anastasiia-gif/MiniFactoryTCF/Code/Web_layer/pictures/wrencked_paper.png

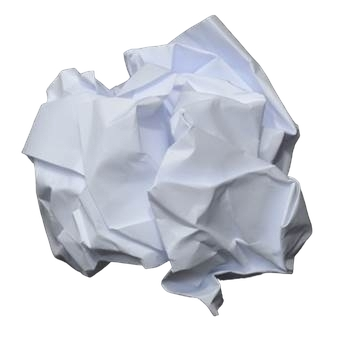
Code/Web_layer/pictures/wrencked_paper.png
