anastasiia-gif/MiniFactoryTCF/Code/Web_layer/pictures/Pneumatics.jpg

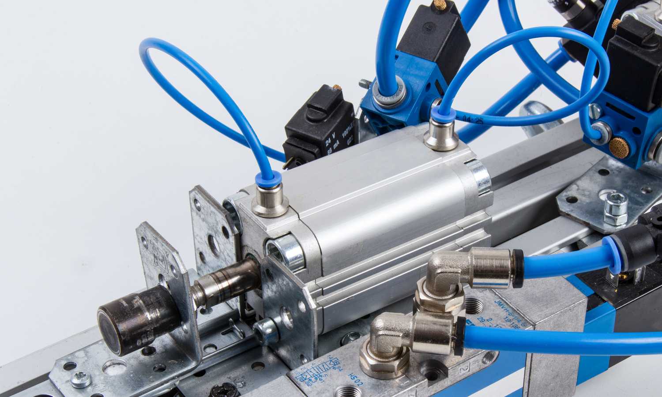
Code/Web_layer/pictures/Pneumatics.jpg
