anastasiia-gif/MiniFactoryTCF/README.md

# 📁 Project Overview – Mini Factory

Welcome to the repository for the Mini Factory educational safety and system enhancement project. This README will help you navigate the folder structure and understand where to find essential project materials.

---

## 📄 Documents Folder

This folder contains all key written reports and planning documents.

- **🔹 REP_MiniFactory** – *Recommended starting point*. This is the main report from the previous internship student and provides a comprehensive overview of the project, including safety implementation, system design, and educational use.
- **🔹 Proeve van Bekwaamheid** – An MBO-level student report referenced by the REP, with additional background and system wiring insights.
- **🔹 PoA (Plan of Approach)** – The initial planning and scoping document from the internship project.
- **🔹 RAR (Risk Assessment Report)** – Details the system’s safety risks and mitigation strategies. Most content is included in the REP.
- **🔹 URS (User Requirements Specification)** – Defines the functional and safety requirements of the system. Mainly embedded in the REP and PoA.

---

## 🛠️ Mechanical Folder

Contains all mechanical CAD files and drawings for system improvements and safety implementations.

- For **part naming and assembly clarity**, please read the [**Assembly Guide**](https://docs.google.com/document/d/1loEIo7aQlHCNWvezpFuo1hC8qLYhPY-sCpMDtRe_vX0/edit?usp=sharing).  
  This guide explains which file corresponds to which physical part and how components fit together.

---

## 📘 Manuals Folder

This includes:

- **Original Bosch Rexroth manuals** for the base Mini Factory system.  
  ⚠️ *Most documents are in German; some have been AI-translated to English for convenience.*
- **Electrical Datasheets** for both the original system and components proposed in the safety upgrade (e.g., relays, contactors, RCDs).

---

## 💻 Code Folder

Contains all software-related files for the project.

- To install or run the software, refer to the [**Software Guide**](https://docs.google.com/document/d/1KuuI0siui7qMMVfnmm_3Qqvq_9LCW6hrh1Kjbssk6QI/edit?usp=sharing).
- For UI/UX mockups and flow:
  - View **Figma page designs**: [Figma Design File](https://www.figma.com/design/H6kHGFZW4rLogu5M2iiK09/MiniFactory?node-id=0-1&t=DzG7h03NYrhDLx07-1)
  - Explore **Customer Research** insights: [Miro Board](https://miro.com/welcomeonboard/dTFMWHFZYzd6UDc4VlF6TEFZcU94RUQ3TitkV3JXTmVidDhWemlRcUMwRXdkUGlLRHpQMWlyazVMOVYzTzZrY3EyblAxSlkrNkd4YWlMUEJodjJlRnpXQWFIb2gyYnRiWEk2W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)

---

## 🏢 BoschRexroth USB

Request Bosch Rexroth USB stick with all the files from previous students how was working on this project. All the other files that were provided to us during training at Bosch Rexroth are uploaded in Bosch RTexroth folder
