anastasiia-gif/MiniFactoryTCF/BoschRexroth/MLC/Properties for variables.pdf

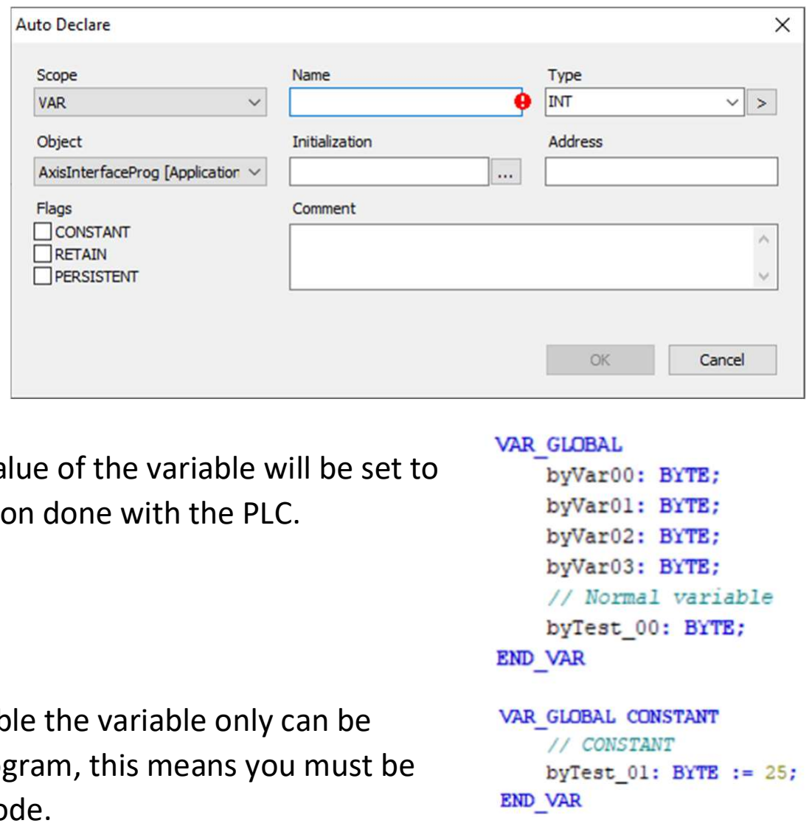
[picture p75: figure]

Document: Properties for variables.docx | Page 1 of 1

Properties for variables.

When declaring a variable there are 4 options to add to a variable.

### 1. Nothing 2. CONSTANT 3. RETAIN 4. PERSISTENT

Explanation of the options:

### 1. When added noting to a variable the value of the variable will be set to

the default* value on almost every action done with the PLC.

### 2. When added “CONSTANT” to the variable the variable only can be

modified by change it in the source program, this means you must be off-line and modify it in the software code.

### 3. When added “RETAIN” to the variable the variable keeps it value also

when the power is being switched off and after a “Warm reset”.
The value will be set to the default* value after a “Reset Origin”,
and “Reset Cold” and after repeated program download.
4. When added “PERSISTANT” to the variable “RETAIN” also must be added to the variable.
When this is done a special global variable list will be added to the system.

The value of the variable will be kept on all time, this means that it will be kept after: a reload of the program, after a download of the program, after a “Reset Warm” and even after a
“Reset Cold!
The only way to reset it to default* is after a “Reset Origin”, but the
PLC is then reset to the factory state, the PLC is completely empty,
included the program!

*Set to “Default” means: the value will bet set to 0 or to the Initialization value. = set to “0” (or “FALSE” for a BOOL) = set to “25”
