anastasiia-gif/MiniFactoryTCF/Code/Web_layer/pictures/airsoft.png

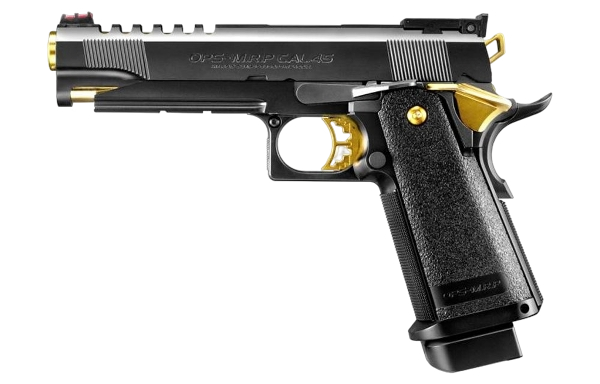
Code/Web_layer/pictures/airsoft.png
