anastasiia-gif/MiniFactoryTCF/Code/Web_layer/pictures/amusement_park.png

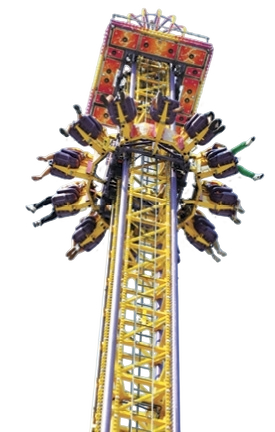
Code/Web_layer/pictures/amusement_park.png
