anastasiia-gif/MiniFactoryTCF/Code/Web_layer/pictures/angry_box.png

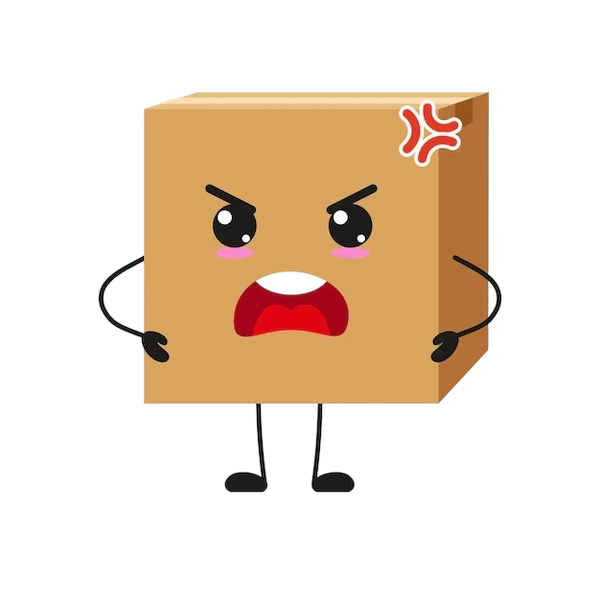
Code/Web_layer/pictures/angry_box.png
