anastasiia-gif/MiniFactoryTCF/Code/Web_layer/pictures/arrow.png

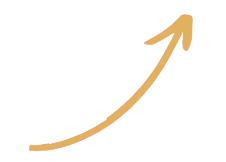
Code/Web_layer/pictures/arrow.png
