anastasiia-gif/MiniFactoryTCF/Code/Web_layer/pictures/award.png

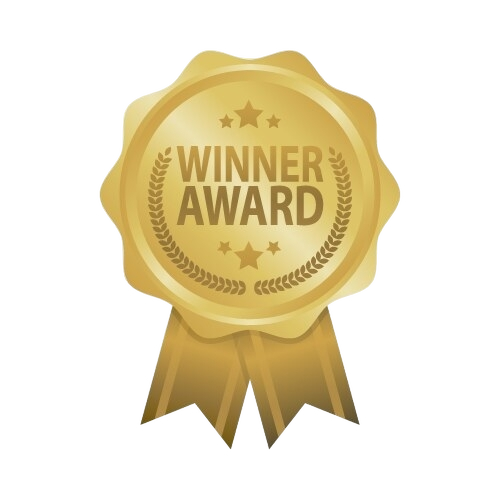
Code/Web_layer/pictures/award.png
