anastasiia-gif/MiniFactoryTCF/Code/Web_layer/pictures/beam_lifting.png

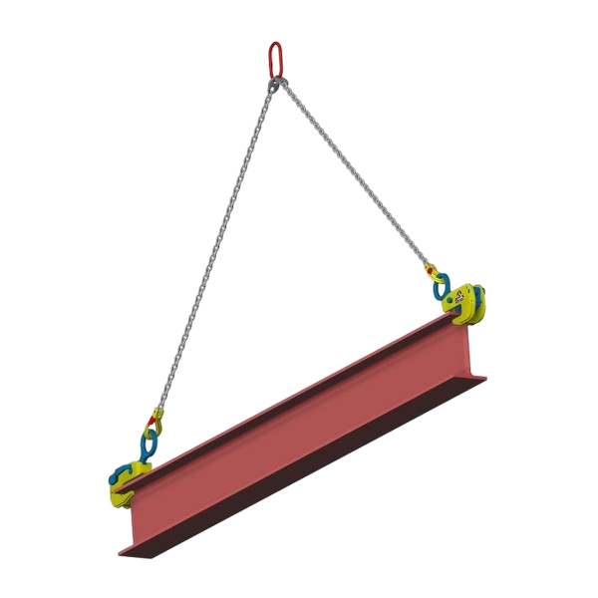
Code/Web_layer/pictures/beam_lifting.png
