anastasiia-gif/MiniFactoryTCF/Code/Web_layer/pictures/box_deposit.png

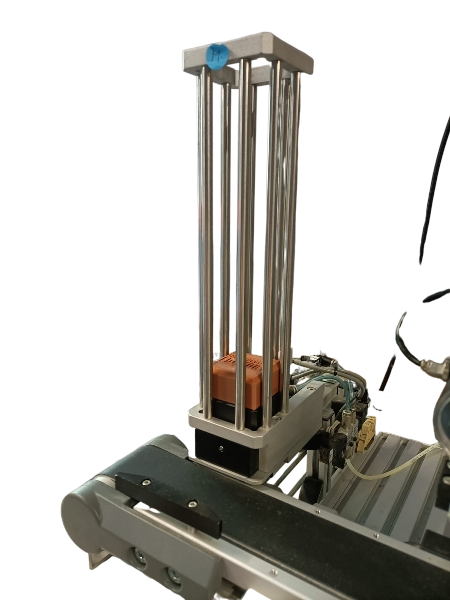
Code/Web_layer/pictures/box_deposit.png
