anastasiia-gif/MiniFactoryTCF/Code/Web_layer/pictures/button_control.png

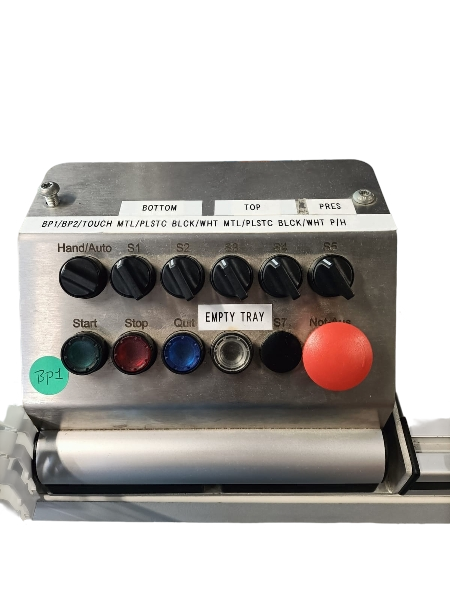
Code/Web_layer/pictures/button_control.png
