anastasiia-gif/MiniFactoryTCF/Code/Web_layer/pictures/calm_box.png

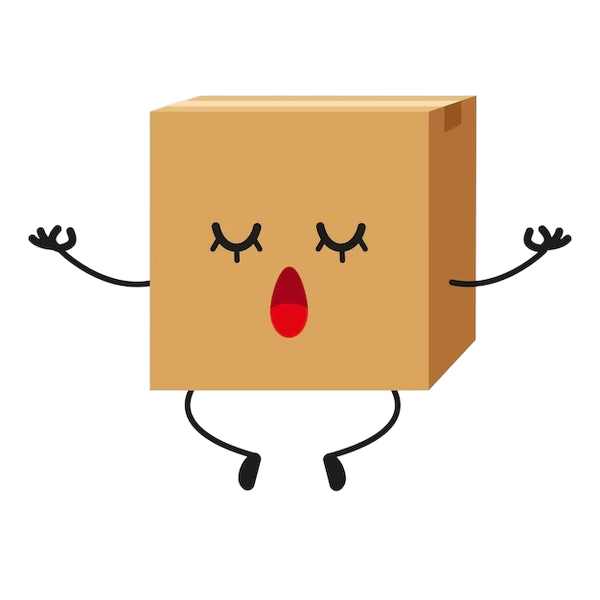
Code/Web_layer/pictures/calm_box.png
