anastasiia-gif/MiniFactoryTCF/Code/Web_layer/pictures/car_jack.png

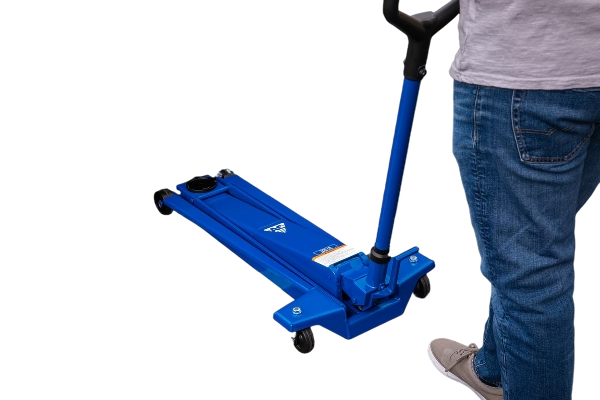
Code/Web_layer/pictures/car_jack.png
