anastasiia-gif/MiniFactoryTCF/Code/Web_layer/pictures/child_straugh.png

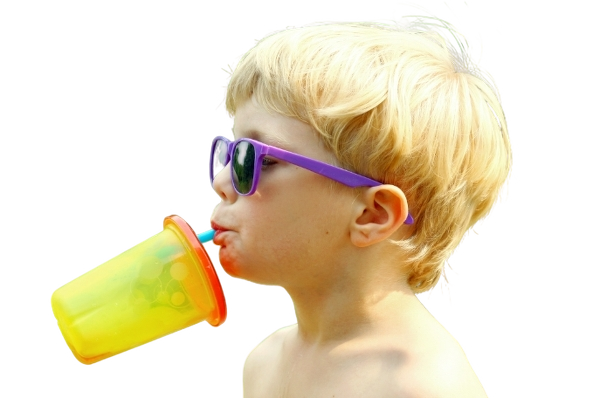
Code/Web_layer/pictures/child_straugh.png
