anastasiia-gif/MiniFactoryTCF/Code/Web_layer/pictures/cnc_door.png

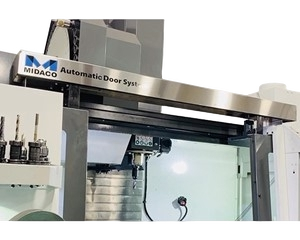
Code/Web_layer/pictures/cnc_door.png
