anastasiia-gif/MiniFactoryTCF/Code/Web_layer/pictures/confused_box.png

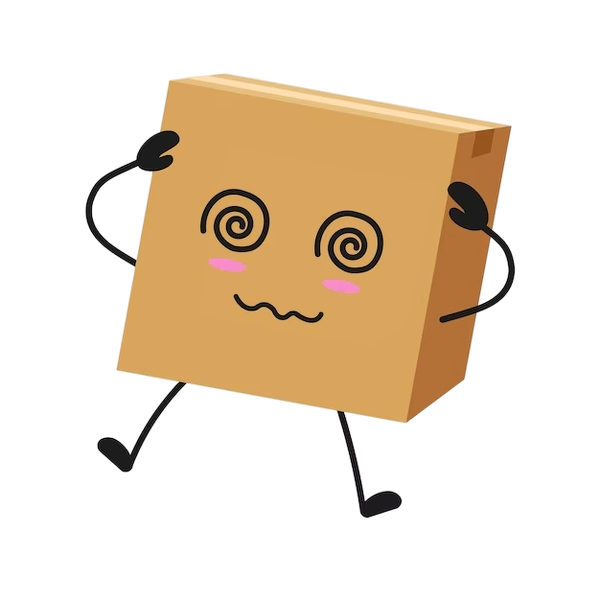
Code/Web_layer/pictures/confused_box.png
