anastasiia-gif/MiniFactoryTCF/Code/Web_layer/pictures/cool_box.png

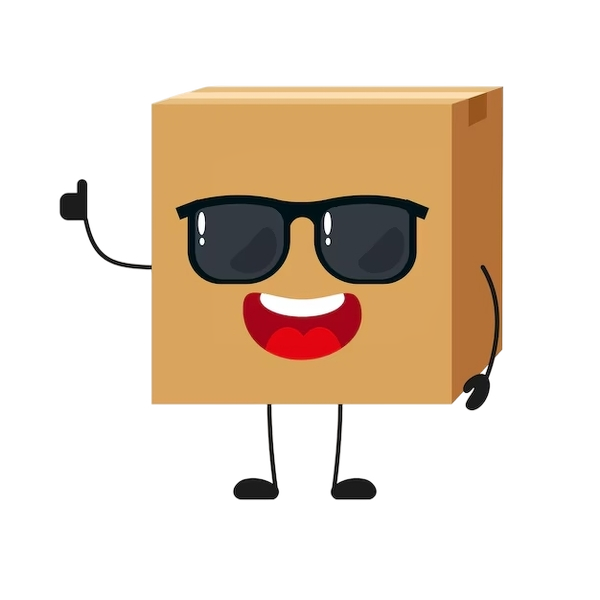
Code/Web_layer/pictures/cool_box.png
