anastasiia-gif/MiniFactoryTCF/Code/Web_layer/pictures/door_closure.png

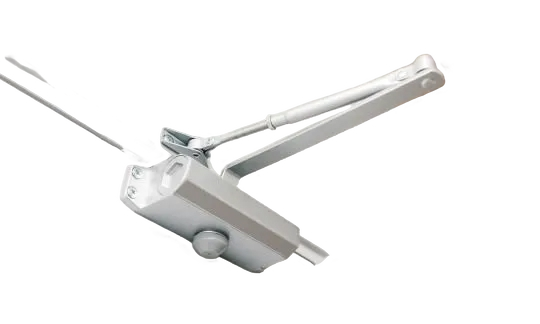
Code/Web_layer/pictures/door_closure.png
