anastasiia-gif/MiniFactoryTCF/Code/Web_layer/pictures/electric_motor.png

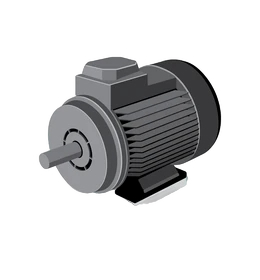
Code/Web_layer/pictures/electric_motor.png
