anastasiia-gif/MiniFactoryTCF/Code/Web_layer/pictures/Emergency_button.png

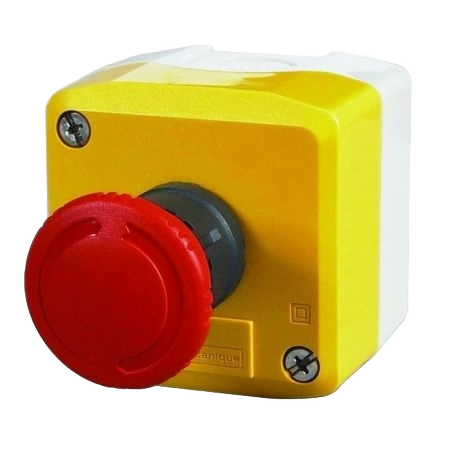
Code/Web_layer/pictures/Emergency_button.png
