anastasiia-gif/MiniFactoryTCF/Code/Web_layer/pictures/english.png

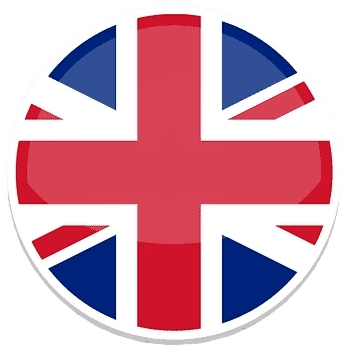
Code/Web_layer/pictures/english.png
