anastasiia-gif/MiniFactoryTCF/Code/Web_layer/pictures/exited_box.png

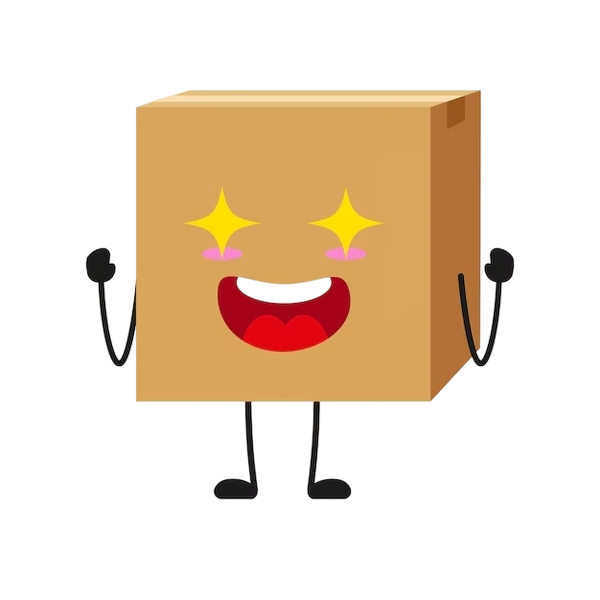
Code/Web_layer/pictures/exited_box.png
