anastasiia-gif/MiniFactoryTCF/Code/Web_layer/pictures/forklift.png

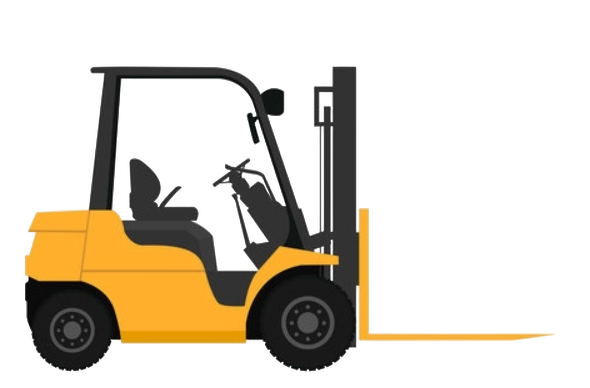
Code/Web_layer/pictures/forklift.png
