anastasiia-gif/MiniFactoryTCF/Code/Web_layer/pictures/happy_box.png

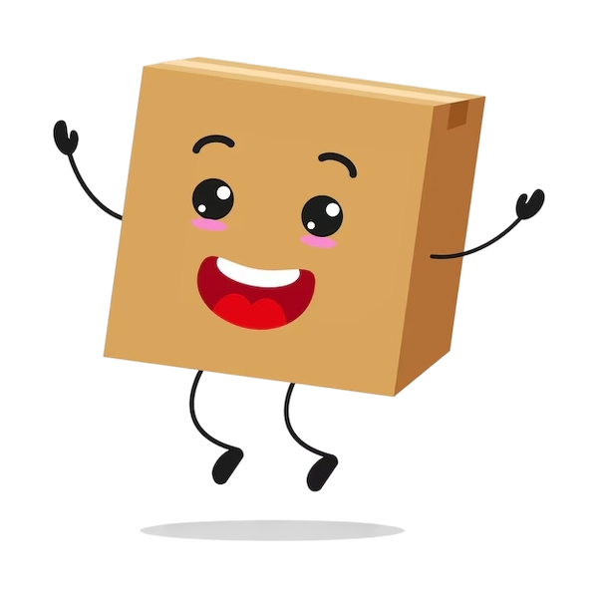
Code/Web_layer/pictures/happy_box.png
