anastasiia-gif/MiniFactoryTCF/Code/Web_layer/pictures/Hydraulics.jpg

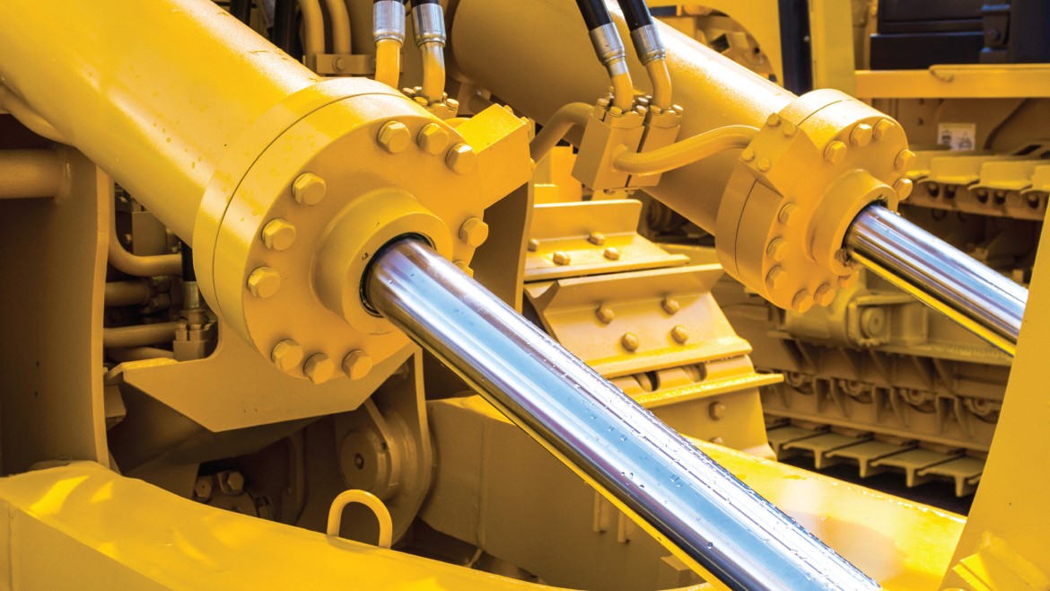
Code/Web_layer/pictures/Hydraulics.jpg
