anastasiia-gif/MiniFactoryTCF/Code/Web_layer/pictures/hydraulics_rotary.png

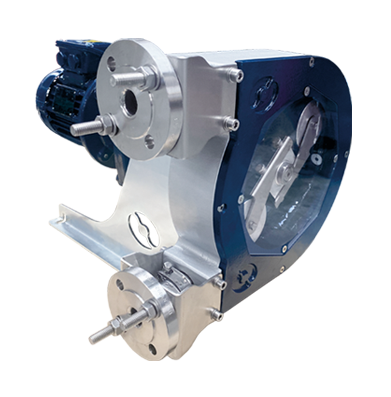
Code/Web_layer/pictures/hydraulics_rotary.png
