anastasiia-gif/MiniFactoryTCF/Code/Web_layer/pictures/linear_mover.png

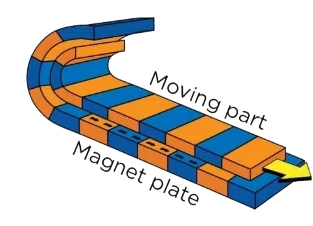
Code/Web_layer/pictures/linear_mover.png
