anastasiia-gif/MiniFactoryTCF/Code/Web_layer/pictures/magnetic_train.png

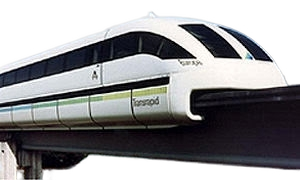
Code/Web_layer/pictures/magnetic_train.png
