anastasiia-gif/MiniFactoryTCF/Code/Web_layer/pictures/metal_box.png

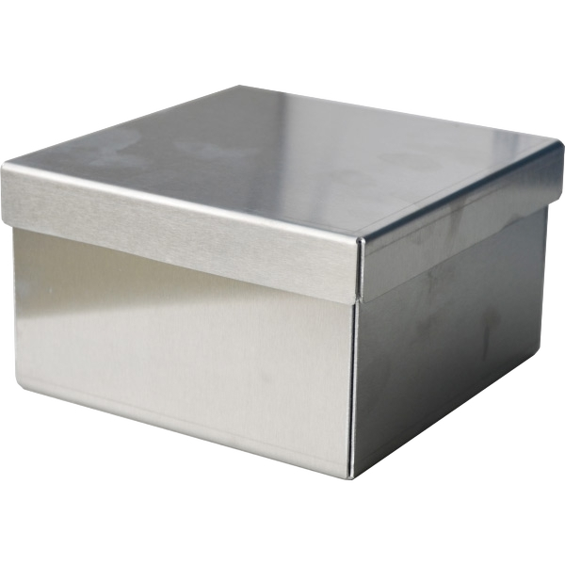
Code/Web_layer/pictures/metal_box.png
