anastasiia-gif/MiniFactoryTCF/Code/Web_layer/pictures/motor.png

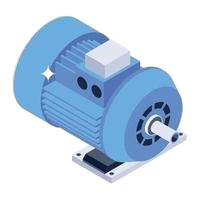
Code/Web_layer/pictures/motor.png
