anastasiia-gif/MiniFactoryTCF/Code/Web_layer/pictures/plastic_box.png

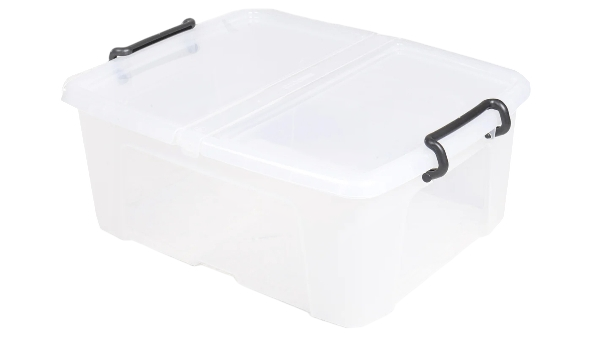
Code/Web_layer/pictures/plastic_box.png
