anastasiia-gif/MiniFactoryTCF/Code/Web_layer/pictures/plastic_cup.png

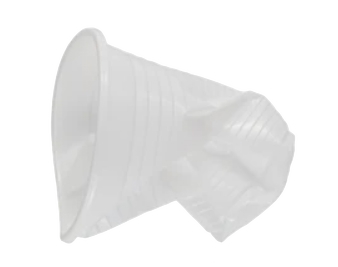
Code/Web_layer/pictures/plastic_cup.png
