anastasiia-gif/MiniFactoryTCF/Code/Web_layer/pictures/PLC.png

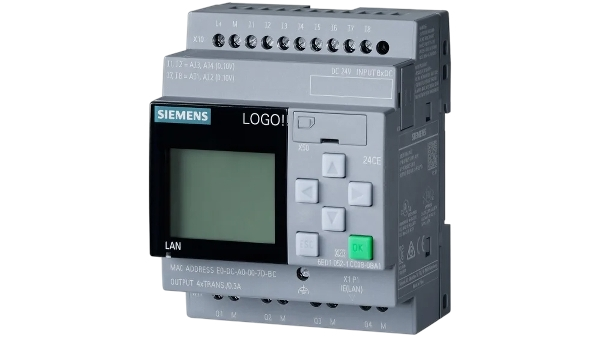
Code/Web_layer/pictures/PLC.png
