anastasiia-gif/MiniFactoryTCF/Code/Web_layer/pictures/pneumatic_cylinder.png

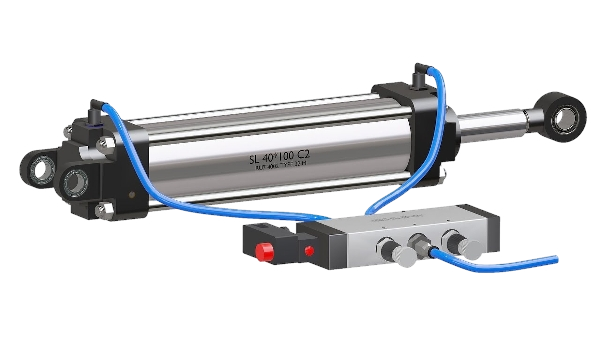
Code/Web_layer/pictures/pneumatic_cylinder.png
