anastasiia-gif/MiniFactoryTCF/Code/Web_layer/pictures/pneumatics_rotary.png

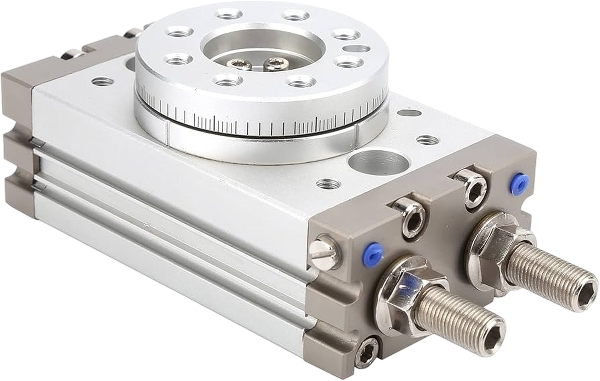
Code/Web_layer/pictures/pneumatics_rotary.png
