anastasiia-gif/MiniFactoryTCF/Code/Web_layer/pictures/RGB.png

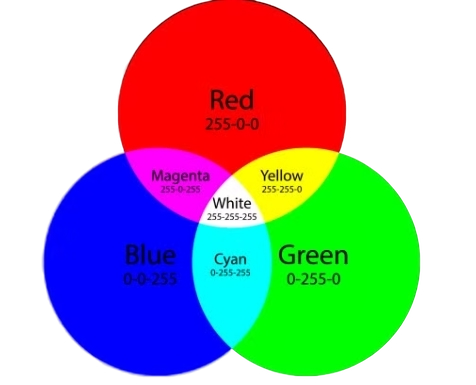
Code/Web_layer/pictures/RGB.png
