anastasiia-gif/MiniFactoryTCF/Code/Web_layer/pictures/sad_box.png

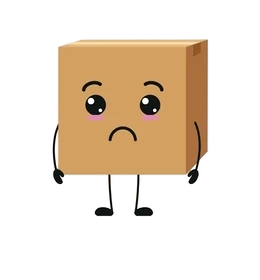
Code/Web_layer/pictures/sad_box.png
