anastasiia-gif/MiniFactoryTCF/Code/Web_layer/pictures/safety_closes.png

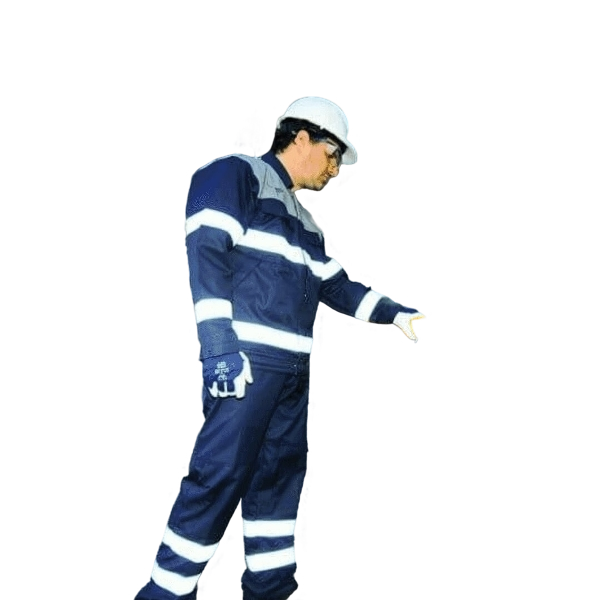
Code/Web_layer/pictures/safety_closes.png
