anastasiia-gif/MiniFactoryTCF/Code/Web_layer/pictures/safety_glasses.png

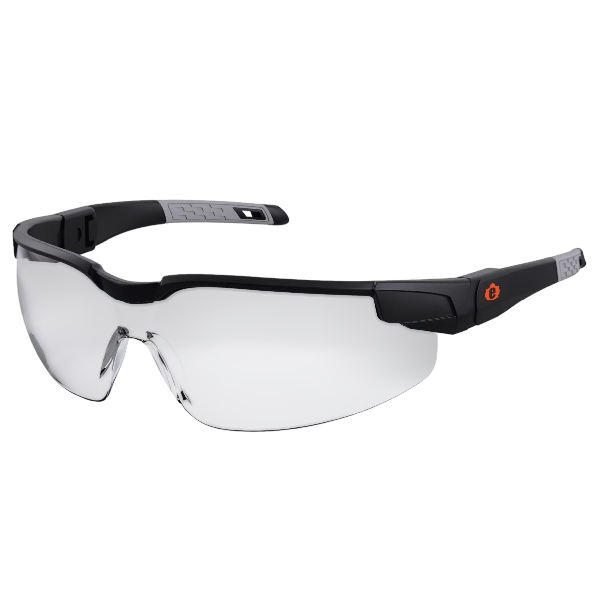
Code/Web_layer/pictures/safety_glasses.png
