anastasiia-gif/MiniFactoryTCF/Code/Web_layer/pictures/safety_gloves.png

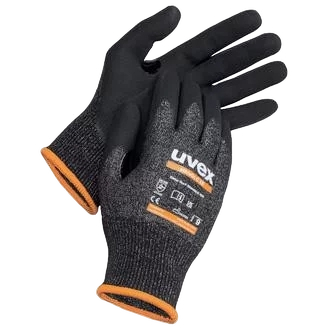
Code/Web_layer/pictures/safety_gloves.png
