anastasiia-gif/MiniFactoryTCF/Code/Web_layer/pictures/safety_shoes.png

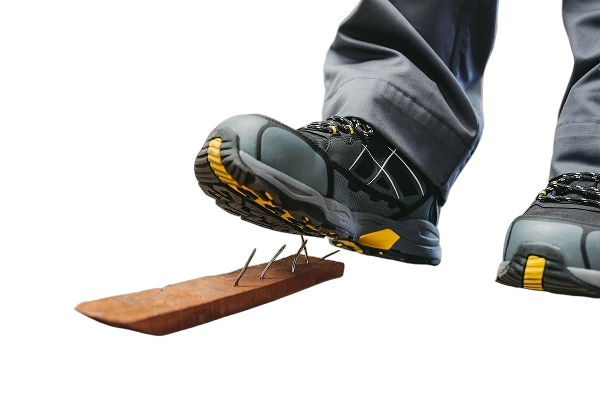
Code/Web_layer/pictures/safety_shoes.png
