anastasiia-gif/MiniFactoryTCF/Code/Web_layer/pictures/sensor.png

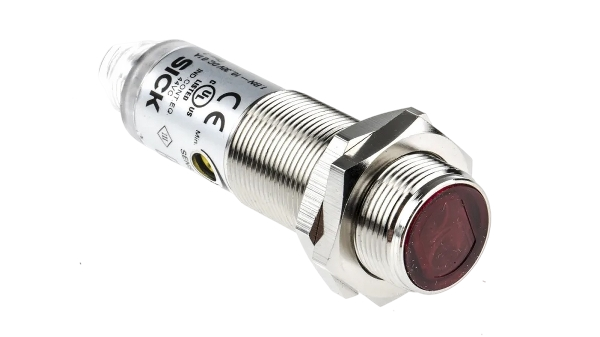
Code/Web_layer/pictures/sensor.png
