anastasiia-gif/MiniFactoryTCF/Code/Web_layer/pictures/sensors.png

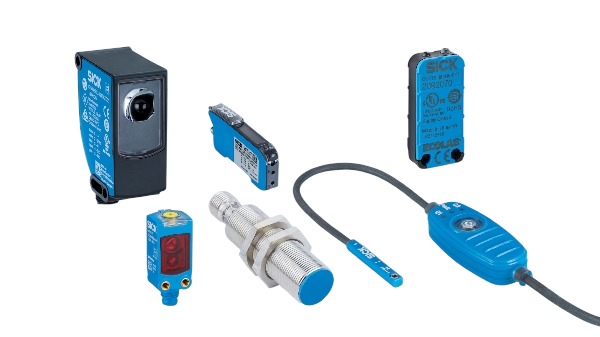
Code/Web_layer/pictures/sensors.png
