anastasiia-gif/MiniFactoryTCF/Code/Web_layer/pictures/shaping_metal.jpg

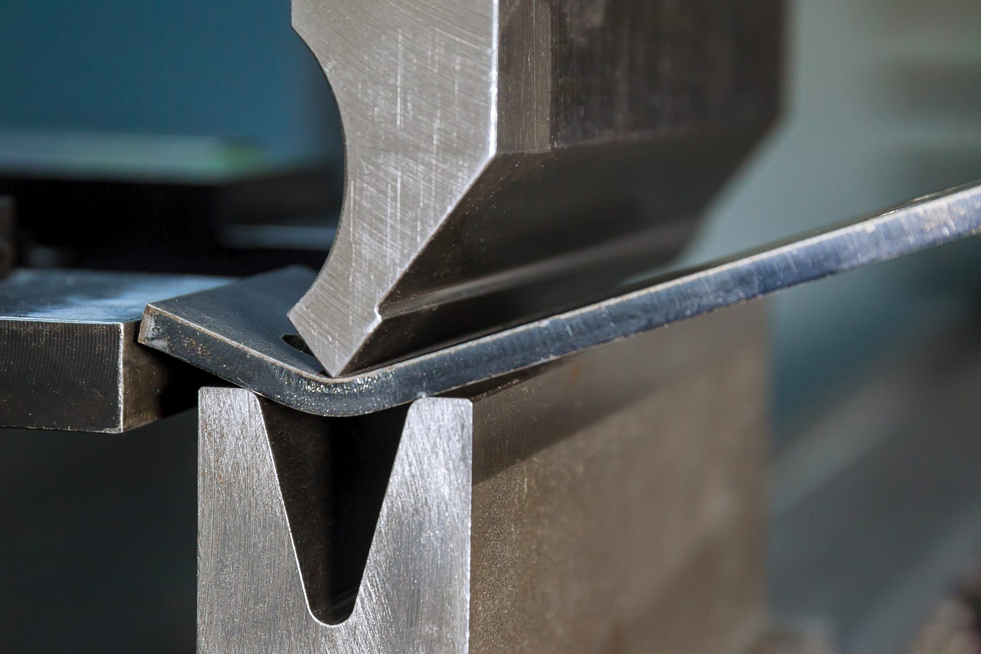
Code/Web_layer/pictures/shaping_metal.jpg
