anastasiia-gif/MiniFactoryTCF/Code/Web_layer/pictures/skyline.png

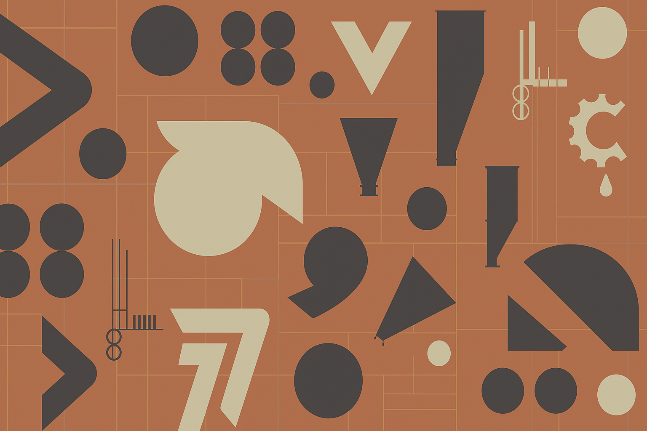
Code/Web_layer/pictures/skyline.png
