anastasiia-gif/MiniFactoryTCF/Code/Web_layer/pictures/smart_box.png

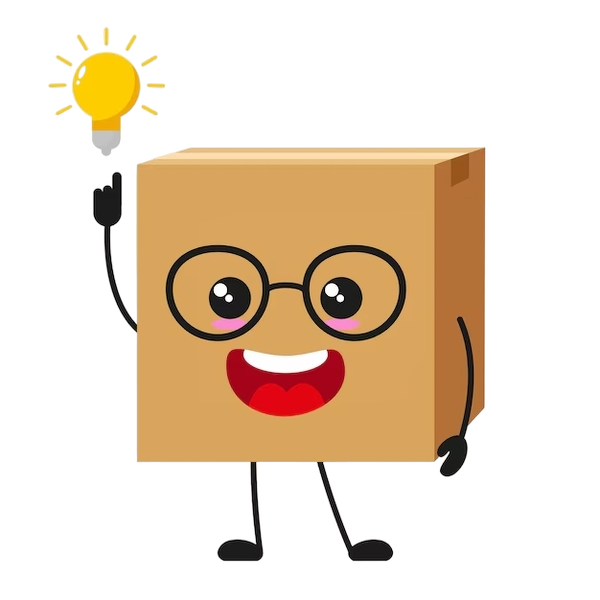
Code/Web_layer/pictures/smart_box.png
