anastasiia-gif/MiniFactoryTCF/Code/Web_layer/pictures/sponge.webp

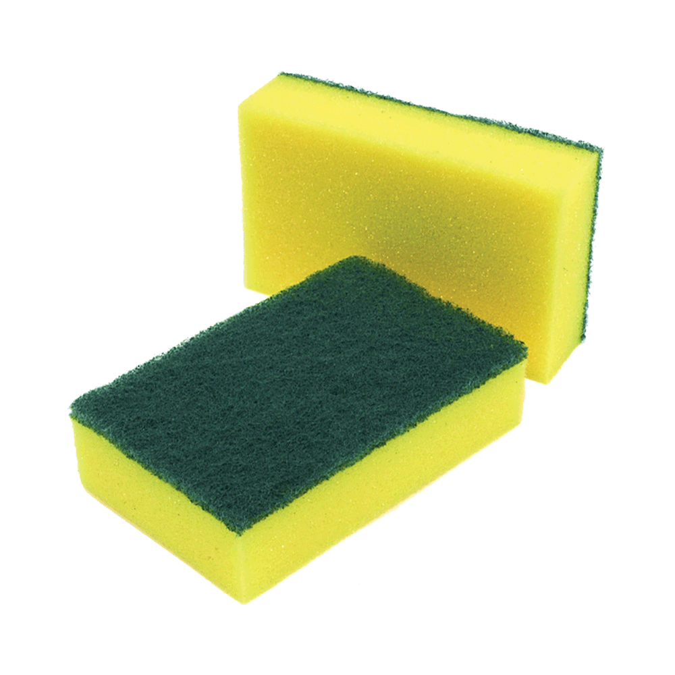
Code/Web_layer/pictures/sponge.webp
