anastasiia-gif/MiniFactoryTCF/Code/Web_layer/pictures/tractor.png

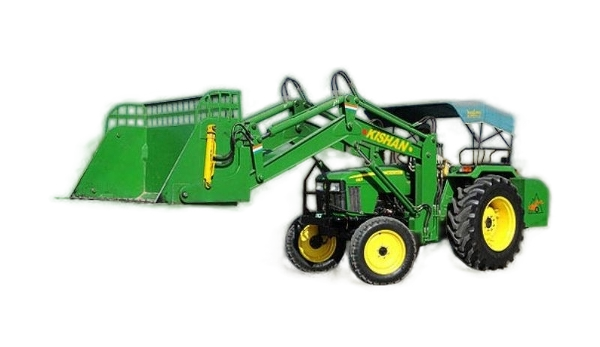
Code/Web_layer/pictures/tractor.png
