anastasiia-gif/MiniFactoryTCF/Mechanical/Safety/Main_expo/Dividers/Dividers_electrical_box/Main_exposition_inside_right_cover.SLDPRT

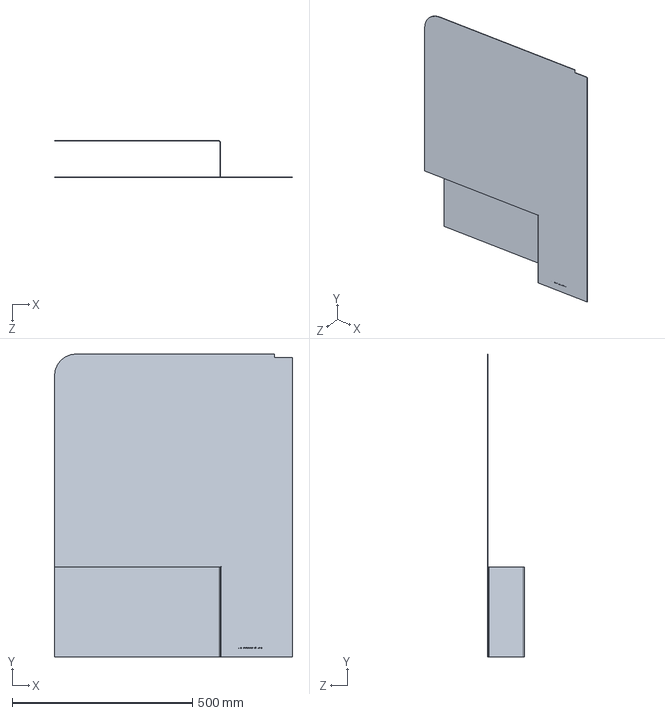
[picture p121: CAD file, 2025-07-18]
Mechanical/Safety/Main_expo/Dividers/Dividers_electrical_box/Main_exposition_inside_right_cover.SLDPRT
660.0 x 840.0 x 101.5 mm
