anastasiia-gif/MiniFactoryTCF/Mechanical/Safety/Main_expo/Dividers/Dividers_electrical_box/Manufacturable parts/Main_exposition_inside_right_cover.DXF

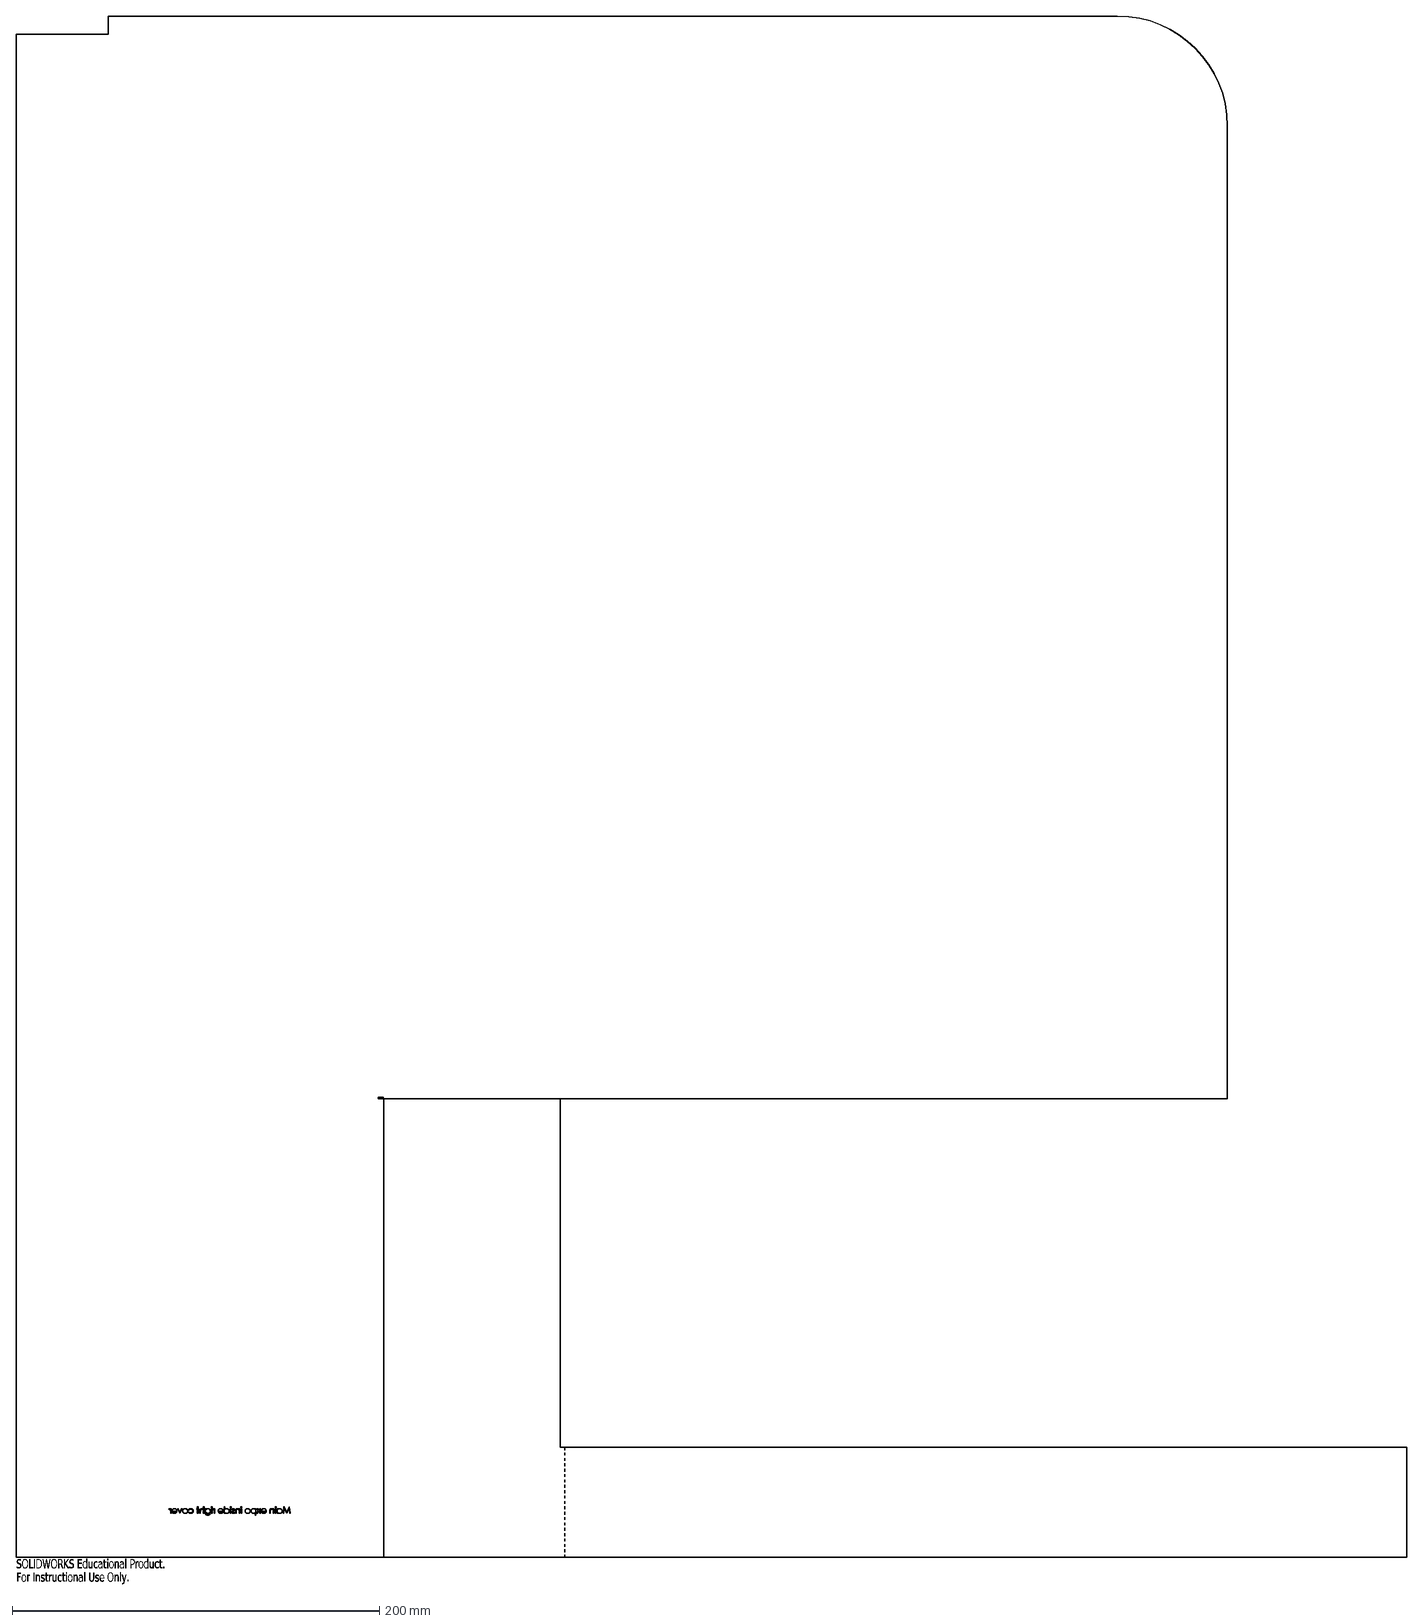
[picture p122: CAD file, 2025-07-18]
Mechanical/Safety/Main_expo/Dividers/Dividers_electrical_box/Manufacturable parts/Main_exposition_inside_right_cover.DXF
SOLIDWORKS Educational Product.
For Instructional Use Only.
