anastasiia-gif/MiniFactoryTCF/Mechanical/Safety/Main_expo/Dividers/Dividers_electrical_box/Main_exposition_inside_left_cover.SLDPRT

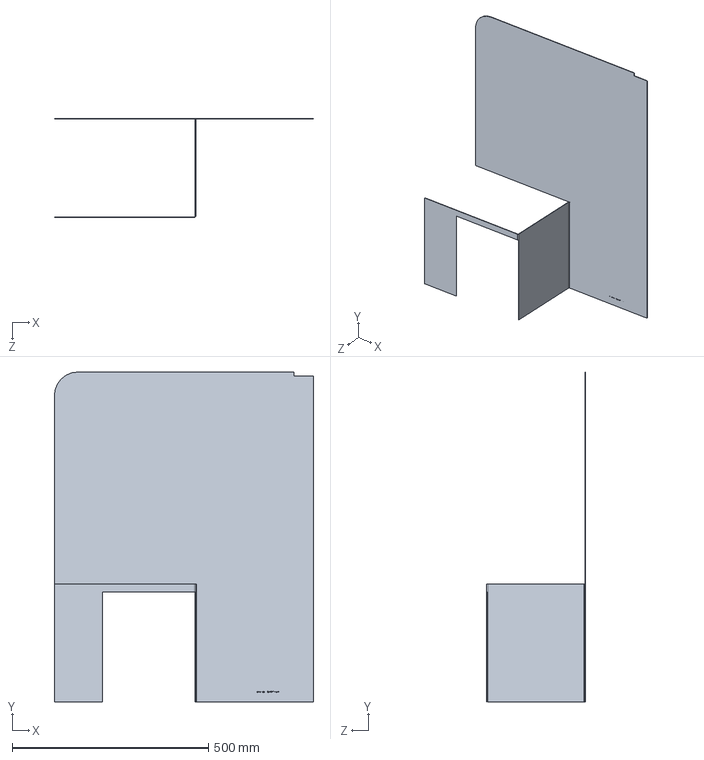
[picture p123: CAD file, 2025-05-16]
Mechanical/Safety/Main_expo/Dividers/Dividers_electrical_box/Main_exposition_inside_left_cover.SLDPRT
660.0 x 840.0 x 251.5 mm
