anastasiia-gif/MiniFactoryTCF/Mechanical/Safety/Main_expo/Dividers/Dividers_electrical_box/Manufacturable parts/Main_exposition_left_closing.DXF

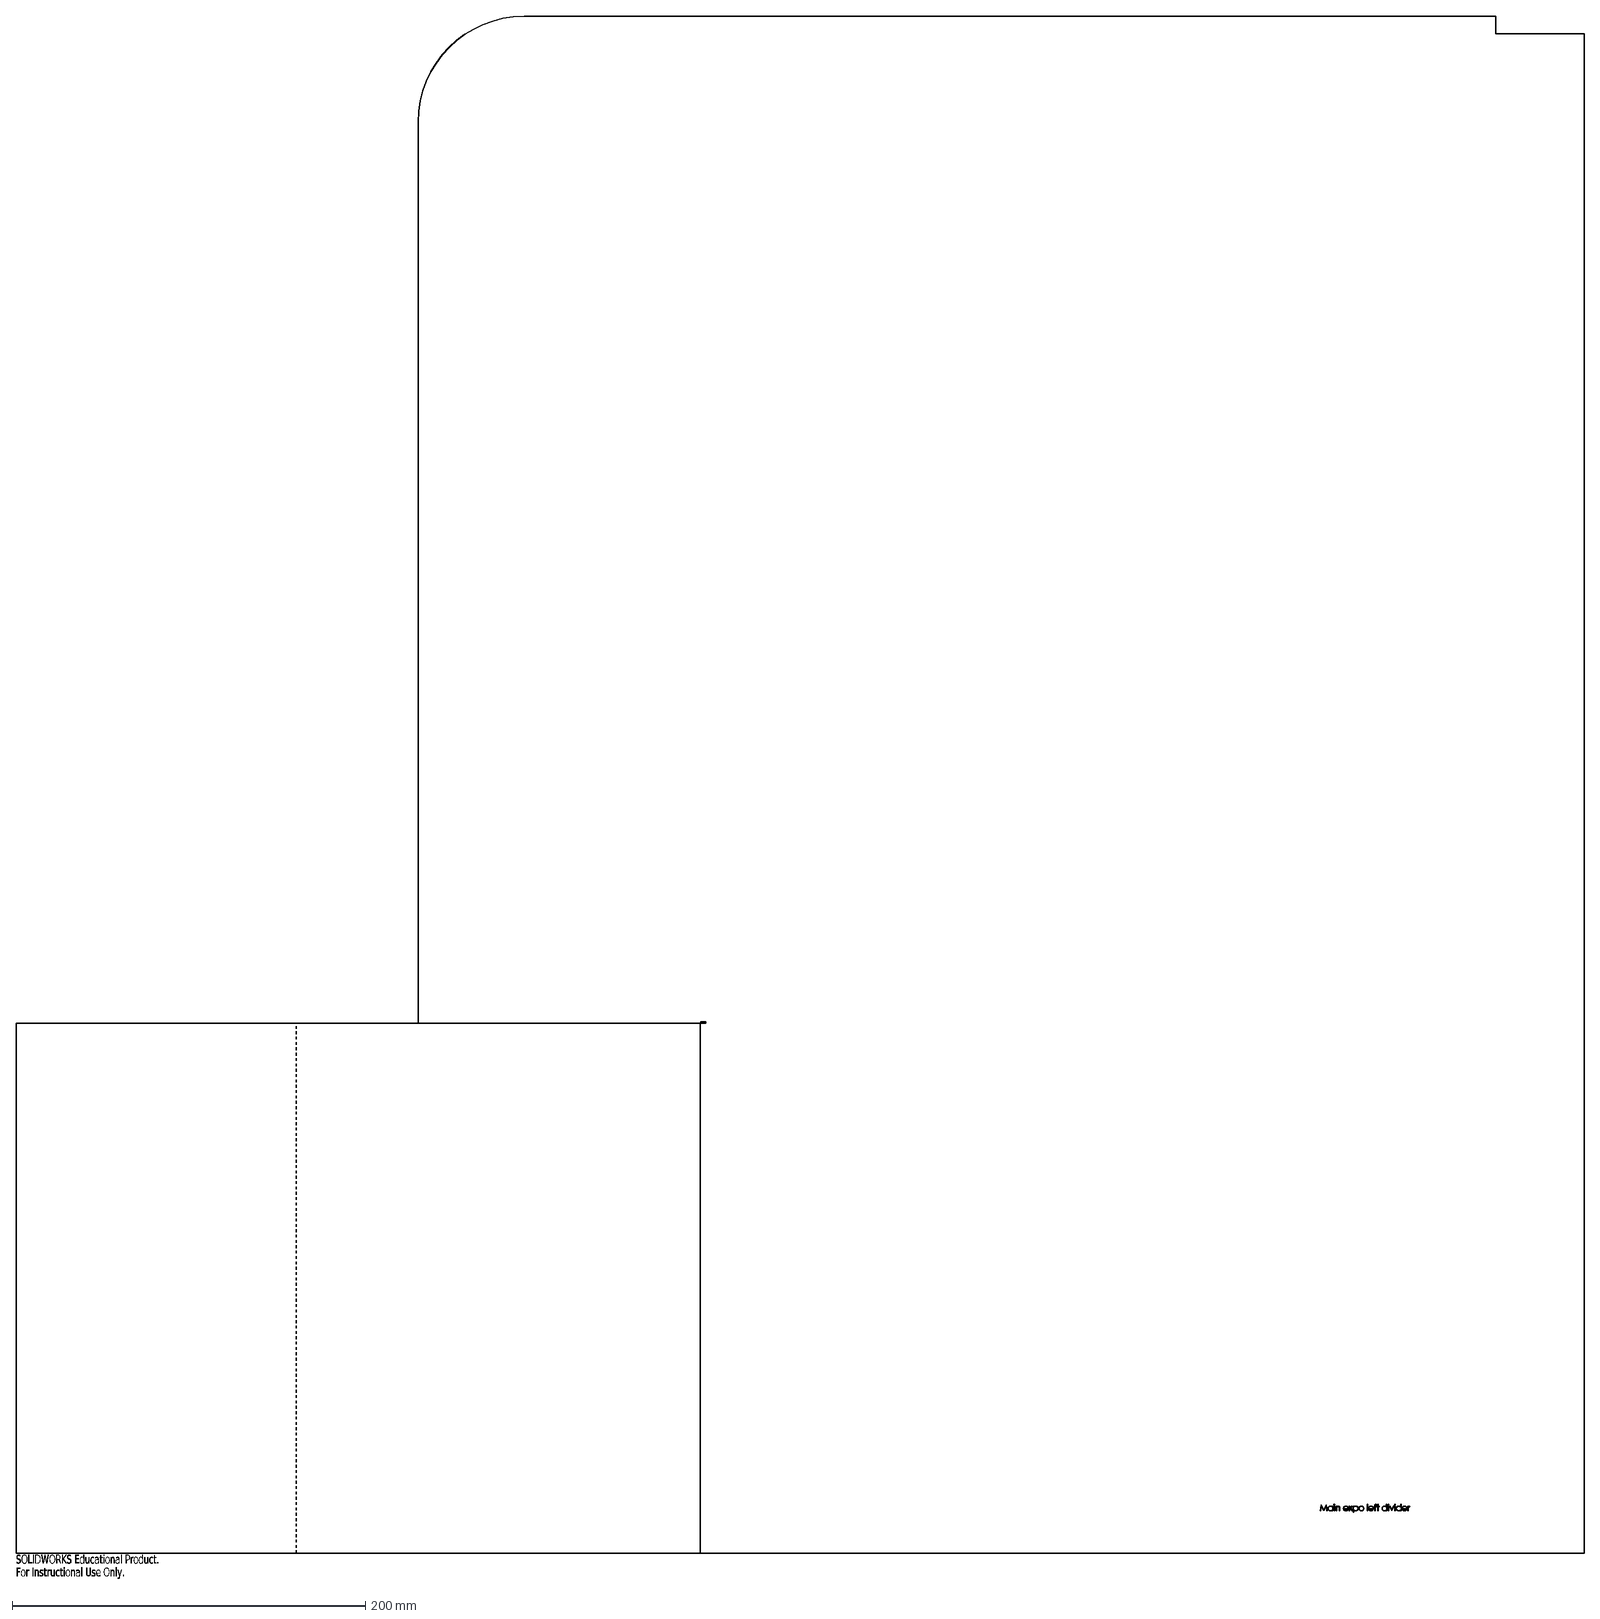
[picture p124: CAD file, 2025-05-16]
Mechanical/Safety/Main_expo/Dividers/Dividers_electrical_box/Manufacturable parts/Main_exposition_left_closing.DXF
SOLIDWORKS Educational Product.
For Instructional Use Only.
