anastasiia-gif/MiniFactoryTCF/Mechanical/Safety/Main_expo/Doors/door/Assem_door.SLDASM

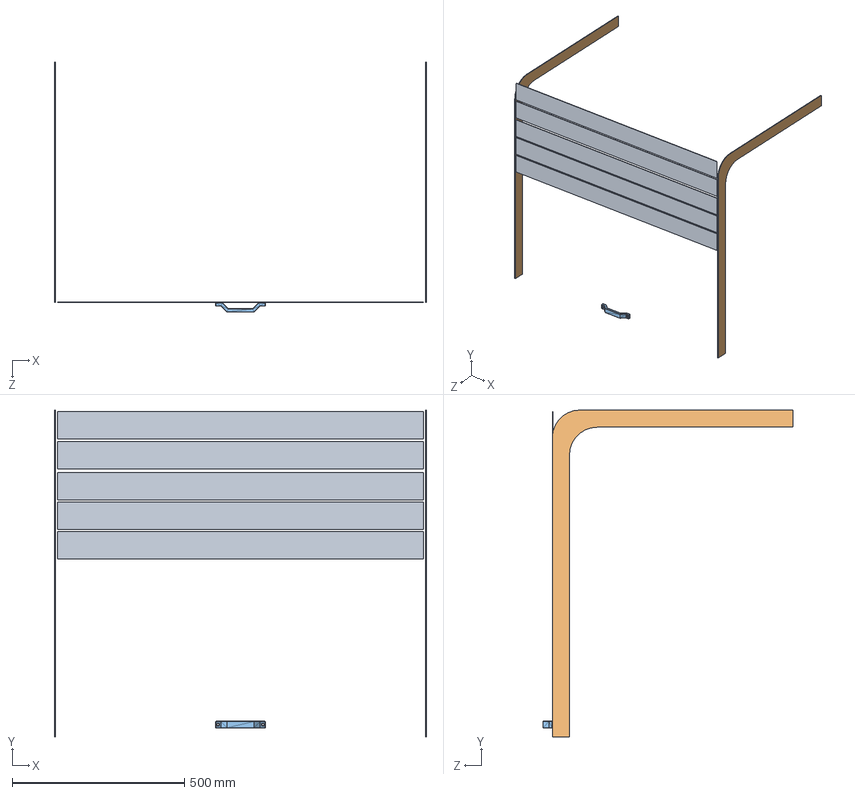
[picture p125: CAD file, 2025-05-16]
Mechanical/Safety/Main_expo/Doors/door/Assem_door.SLDASM
1081.0 x 950.0 x 727.5 mm
Barn_Door_Handle
Guide_for_doors x 2
small_screens_right_x5 x 5
