anastasiia-gif/MiniFactoryTCF/Mechanical/Safety/Main_expo/Dividers/Dividers_electrical_box/Main_expo_right_top.SLDPRT

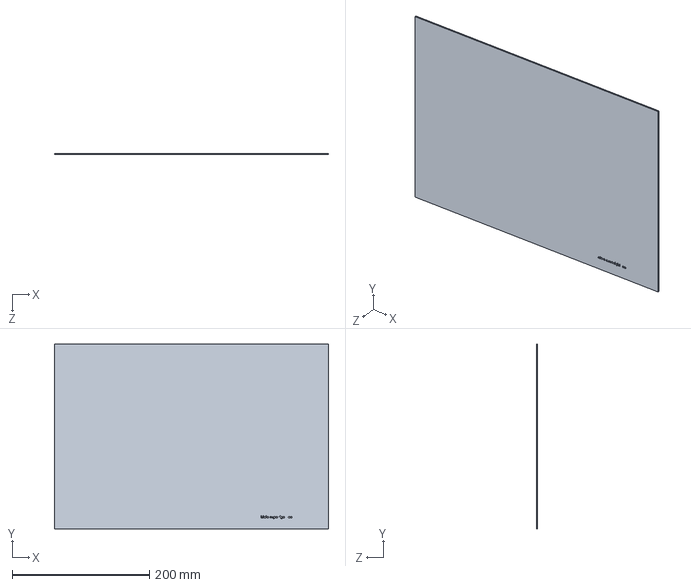
[picture p126: CAD file, 2025-05-16]
Mechanical/Safety/Main_expo/Dividers/Dividers_electrical_box/Main_expo_right_top.SLDPRT
400.0 x 270.0 x 2.00 mm
