anastasiia-gif/MiniFactoryTCF/Mechanical/Safety/Main_expo/Dividers/Dividers_electrical_box/Manufacturable parts/Main_expo_inside_left_top.DXF

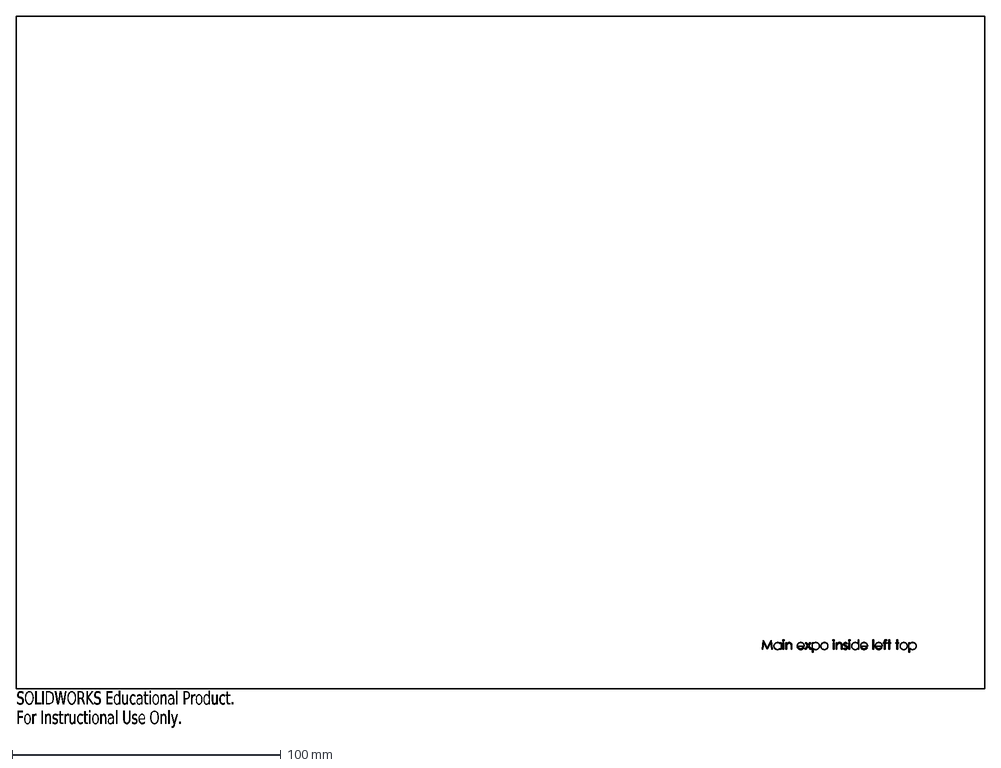
[picture p127: CAD file, 2025-05-16]
Mechanical/Safety/Main_expo/Dividers/Dividers_electrical_box/Manufacturable parts/Main_expo_inside_left_top.DXF
SOLIDWORKS Educational Product.
For Instructional Use Only.
