anastasiia-gif/MiniFactoryTCF/Mechanical/Safety/Main_expo/Dividers/Dividers_electrical_box/Assembly_main_expo.SLDASM

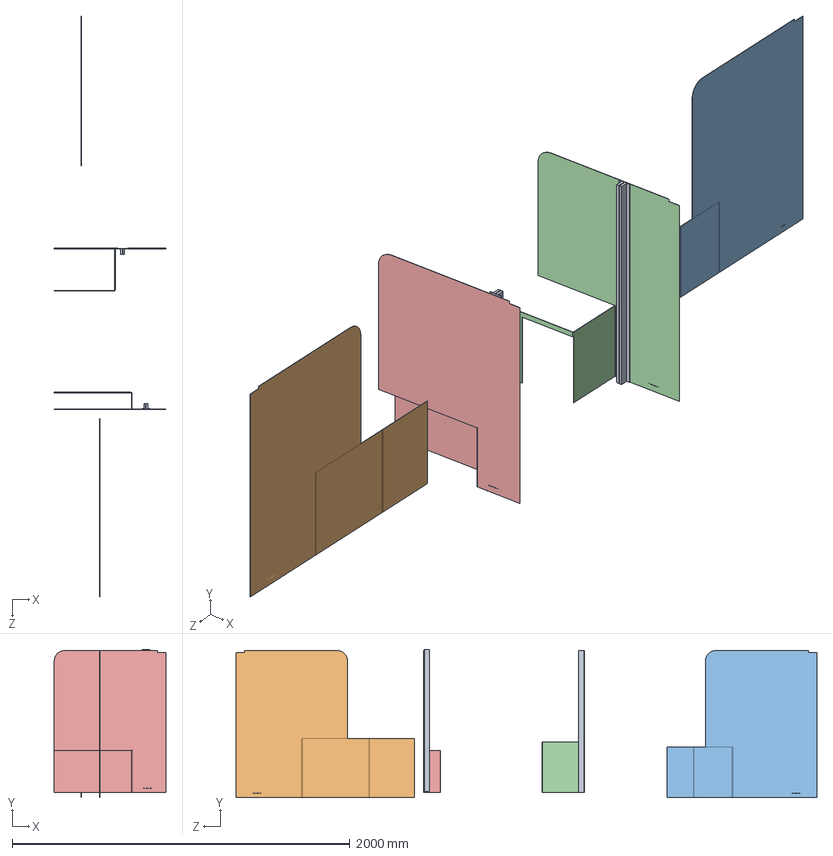
[picture p128: CAD file, 2025-05-16]
Mechanical/Safety/Main_expo/Dividers/Dividers_electrical_box/Assembly_main_expo.SLDASM
660.0 x 876.9 x 3438.5 mm
Main_exposition_inside_right_cover
Main_exposition_inside_left_cover
Main_exposition_left_closing
Main_exposition_right_closing
Railing_electrical_box x 2
