anastasiia-gif/MiniFactoryTCF/Mechanical/Safety/Main_expo/Dividers/Dividers_electrical_box/Main_exposition_left_closing.SLDPRT

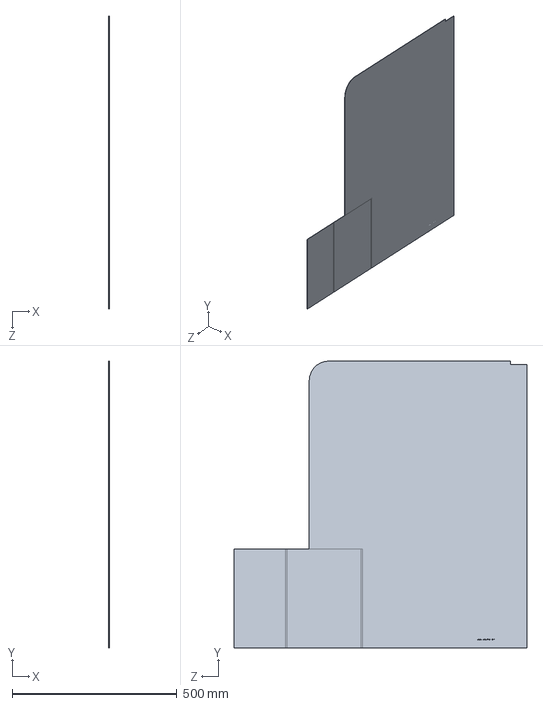
[picture p130: CAD file, 2025-05-16]
Mechanical/Safety/Main_expo/Dividers/Dividers_electrical_box/Main_exposition_left_closing.SLDPRT
1.50 x 870.0 x 887.6 mm
