anastasiia-gif/MiniFactoryTCF/Mechanical/Main_expo_sides/Back decorations/dxf_manufacturing/Main_cover_body.DXF

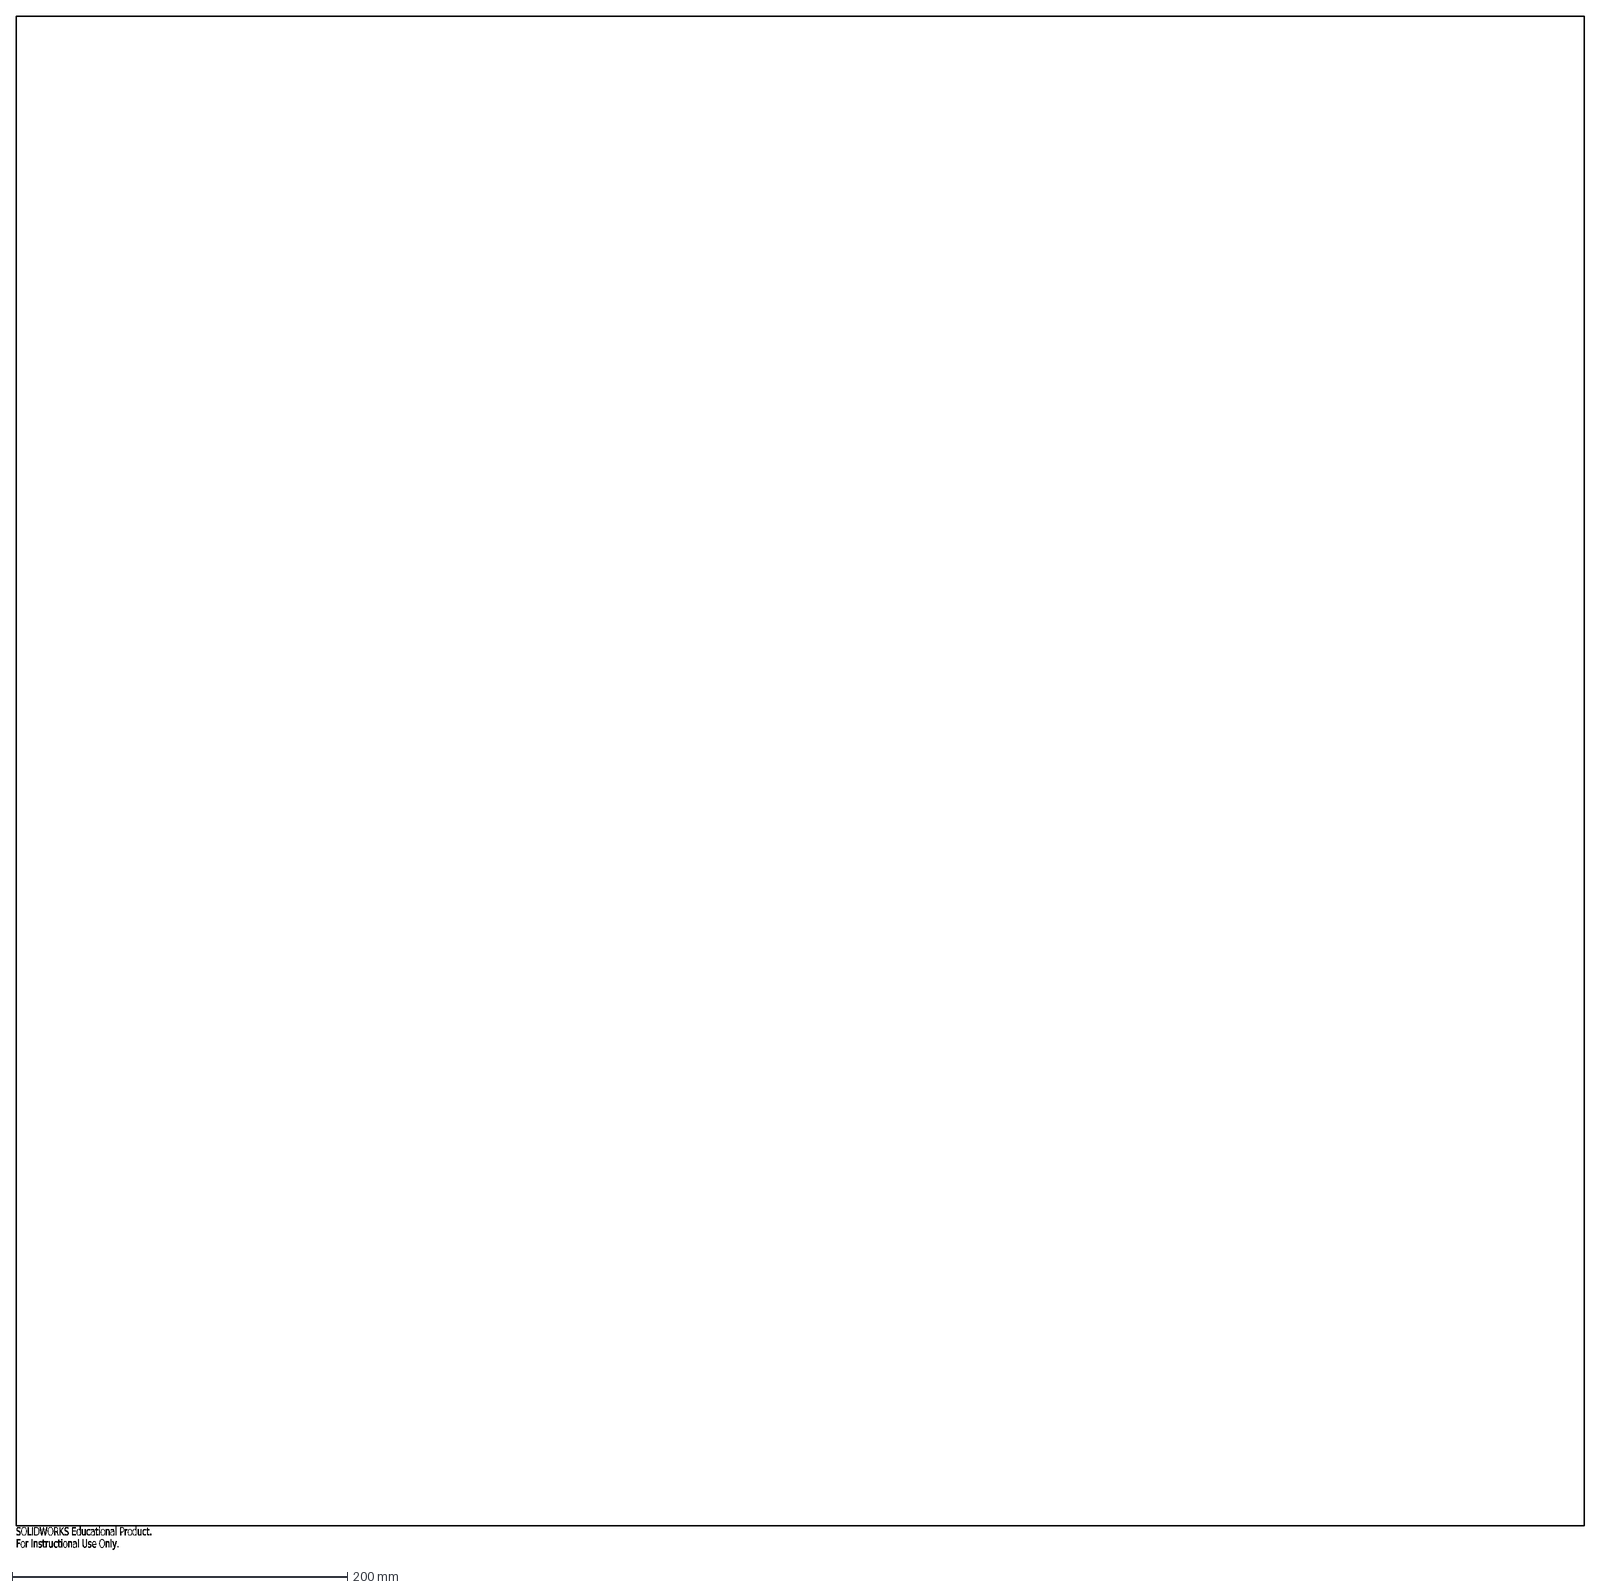
[picture p132: CAD file, 2025-05-16]
Mechanical/Main_expo_sides/Back decorations/dxf_manufacturing/Main_cover_body.DXF
SOLIDWORKS Educational Product.
For Instructional Use Only.
