anastasiia-gif/MiniFactoryTCF/Mechanical/Safety/Main_expo/Dividers/Dividers_electrical_box/Main_exposition_right_closing.SLDPRT

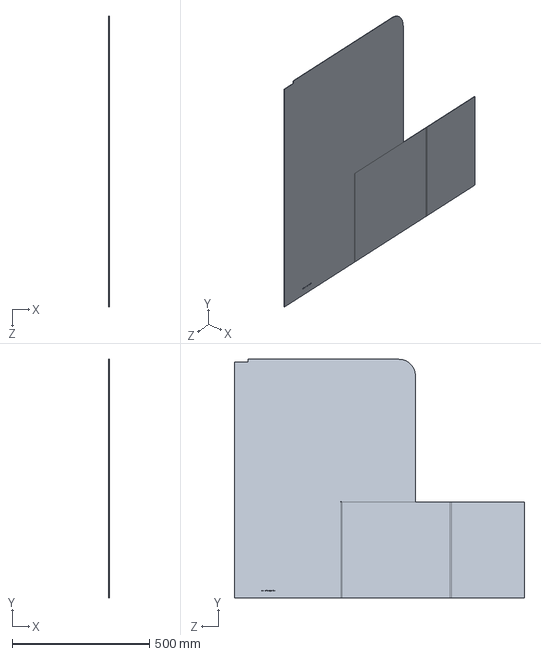
[picture p133: CAD file, 2025-05-16]
Mechanical/Safety/Main_expo/Dividers/Dividers_electrical_box/Main_exposition_right_closing.SLDPRT
1.50 x 870.0 x 1057.6 mm
