anastasiia-gif/MiniFactoryTCF/Mechanical/Safety/Main_expo/Dividers/Dividers_electrical_box/Manufacturable parts/Main_exposition_inside_left_cover.DXF

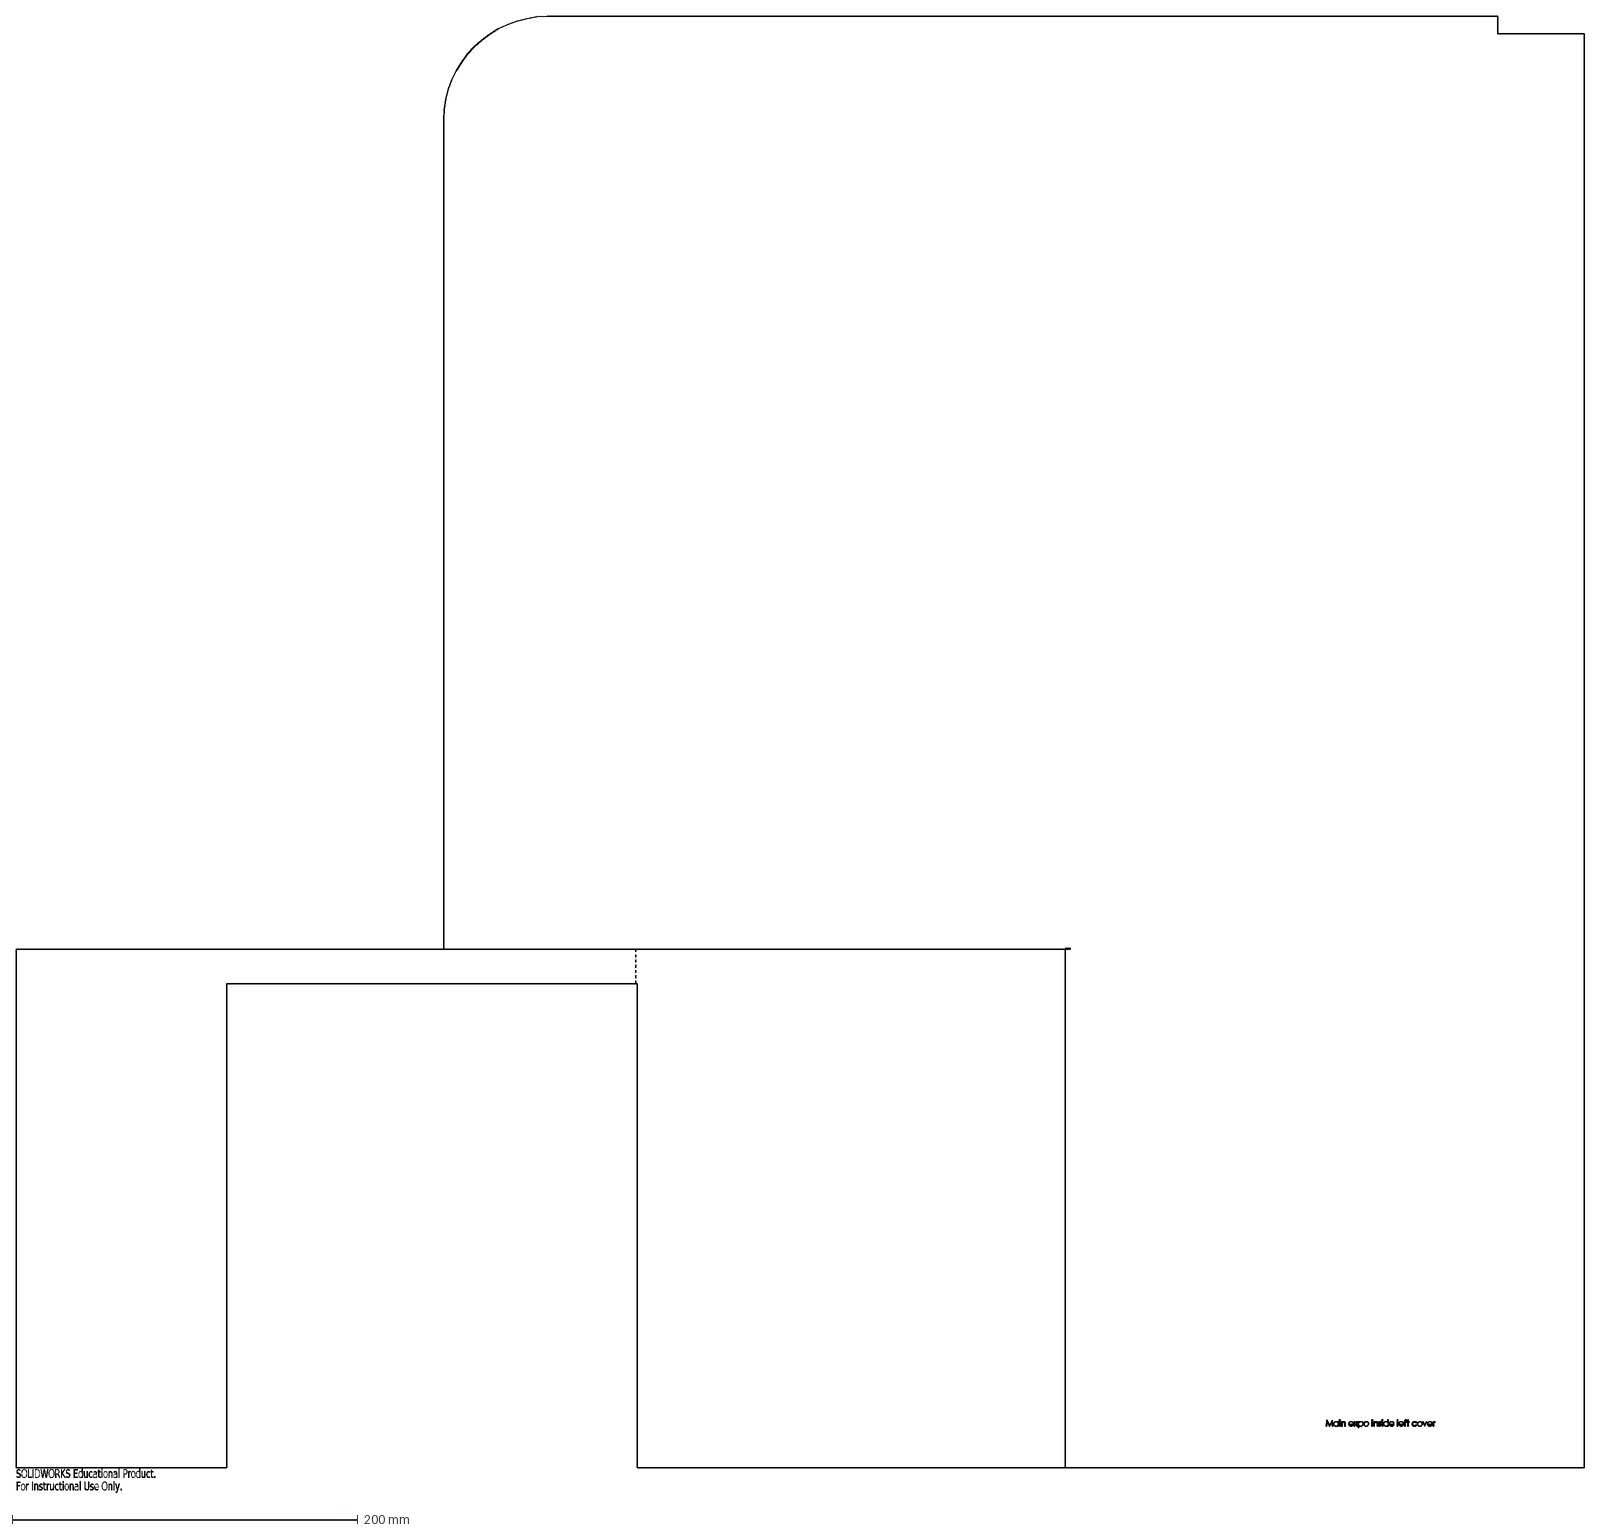
[picture p134: CAD file, 2025-05-16]
Mechanical/Safety/Main_expo/Dividers/Dividers_electrical_box/Manufacturable parts/Main_exposition_inside_left_cover.DXF
SOLIDWORKS Educational Product.
For Instructional Use Only.
