anastasiia-gif/MiniFactoryTCF/Mechanical/Safety/Main_expo/Dividers/Dividers_electrical_box/Main_expo_inside_left_top.SLDPRT

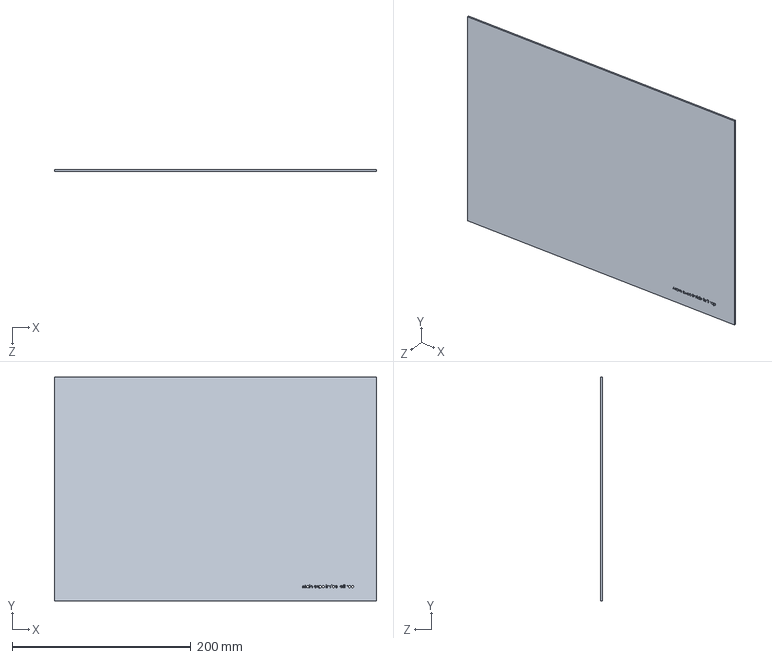
[picture p135: CAD file, 2025-05-16]
Mechanical/Safety/Main_expo/Dividers/Dividers_electrical_box/Main_expo_inside_left_top.SLDPRT
360.0 x 250.0 x 2.00 mm
