anastasiia-gif/MiniFactoryTCF/Mechanical/Main_expo_sides/Back decorations/Main_cover_body.SLDPRT

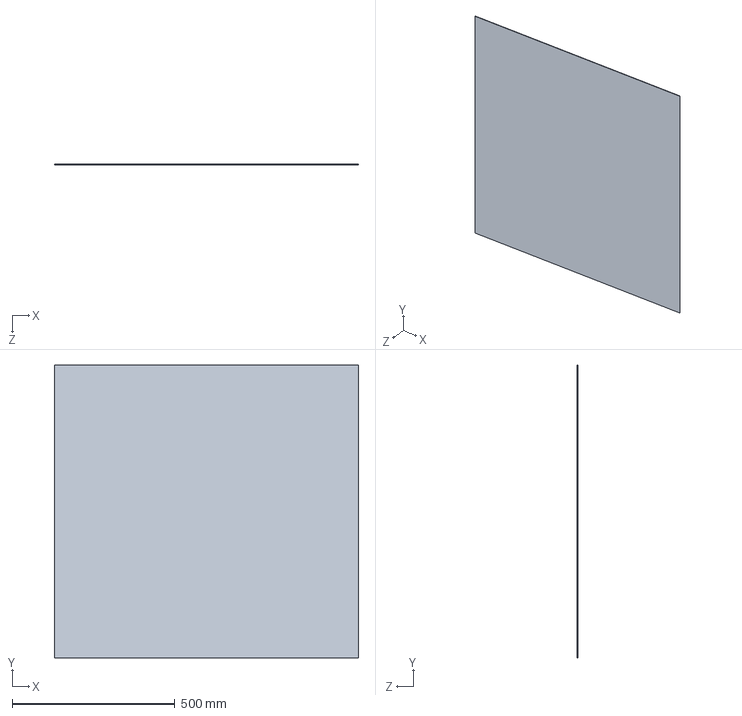
[picture p136: CAD file, 2025-05-16]
Mechanical/Main_expo_sides/Back decorations/Main_cover_body.SLDPRT
935.0 x 900.0 x 2.00 mm
