anastasiia-gif/MiniFactoryTCF/Mechanical/Box_design/manufacturable_parts/Holder_for_boxes.STL

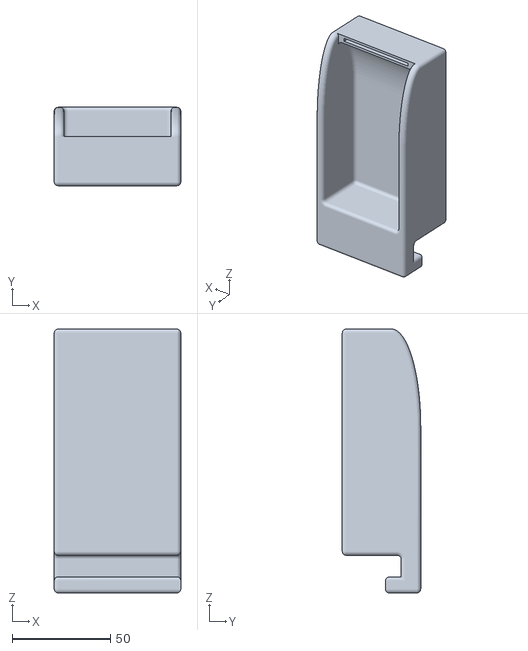
[picture p137: CAD file, 2025-05-16]
Mechanical/Box_design/manufacturable_parts/Holder_for_boxes.STL
64.5 x 40.0 x 134.5
