anastasiia-gif/MiniFactoryTCF/Mechanical/Electrical_covers/manufacturable parts/motor_electronics_cover.STL

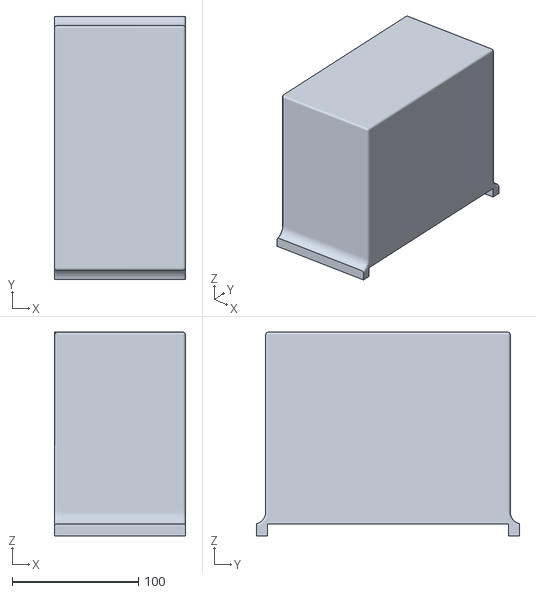
[picture p138: CAD file, 2025-07-23]
Mechanical/Electrical_covers/manufacturable parts/motor_electronics_cover.STL
104.0 x 208.6 x 161.5
