anastasiia-gif/MiniFactoryTCF/Mechanical/Main_expo_sides/Back decorations/dxf_manufacturing/robotic_arm_box.DXF

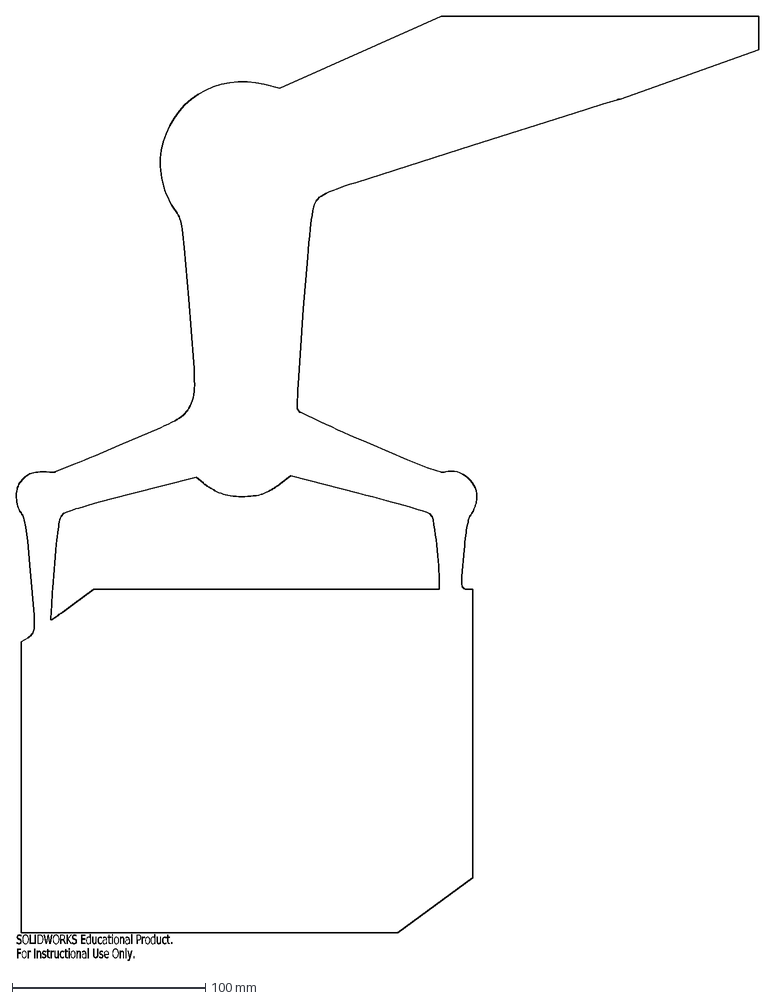
[picture p139: CAD file, 2025-05-16]
Mechanical/Main_expo_sides/Back decorations/dxf_manufacturing/robotic_arm_box.DXF
SOLIDWORKS Educational Product.
For Instructional Use Only.
