anastasiia-gif/MiniFactoryTCF/Mechanical/Main_expo_sides/Back decorations/logo.SLDPRT

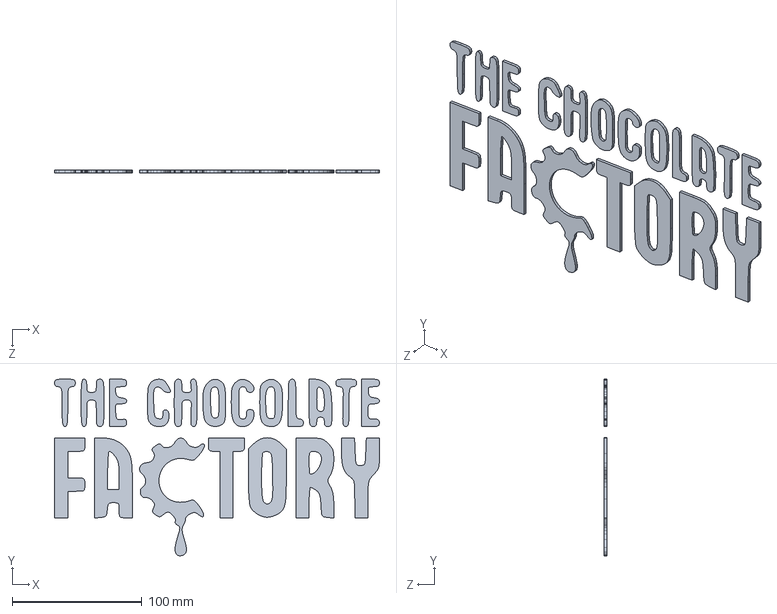
[picture p140: CAD file, 2025-05-16]
Mechanical/Main_expo_sides/Back decorations/logo.SLDPRT
250.0 x 136.0 x 2.00 mm
