anastasiia-gif/MiniFactoryTCF/Mechanical/Safety/Main_expo/Doors/door/manufacturable parts/big_screen_middle.DXF

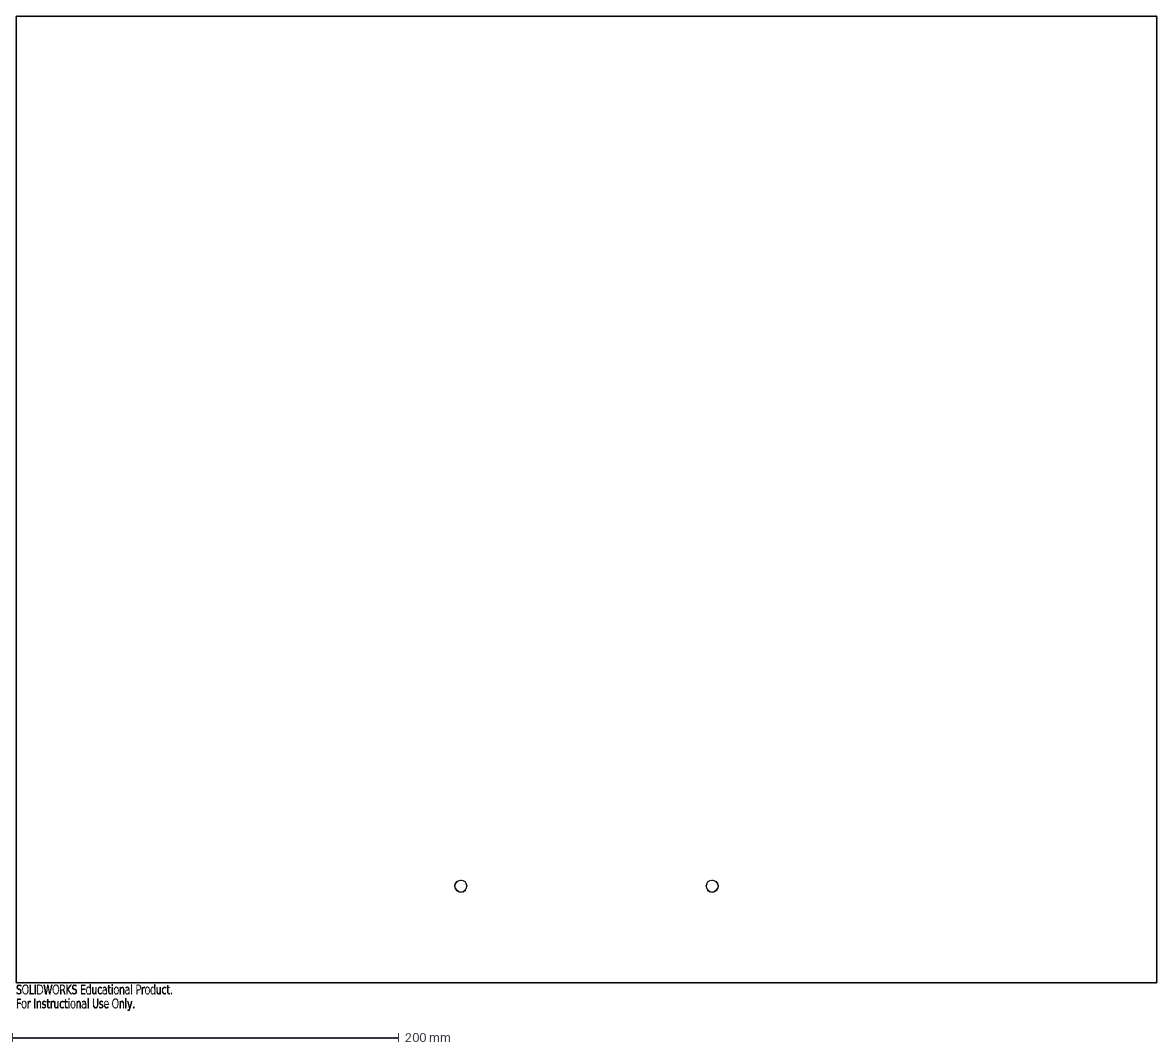
[picture p141: CAD file, 2025-05-16]
Mechanical/Safety/Main_expo/Doors/door/manufacturable parts/big_screen_middle.DXF
SOLIDWORKS Educational Product.
For Instructional Use Only.
