anastasiia-gif/MiniFactoryTCF/Mechanical/Safety/Main_expo/Doors/door/small_screens_right_x5.SLDPRT

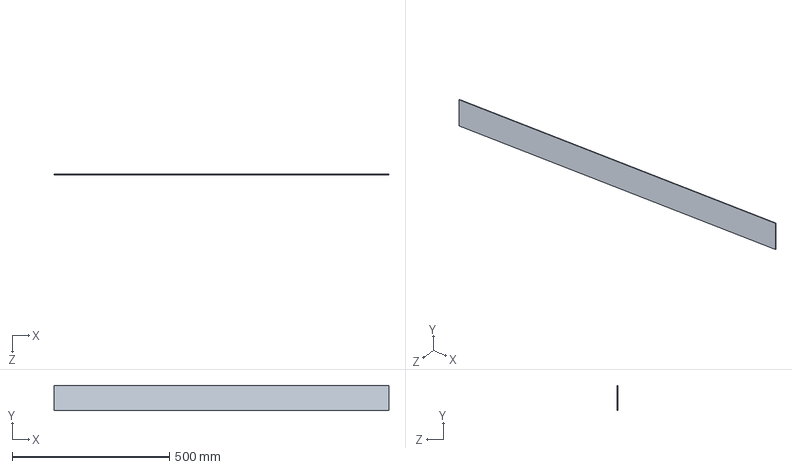
[picture p142: CAD file, 2025-05-16]
Mechanical/Safety/Main_expo/Doors/door/small_screens_right_x5.SLDPRT
1065.0 x 80.0 x 2.00 mm
