anastasiia-gif/MiniFactoryTCF/Mechanical/Safety/Pneumatics_hydraulics_covers/Pneumatic-hydraulic cover/manufacturable_parts/Side part_ inner.DXF

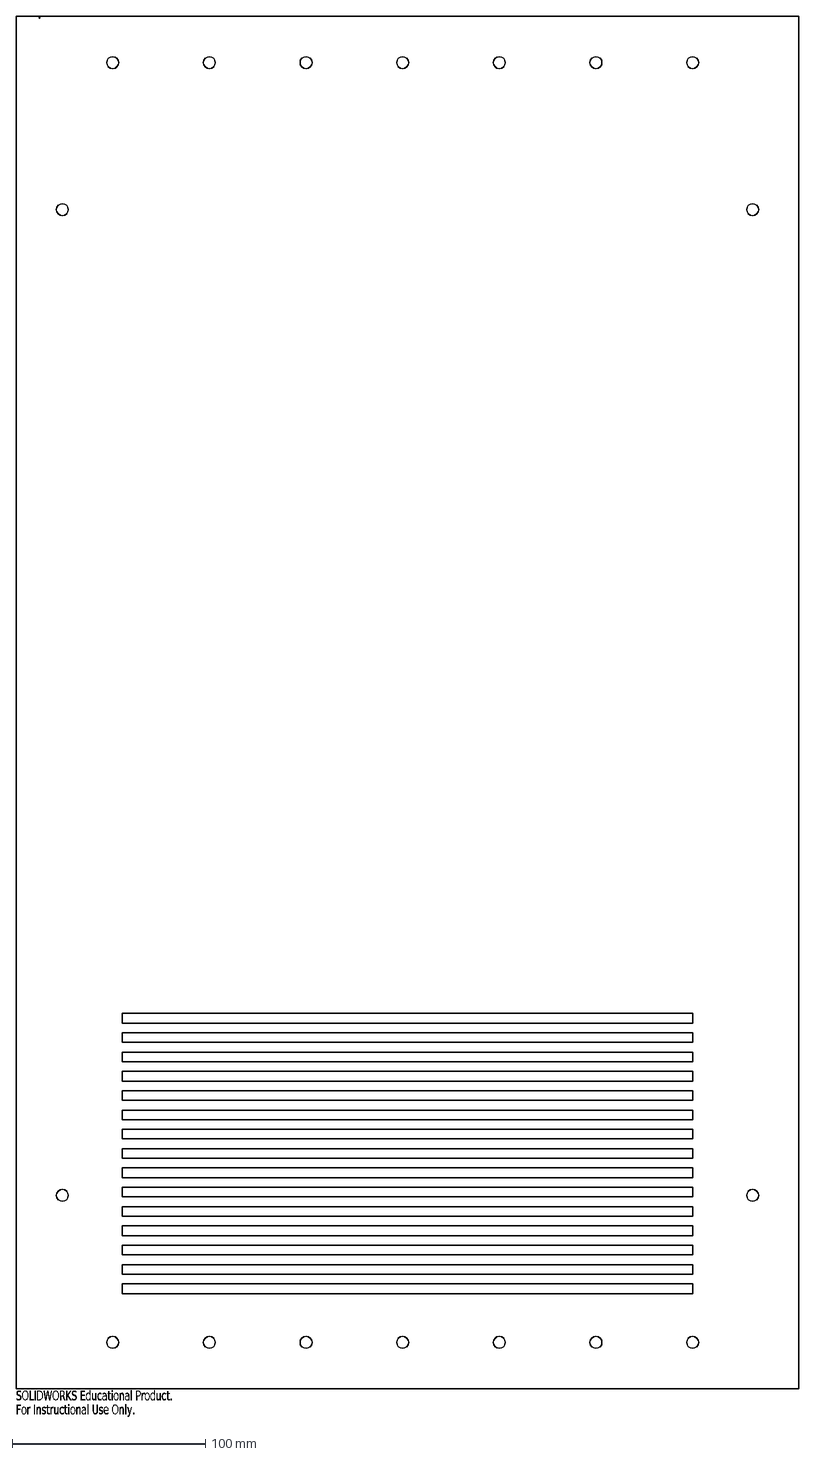
[picture p143: CAD file, 2025-07-18]
Mechanical/Safety/Pneumatics_hydraulics_covers/Pneumatic-hydraulic cover/manufacturable_parts/Side part_ inner.DXF
SOLIDWORKS Educational Product.
For Instructional Use Only.
