anastasiia-gif/MiniFactoryTCF/Mechanical/Safety/Pneumatics_hydraulics_covers/Pneumatic-hydraulic cover/Side part_ inner.SLDPRT

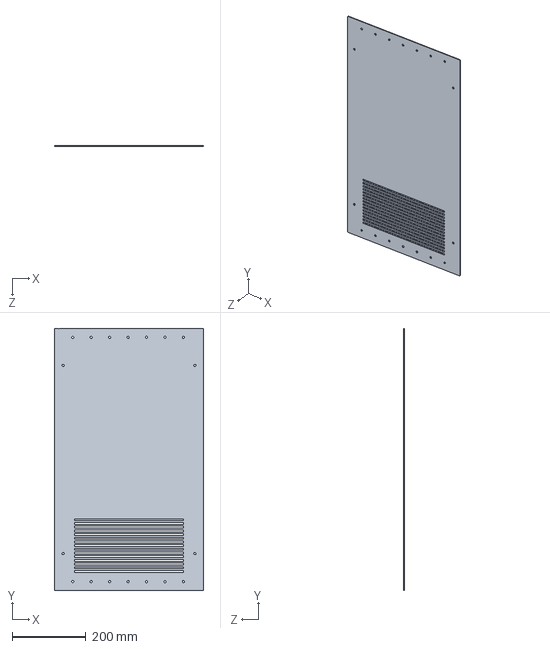
[picture p144: CAD file, 2025-07-18]
Mechanical/Safety/Pneumatics_hydraulics_covers/Pneumatic-hydraulic cover/Side part_ inner.SLDPRT
405.0 x 710.0 x 2.00 mm
