anastasiia-gif/MiniFactoryTCF/Mechanical/SystemImprovements/System improvements/Concept idee bovenkant.SLDPRT

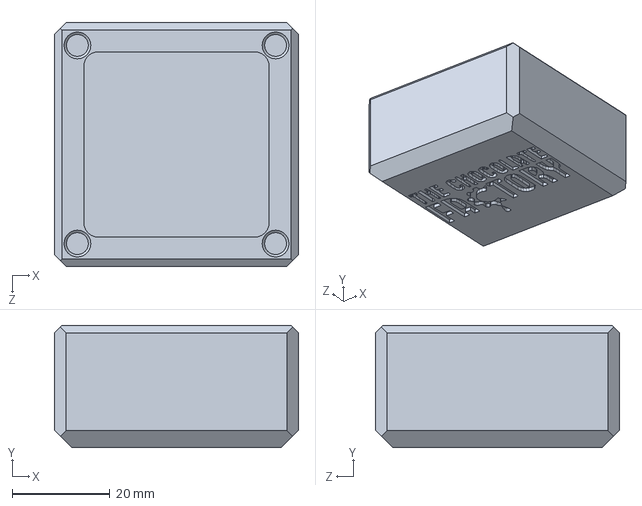
[picture p145: CAD file, 2025-06-03]
Mechanical/SystemImprovements/System improvements/Concept idee bovenkant.SLDPRT
50.0 x 25.0 x 50.0 mm
