anastasiia-gif/MiniFactoryTCF/Mechanical/Electrical_covers/manufacturable parts/linear_actuator_electronics_cover.STL

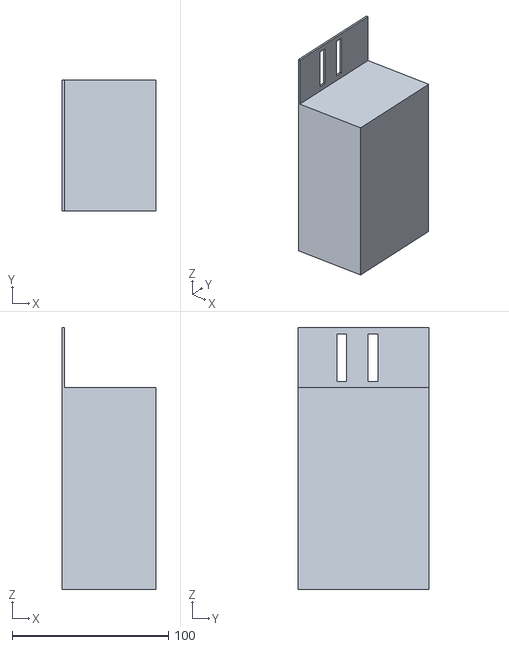
[picture p147: CAD file, 2025-07-23]
Mechanical/Electrical_covers/manufacturable parts/linear_actuator_electronics_cover.STL
60.0 x 84.0 x 167.5
