anastasiia-gif/MiniFactoryTCF/Mechanical/Electrical_covers/press_electronics_cover.SLDPRT

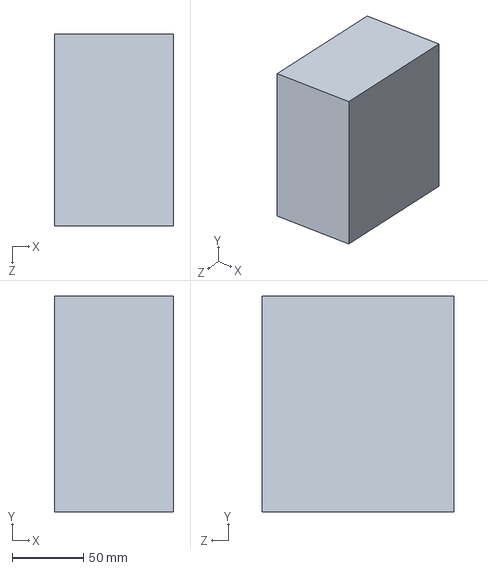
[picture p148: CAD file, 2025-07-23]
Mechanical/Electrical_covers/press_electronics_cover.SLDPRT
83.7 x 151.5 x 134.8 mm
