anastasiia-gif/MiniFactoryTCF/Mechanical/Main_expo_sides/Back decorations/gear_holes1.SLDPRT

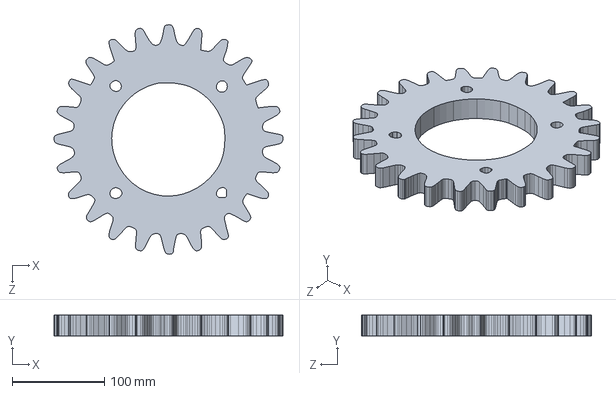
[picture p150: CAD file, 2025-05-16]
Mechanical/Main_expo_sides/Back decorations/gear_holes1.SLDPRT
248.5 x 22.7 x 249.1 mm
