anastasiia-gif/MiniFactoryTCF/Mechanical/Safety/Main_expo/Dividers/Dividers_electrical_box/Railing_electrical_box.SLDPRT

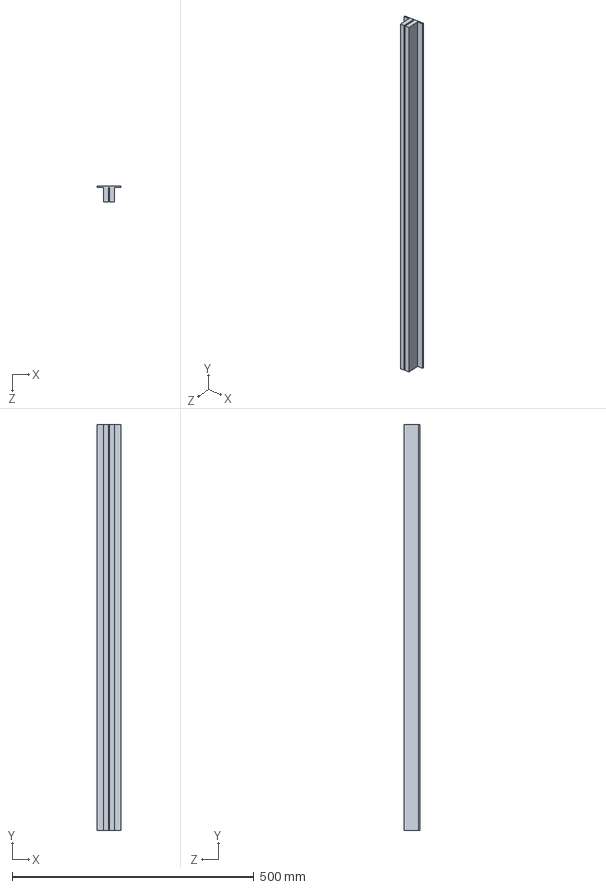
[picture p152: CAD file, 2025-05-16]
Mechanical/Safety/Main_expo/Dividers/Dividers_electrical_box/Railing_electrical_box.SLDPRT
50.0 x 840.0 x 33.0 mm
