anastasiia-gif/MiniFactoryTCF/Mechanical/Safety/Main_expo/Doors/door/manufacturable parts/big_screen_right.DXF

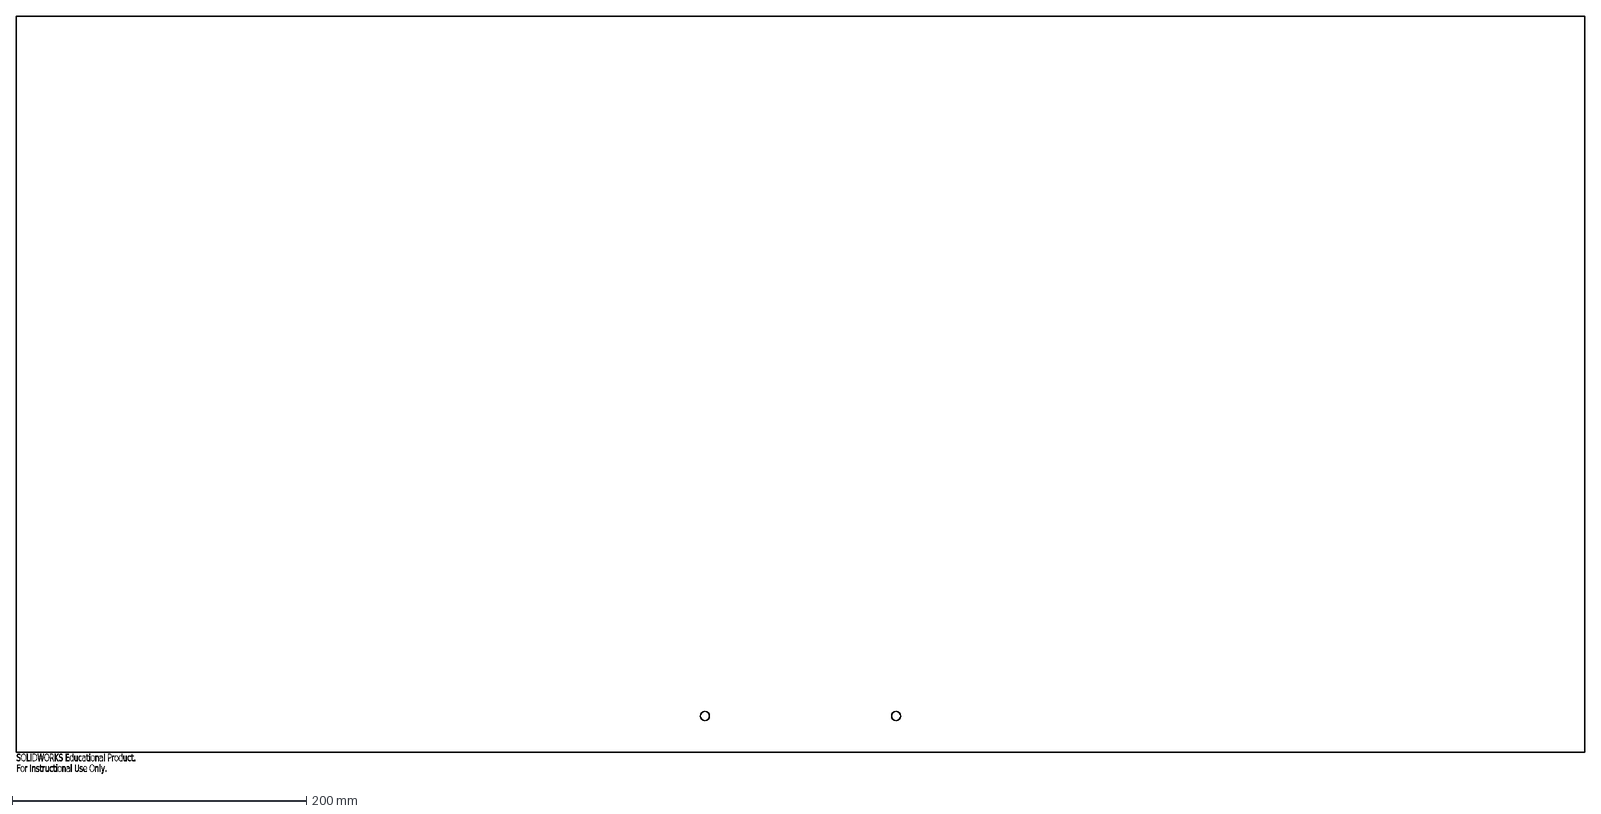
[picture p153: CAD file, 2025-05-16]
Mechanical/Safety/Main_expo/Doors/door/manufacturable parts/big_screen_right.DXF
SOLIDWORKS Educational Product.
For Instructional Use Only.
