anastasiia-gif/MiniFactoryTCF/Mechanical/Safety/Main_expo/Doors/door/small_screen_left_x5.SLDPRT

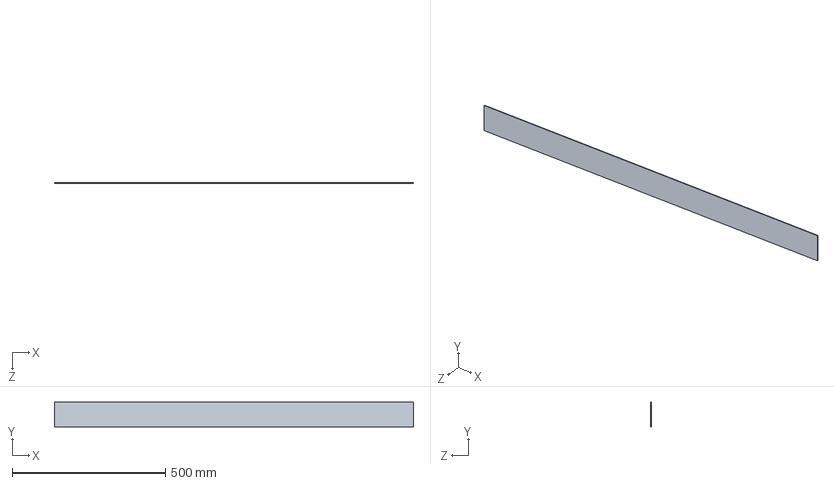
[picture p154: CAD file, 2025-05-16]
Mechanical/Safety/Main_expo/Doors/door/small_screen_left_x5.SLDPRT
1170.0 x 80.0 x 2.00 mm
