anastasiia-gif/MiniFactoryTCF/Mechanical/SystemImprovements/System improvements/Kabelgoot bakje.SLDPRT

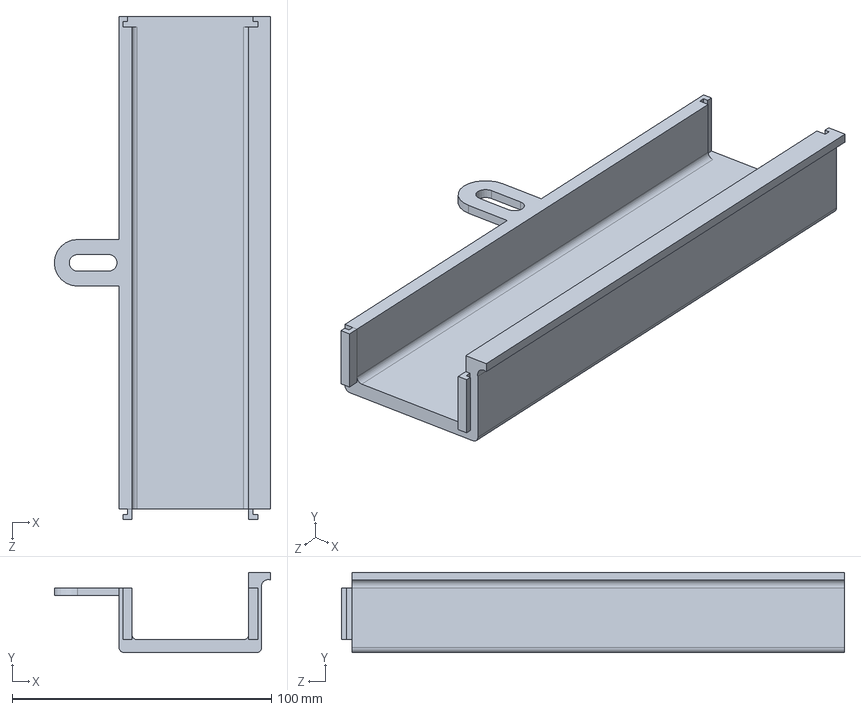
[picture p156: CAD file, 2025-06-03]
Mechanical/SystemImprovements/System improvements/Kabelgoot bakje.SLDPRT
83.5 x 31.0 x 194.0 mm
