anastasiia-gif/MiniFactoryTCF/Mechanical/Box_design/manufacturable_parts/Brigh_top_plate.STL

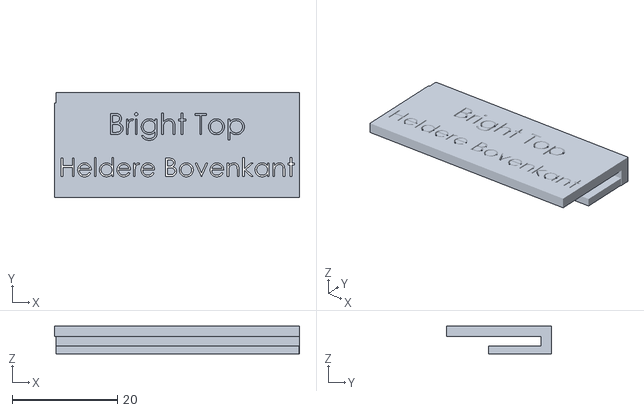
[picture p157: CAD file, 2025-05-16]
Mechanical/Box_design/manufacturable_parts/Brigh_top_plate.STL
46.5 x 20.0 x 5.28
