anastasiia-gif/MiniFactoryTCF/Mechanical/Electrical_covers/button_controller_cover.SLDPRT

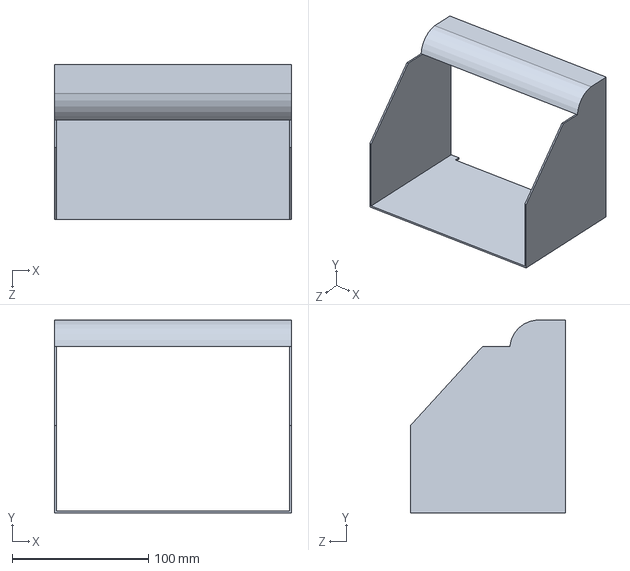
[picture p158: CAD file, 2025-07-23]
Mechanical/Electrical_covers/button_controller_cover.SLDPRT
174.0 x 141.5 x 114.0 mm
