anastasiia-gif/MiniFactoryTCF/Mechanical/Electrical_covers/manufacturable parts/Box_deposit.STL

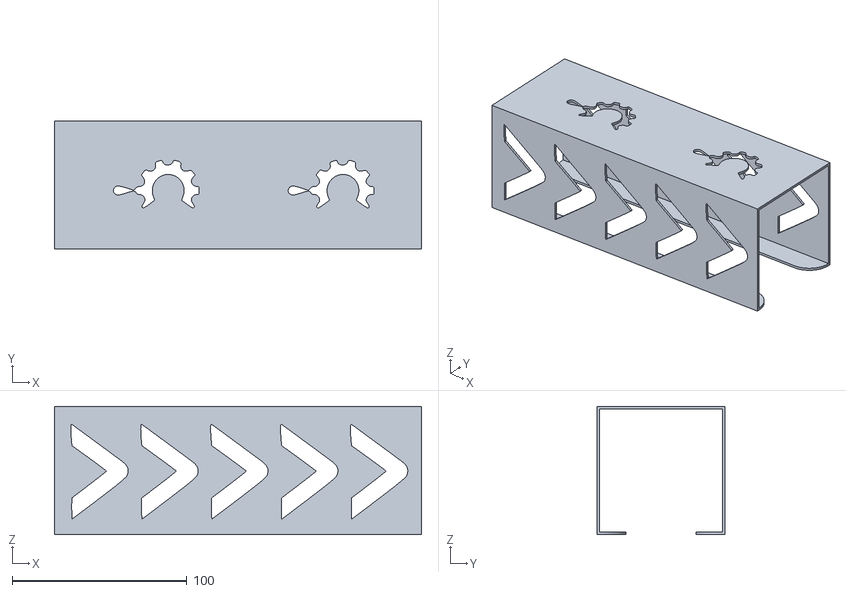
[picture p159: CAD file, 2025-07-23]
Mechanical/Electrical_covers/manufacturable parts/Box_deposit.STL
210.0 x 73.5 x 73.5
