anastasiia-gif/MiniFactoryTCF/Mechanical/Main_expo_sides/Back decorations/dxf_manufacturing/guy_carring_box.DXF

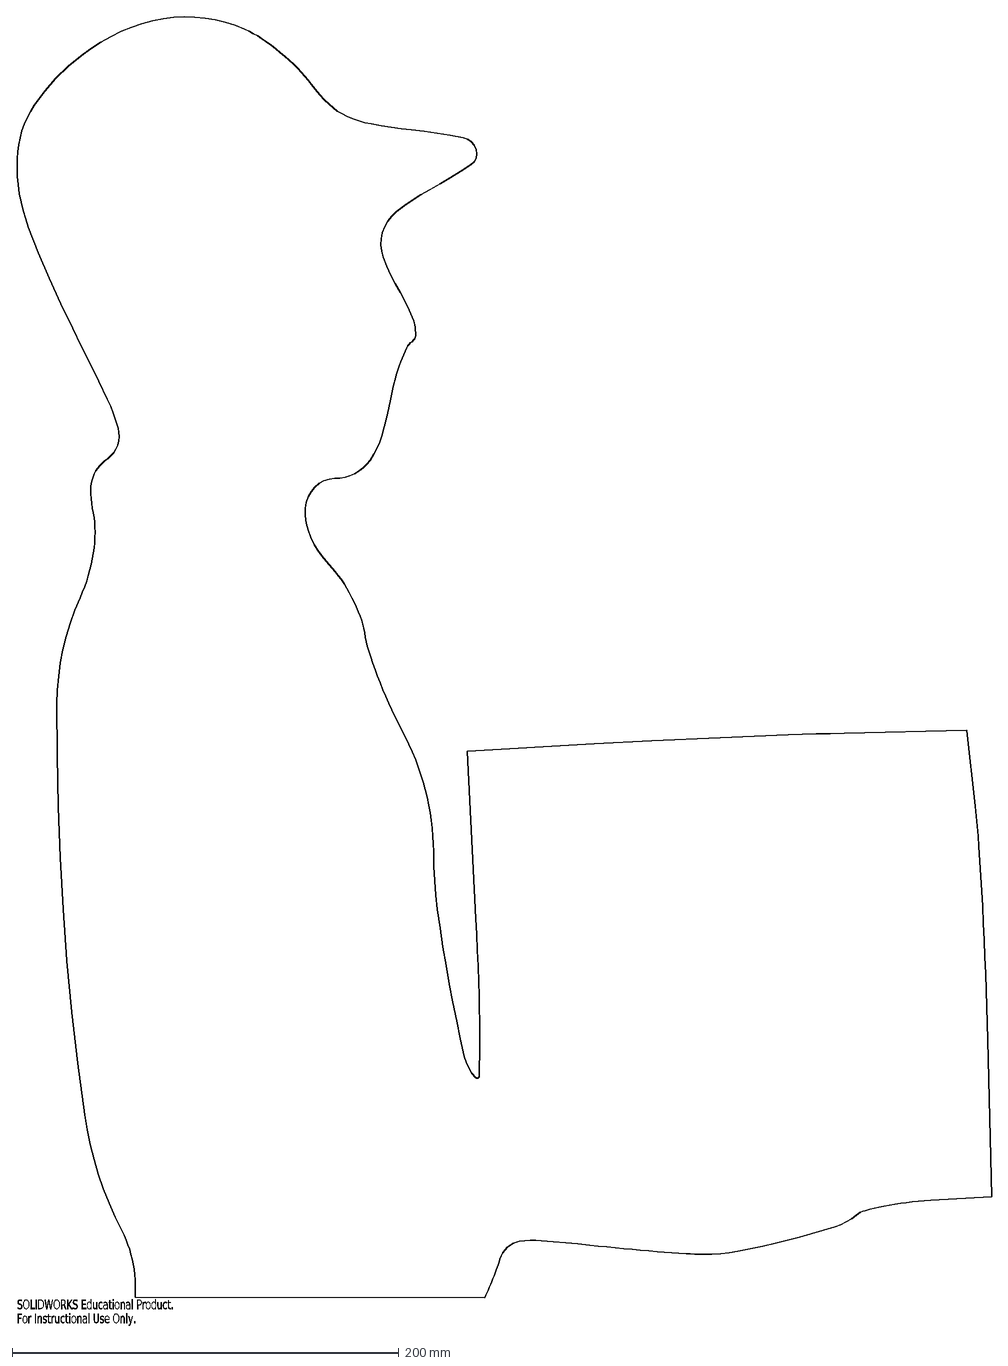
[picture p160: CAD file, 2025-05-16]
Mechanical/Main_expo_sides/Back decorations/dxf_manufacturing/guy_carring_box.DXF
SOLIDWORKS Educational Product.
For Instructional Use Only.
