anastasiia-gif/MiniFactoryTCF/Mechanical/Main_expo_sides/Back decorations/robotic_arm_box.SLDPRT

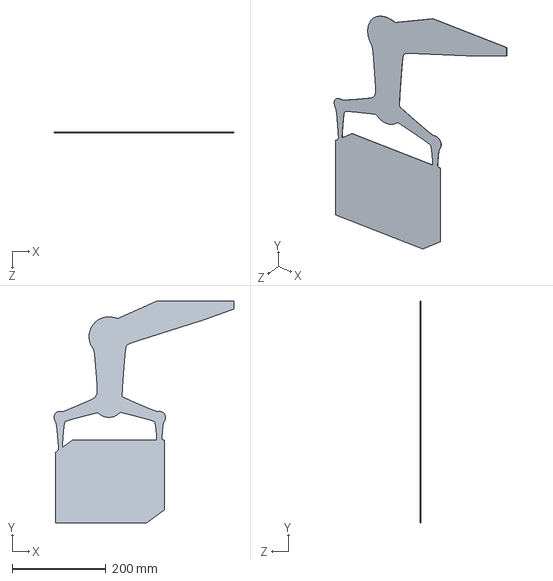
[picture p161: CAD file, 2025-05-16]
Mechanical/Main_expo_sides/Back decorations/robotic_arm_box.SLDPRT
384.0 x 474.0 x 0.46 mm
