anastasiia-gif/MiniFactoryTCF/Mechanical/Safety/Main_expo/Doors/door/manufacturable parts/small_screen_middle_x5.DXF

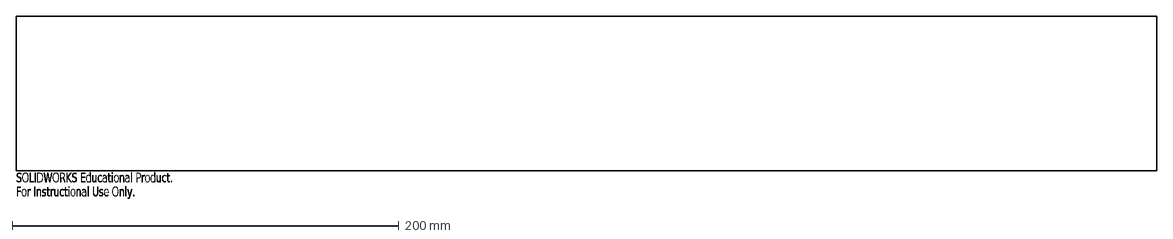
[picture p162: CAD file, 2025-05-16]
Mechanical/Safety/Main_expo/Doors/door/manufacturable parts/small_screen_middle_x5.DXF
SOLIDWORKS Educational Product.
For Instructional Use Only.
