anastasiia-gif/MiniFactoryTCF/Mechanical/Safety/Pneumatics_hydraulics_covers/Pneumatic-hydraulic cover/Hinge_lock_back_door_1.SLDPRT

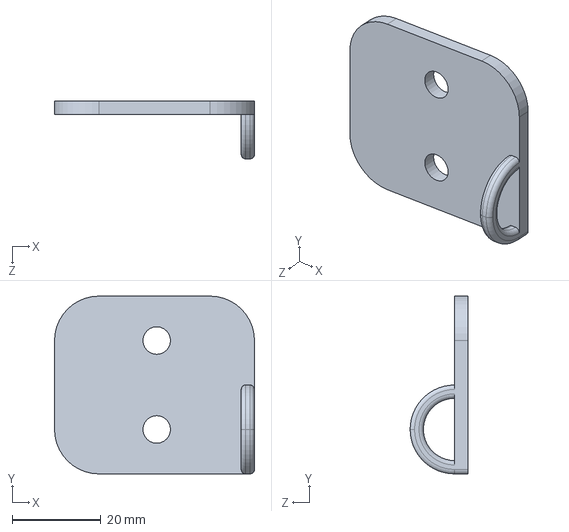
[picture p163: CAD file, 2025-05-16]
Mechanical/Safety/Pneumatics_hydraulics_covers/Pneumatic-hydraulic cover/Hinge_lock_back_door_1.SLDPRT
45.0 x 40.0 x 13.0 mm
