anastasiia-gif/MiniFactoryTCF/Mechanical/Safety/Pneumatics_hydraulics_covers/Pneumatic-hydraulic cover/manufacturable_parts/Front_part.DXF

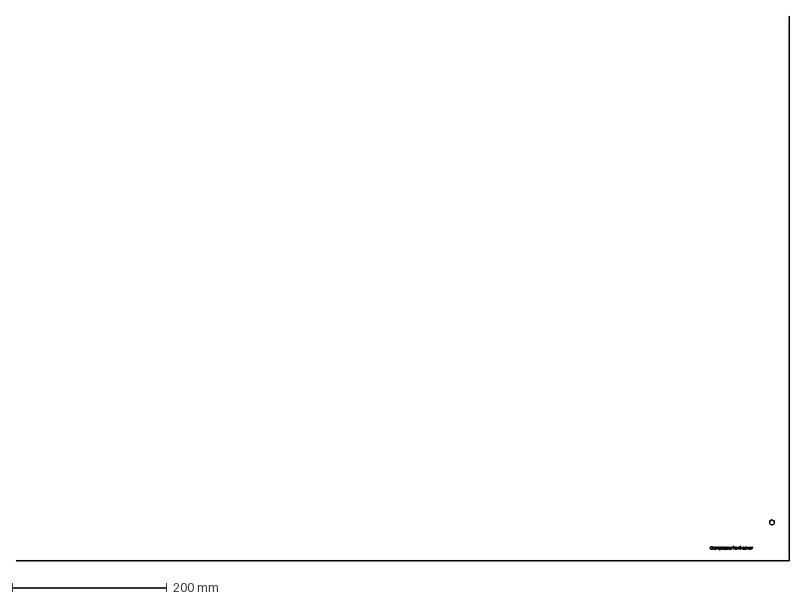
[picture p164: CAD file, 2025-05-16]
Mechanical/Safety/Pneumatics_hydraulics_covers/Pneumatic-hydraulic cover/manufacturable_parts/Front_part.DXF
1000.0 x 705.0 mm
