anastasiia-gif/MiniFactoryTCF/Mechanical/SystemImprovements/System improvements/Concept idee blokje.SLDPRT

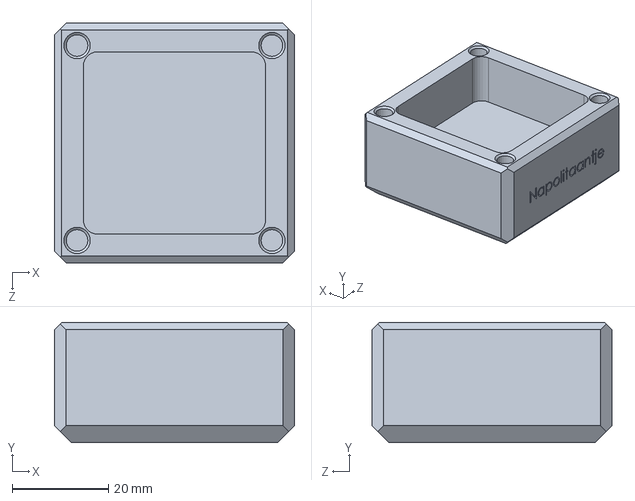
[picture p165: CAD file, 2025-06-03]
Mechanical/SystemImprovements/System improvements/Concept idee blokje.SLDPRT
50.0 x 25.0 x 50.0 mm
