anastasiia-gif/MiniFactoryTCF/Mechanical/Main_expo_sides/Back decorations/dxf_manufacturing/gear_like_bicycle_L.DXF

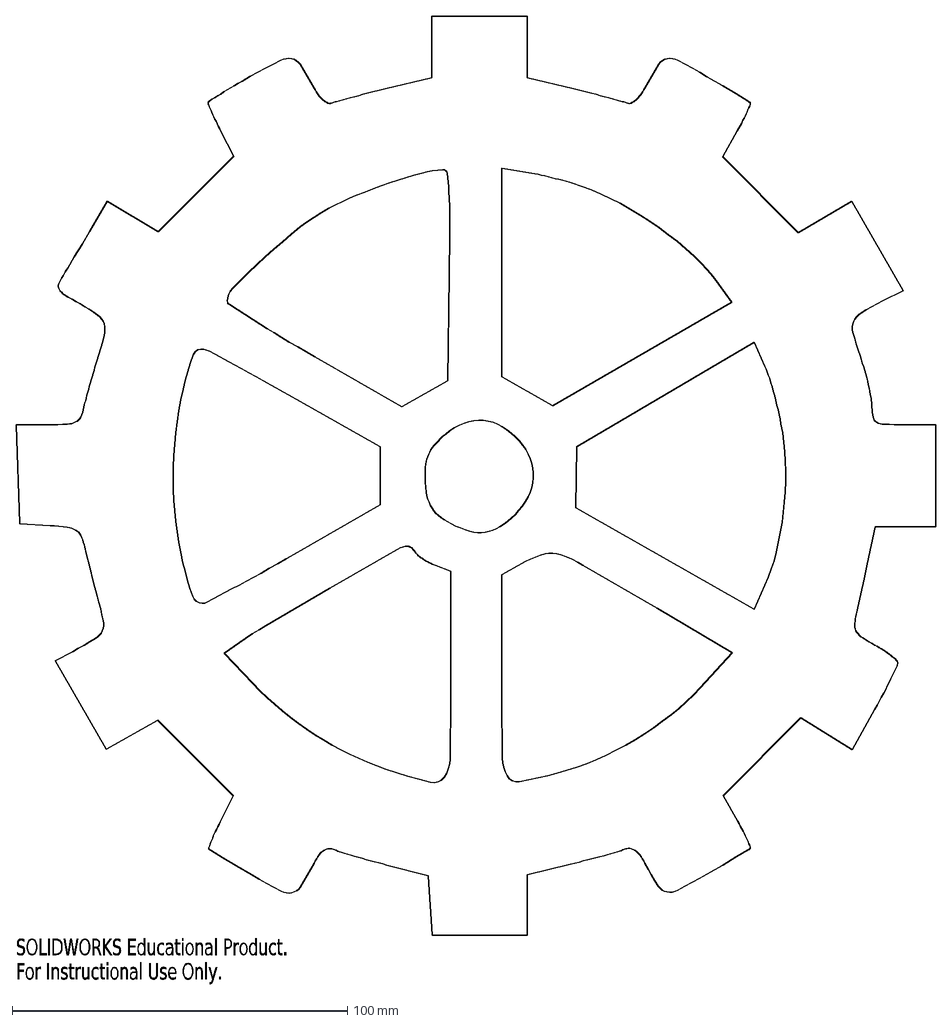
[picture p166: CAD file, 2025-05-16]
Mechanical/Main_expo_sides/Back decorations/dxf_manufacturing/gear_like_bicycle_L.DXF
SOLIDWORKS Educational Product.
For Instructional Use Only.
