anastasiia-gif/MiniFactoryTCF/Mechanical/Safety/Main_expo/Doors/door/Barn_Door_Handle.SLDPRT

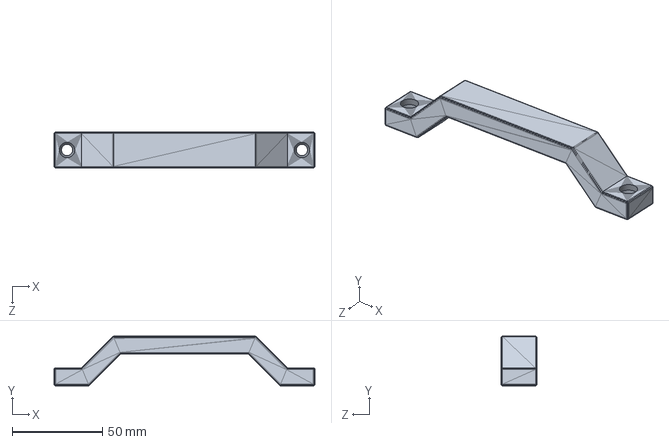
[picture p167: CAD file, 2025-05-16]
Mechanical/Safety/Main_expo/Doors/door/Barn_Door_Handle.SLDPRT
144.6 x 27.5 x 20.0 mm
