anastasiia-gif/MiniFactoryTCF/Mechanical/Safety/Main_expo/Doors/door/manufacturable parts/Guide_for_doors.DXF

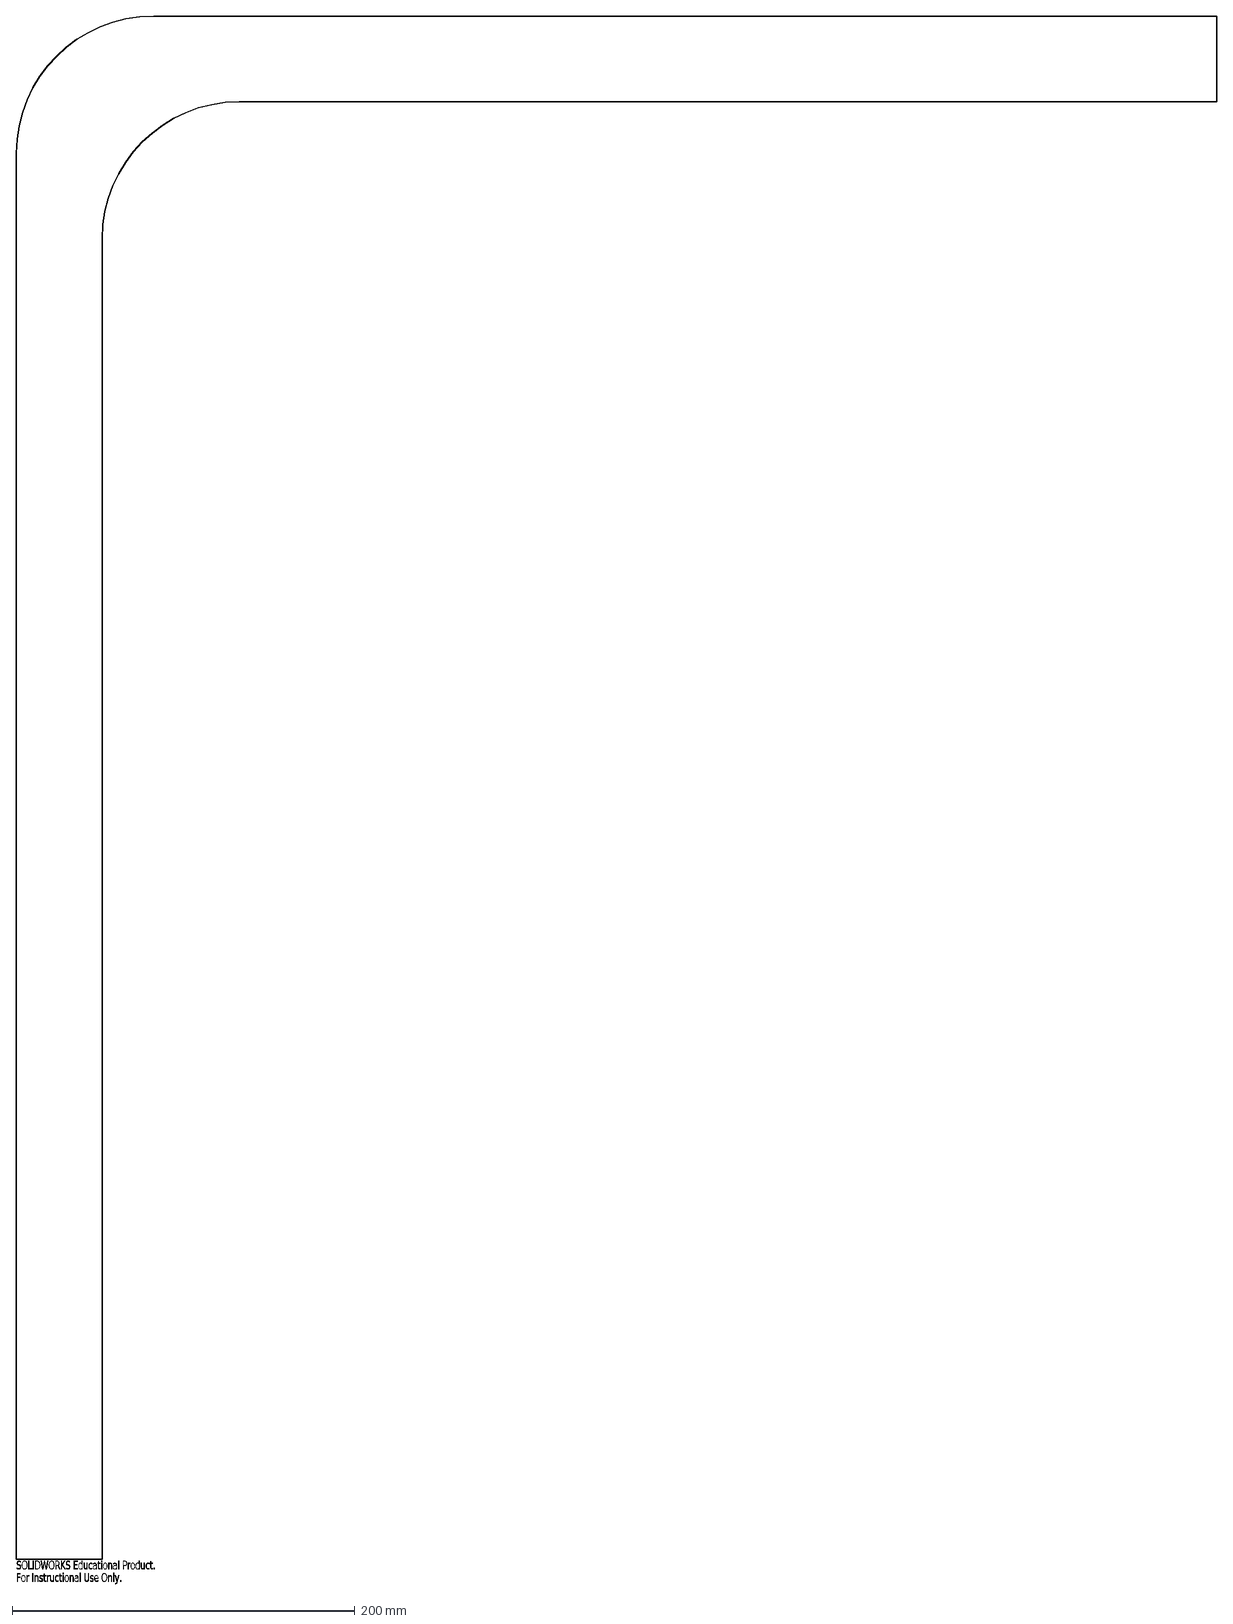
[picture p168: CAD file, 2025-05-16]
Mechanical/Safety/Main_expo/Doors/door/manufacturable parts/Guide_for_doors.DXF
SOLIDWORKS Educational Product.
For Instructional Use Only.
