anastasiia-gif/MiniFactoryTCF/Mechanical/Safety/Pneumatics_hydraulics_covers/Pneumatic-hydraulic cover/Front part.SLDPRT

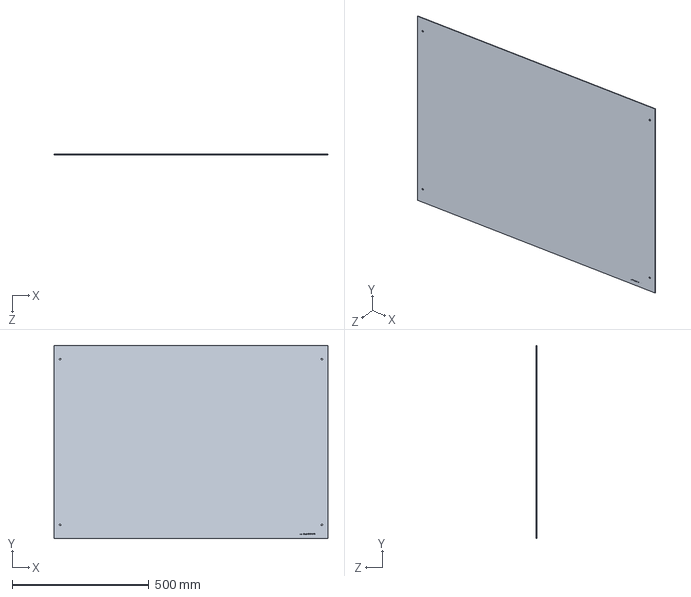
[picture p169: CAD file, 2025-05-16]
Mechanical/Safety/Pneumatics_hydraulics_covers/Pneumatic-hydraulic cover/Front part.SLDPRT
1000.0 x 705.0 x 2.00 mm
