anastasiia-gif/MiniFactoryTCF/Mechanical/Safety/Pneumatics_hydraulics_covers/Pneumatic-hydraulic cover/manufacturable_parts/Back_part.DXF

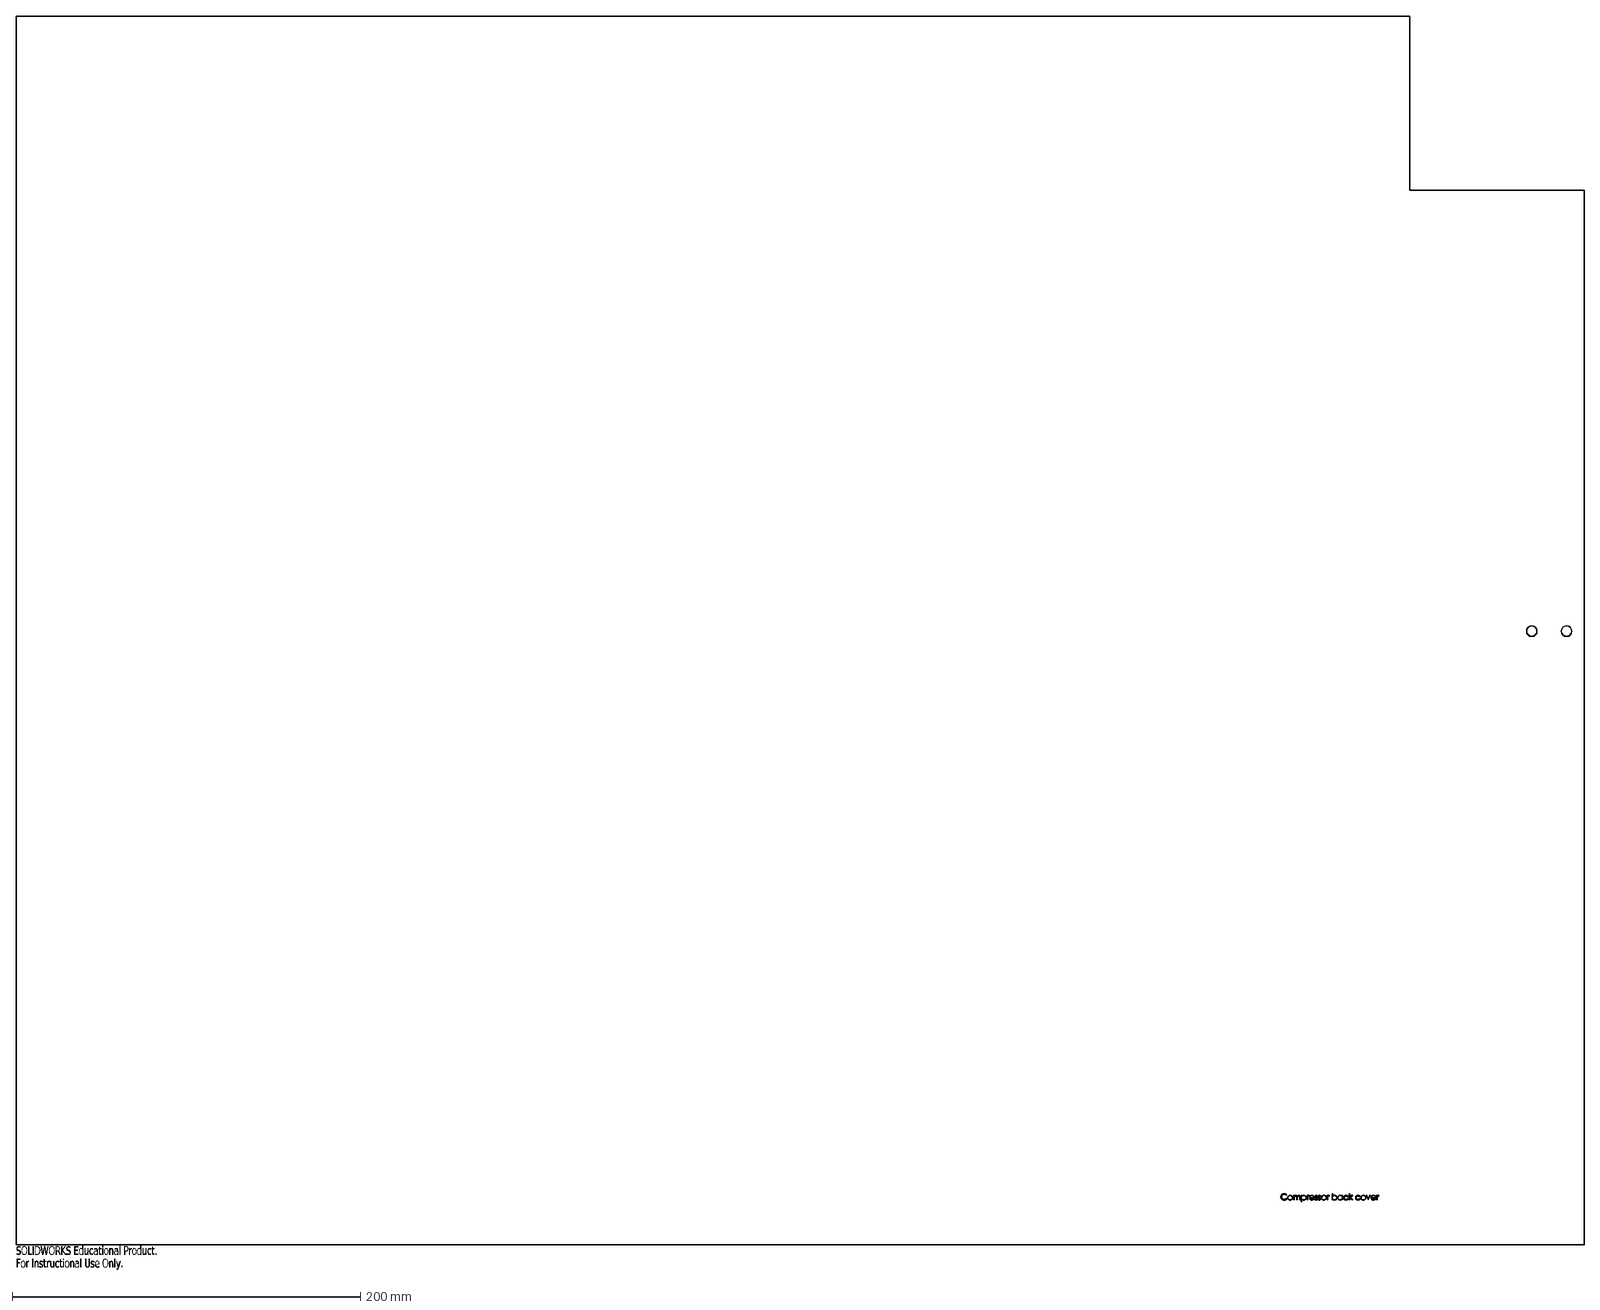
[picture p170: CAD file, 2025-05-16]
Mechanical/Safety/Pneumatics_hydraulics_covers/Pneumatic-hydraulic cover/manufacturable_parts/Back_part.DXF
SOLIDWORKS Educational Product.
For Instructional Use Only.
