anastasiia-gif/MiniFactoryTCF/Mechanical/SystemImprovements/System improvements/deksel kabelgoot.SLDPRT

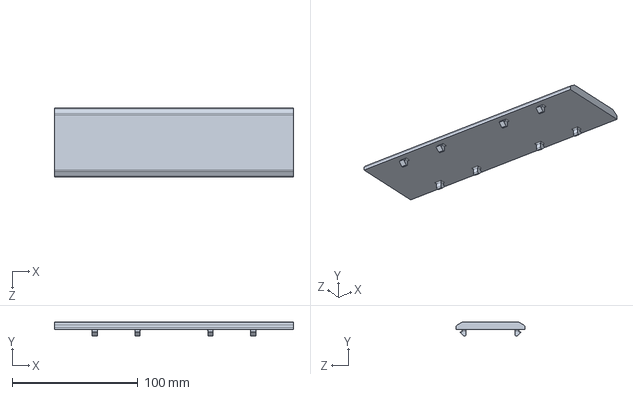
[picture p171: CAD file, 2025-06-03]
Mechanical/SystemImprovements/System improvements/deksel kabelgoot.SLDPRT
190.0 x 11.0 x 55.0 mm
