anastasiia-gif/MiniFactoryTCF/Mechanical/Electrical_covers/conveyor_sensor_cover.SLDPRT

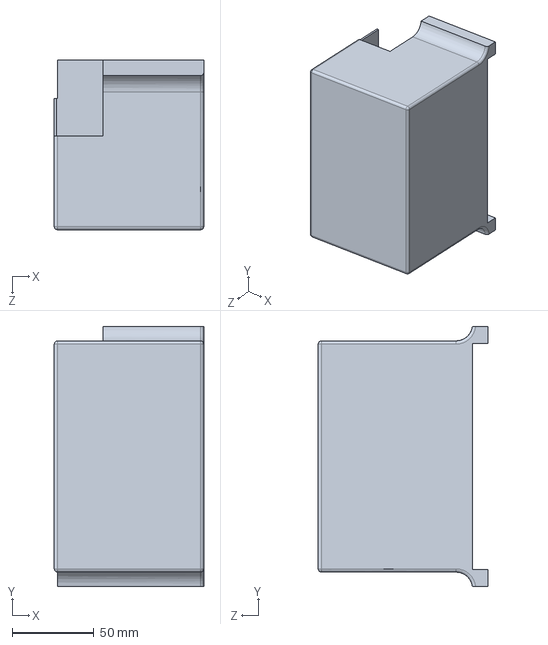
[picture p172: CAD file, 2025-07-23]
Mechanical/Electrical_covers/conveyor_sensor_cover.SLDPRT
91.6 x 159.2 x 103.9 mm
