anastasiia-gif/MiniFactoryTCF/Mechanical/Main_expo_sides/Back decorations/dxf_manufacturing/gear_bicycle_smaller1.DXF

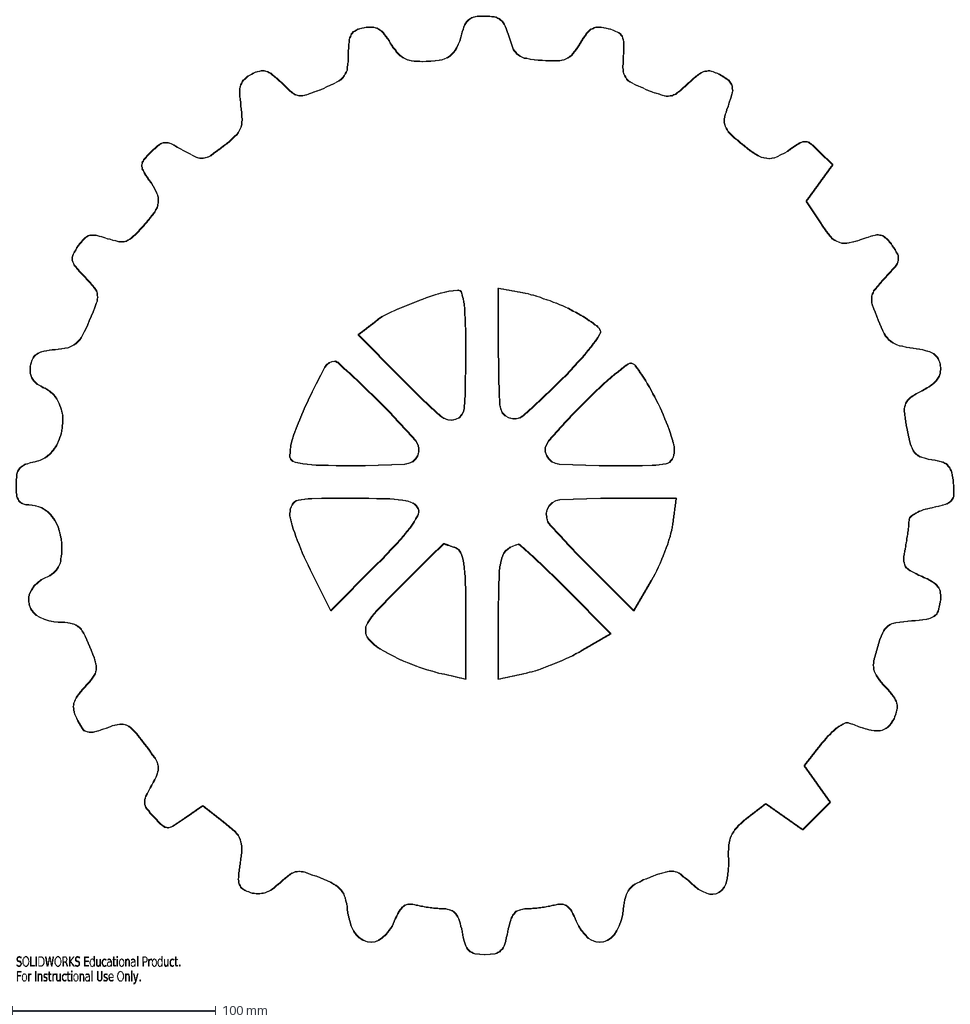
[picture p173: CAD file, 2025-05-16]
Mechanical/Main_expo_sides/Back decorations/dxf_manufacturing/gear_bicycle_smaller1.DXF
SOLIDWORKS Educational Product.
For Instructional Use Only.
