anastasiia-gif/MiniFactoryTCF/Mechanical/Safety/Main_expo/Dividers/Dividers_electrical_box/Manufacturable parts/Electrical_box_cover.DXF

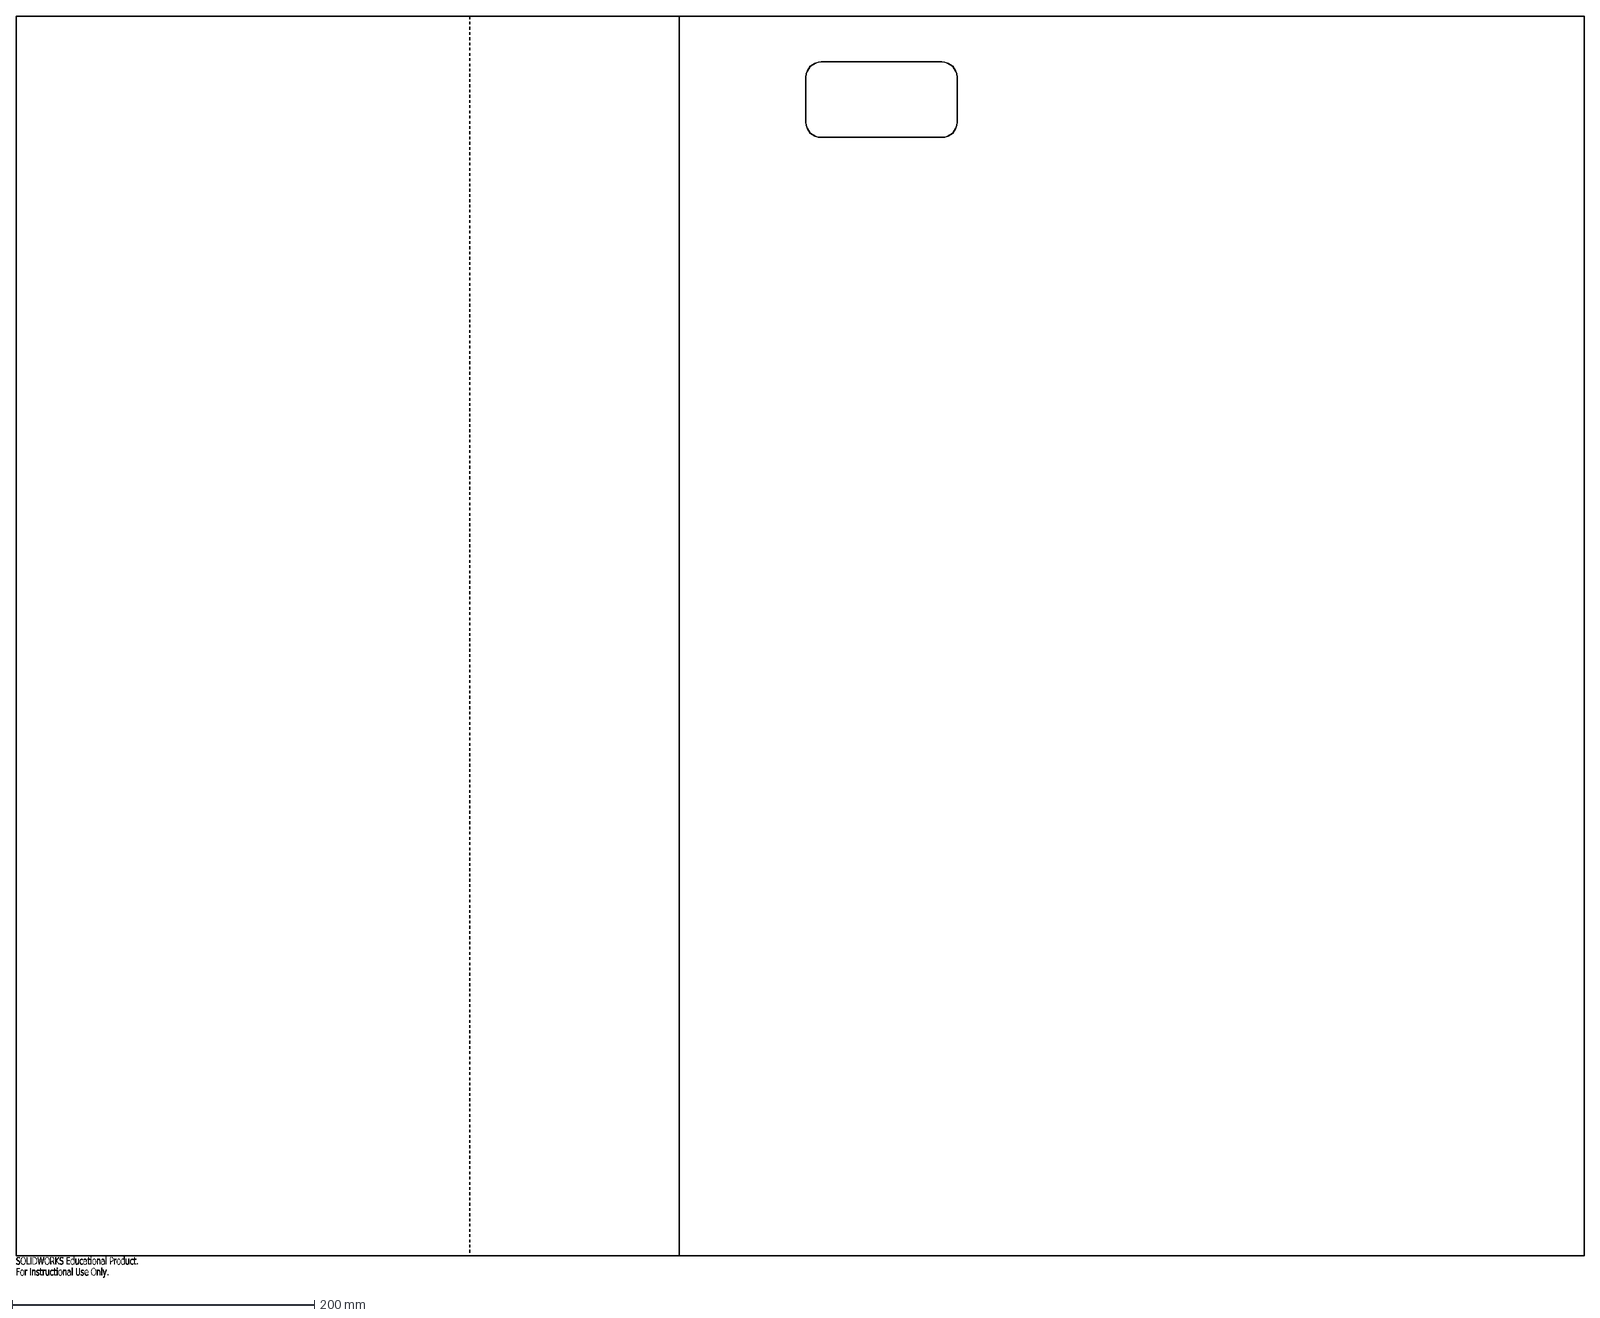
[picture p174: CAD file, 2025-05-16]
Mechanical/Safety/Main_expo/Dividers/Dividers_electrical_box/Manufacturable parts/Electrical_box_cover.DXF
SOLIDWORKS Educational Product.
For Instructional Use Only.
