anastasiia-gif/MiniFactoryTCF/Mechanical/Safety/Main_expo/Doors/door/small_screen_middle_x5.SLDPRT

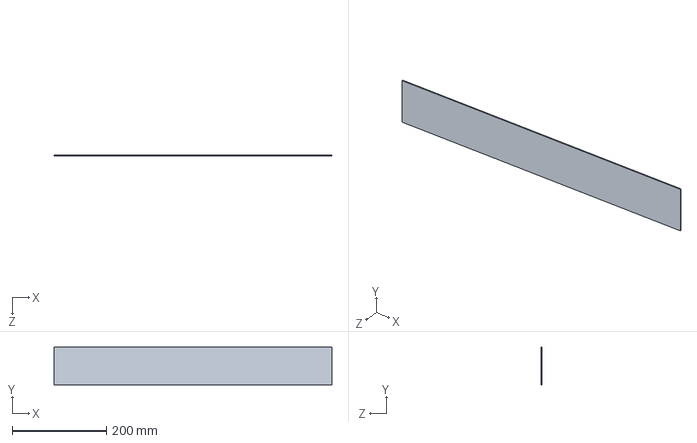
[picture p175: CAD file, 2025-05-16]
Mechanical/Safety/Main_expo/Doors/door/small_screen_middle_x5.SLDPRT
590.0 x 80.0 x 2.00 mm
