anastasiia-gif/MiniFactoryTCF/Mechanical/Safety/Pneumatics_hydraulics_covers/Pneumatic-hydraulic cover/connector_for_bottom.SLDPRT

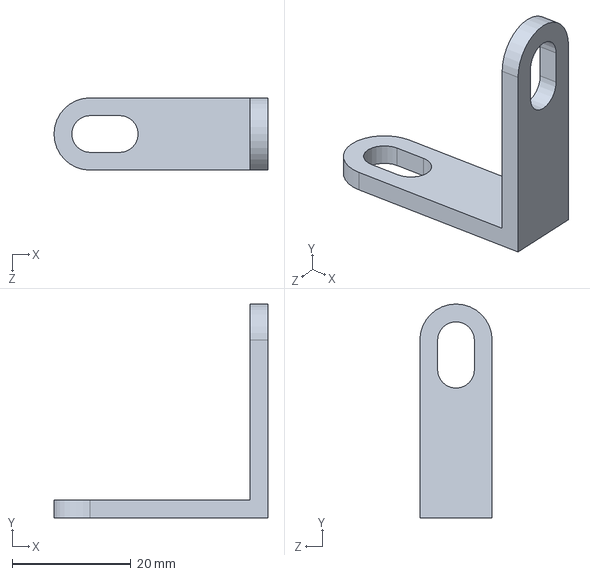
[picture p176: CAD file, 2025-05-16]
Mechanical/Safety/Pneumatics_hydraulics_covers/Pneumatic-hydraulic cover/connector_for_bottom.SLDPRT
36.1 x 36.1 x 12.2 mm
