anastasiia-gif/MiniFactoryTCF/Mechanical/Safety/Main_expo/Dividers/Dividers_electrical_box/Hydraulic_press_cover.SLDPRT

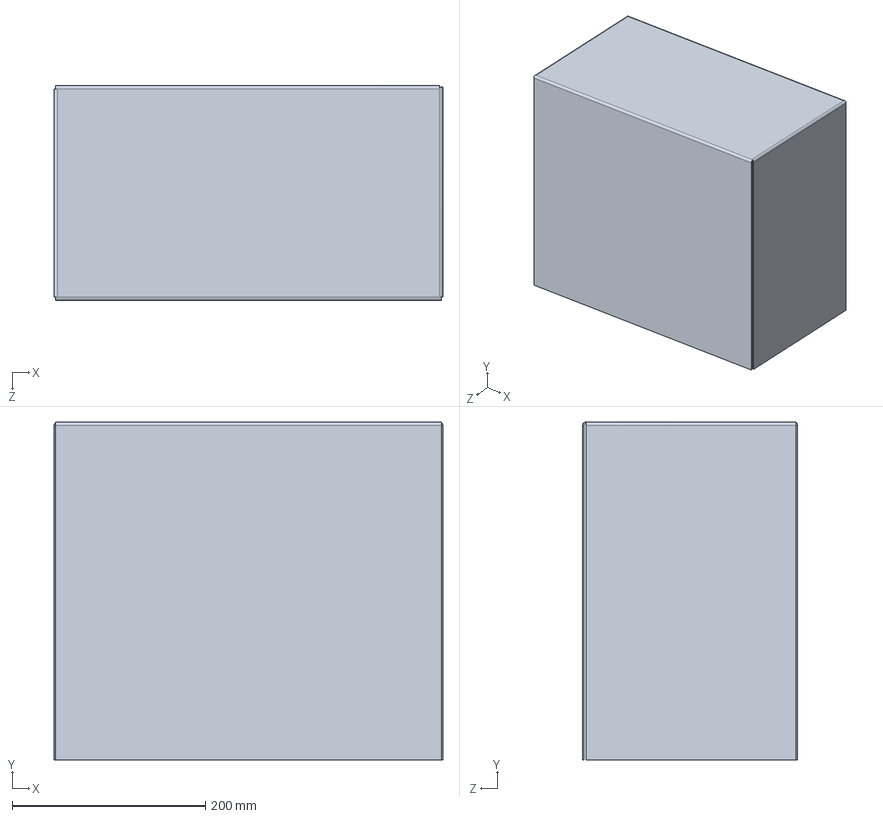
[picture p178: CAD file, 2025-05-16]
Mechanical/Safety/Main_expo/Dividers/Dividers_electrical_box/Hydraulic_press_cover.SLDPRT
403.0 x 350.0 x 223.0 mm
