anastasiia-gif/MiniFactoryTCF/Mechanical/Safety/Main_expo/Doors/door/big_screen_left.SLDPRT

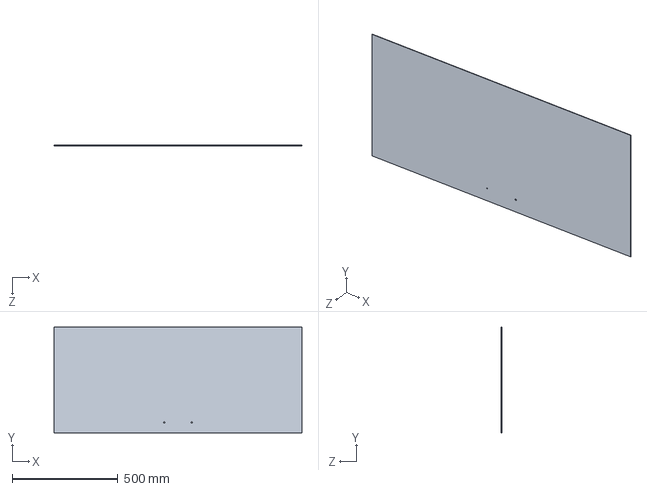
[picture p179: CAD file, 2025-05-16]
Mechanical/Safety/Main_expo/Doors/door/big_screen_left.SLDPRT
1170.0 x 500.0 x 2.00 mm
