anastasiia-gif/MiniFactoryTCF/Mechanical/Safety/Main_expo/Doors/door/manufacturable parts/hinge_small.STL

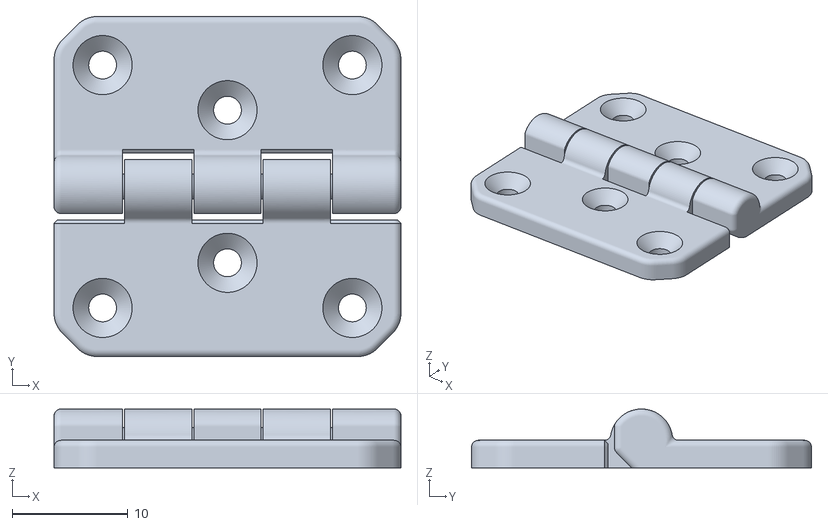
[picture p180: CAD file, 2025-05-16]
Mechanical/Safety/Main_expo/Doors/door/manufacturable parts/hinge_small.STL
30.0 x 29.4 x 5.10
