anastasiia-gif/MiniFactoryTCF/Mechanical/Safety/Pneumatics_hydraulics_covers/Pneumatic-hydraulic cover/Hinge_lock_back_door.SLDPRT

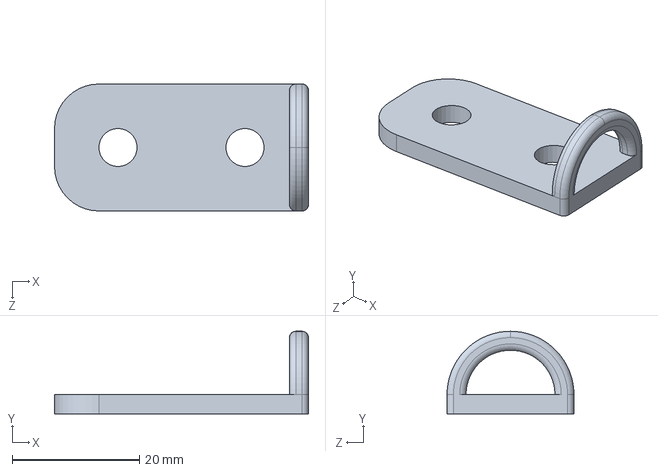
[picture p181: CAD file, 2025-05-16]
Mechanical/Safety/Pneumatics_hydraulics_covers/Pneumatic-hydraulic cover/Hinge_lock_back_door.SLDPRT
40.0 x 13.0 x 20.0 mm
