anastasiia-gif/MiniFactoryTCF/Mechanical/Safety/Pneumatics_hydraulics_covers/Pneumatic-hydraulic cover/manufacturable_parts/hinge.stl

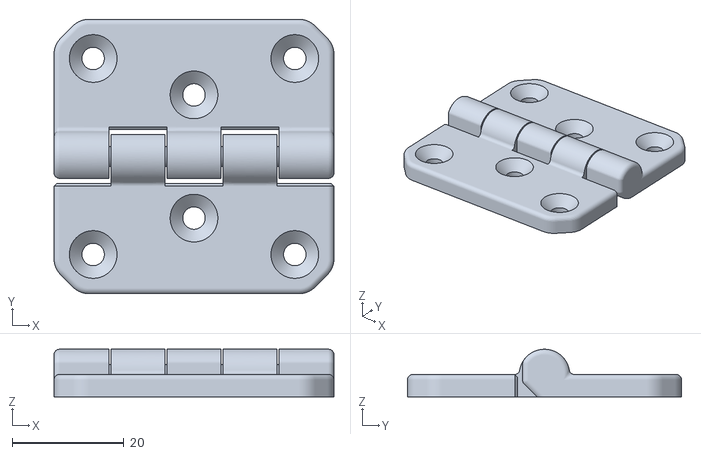
[picture p182: CAD file, 2025-05-16]
Mechanical/Safety/Pneumatics_hydraulics_covers/Pneumatic-hydraulic cover/manufacturable_parts/hinge.stl
50.0 x 49.0 x 8.50
