anastasiia-gif/MiniFactoryTCF/Mechanical/Main_expo_sides/Back decorations/dxf_manufacturing/Half_big_circle_decoration.DXF

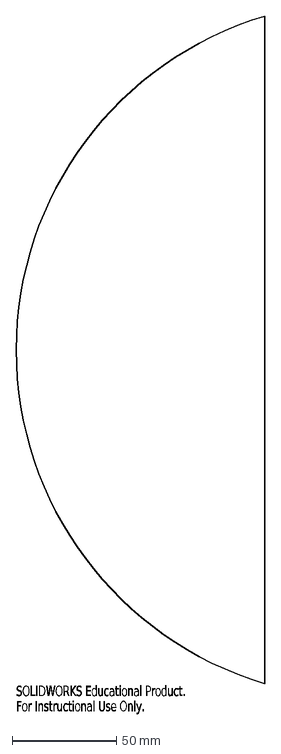
[picture p183: CAD file, 2025-05-16]
Mechanical/Main_expo_sides/Back decorations/dxf_manufacturing/Half_big_circle_decoration.DXF
SOLIDWORKS Educational Product.
For Instructional Use Only.
