anastasiia-gif/MiniFactoryTCF/Mechanical/Main_expo_sides/Back decorations/gear_like_bicycle1.SLDPRT

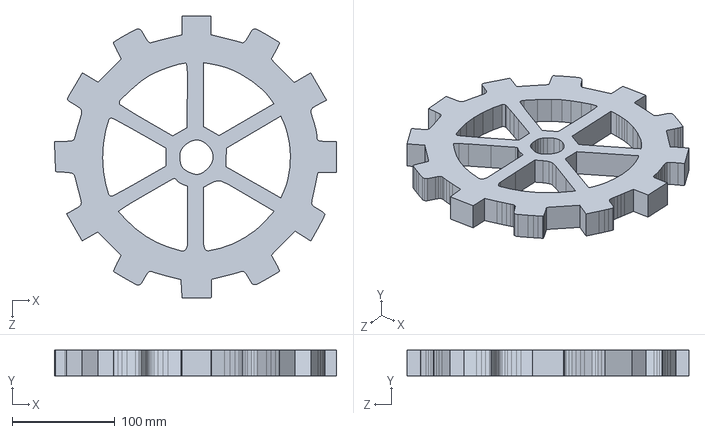
[picture p184: CAD file, 2025-05-16]
Mechanical/Main_expo_sides/Back decorations/gear_like_bicycle1.SLDPRT
274.5 x 25.0 x 274.3 mm
