anastasiia-gif/MiniFactoryTCF/Mechanical/Safety/Main_expo/Doors/door/Guide_for_doors.SLDPRT

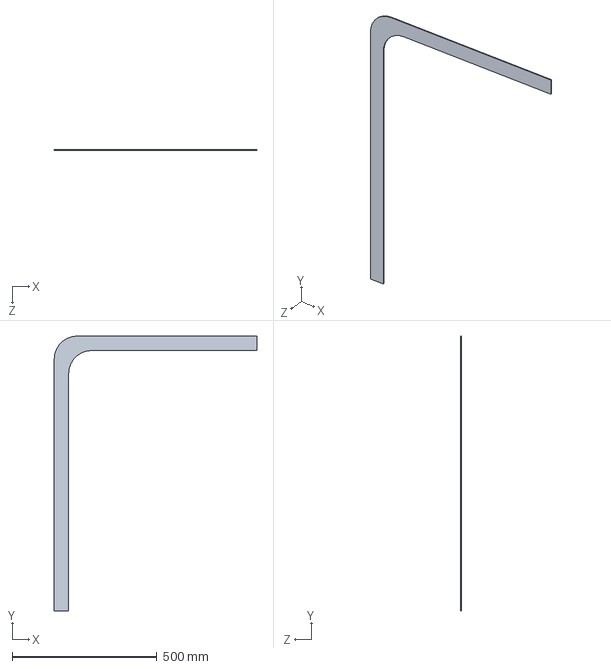
[picture p185: CAD file, 2025-05-16]
Mechanical/Safety/Main_expo/Doors/door/Guide_for_doors.SLDPRT
700.0 x 950.0 x 3.00 mm
