anastasiia-gif/MiniFactoryTCF/Mechanical/Safety/Main_expo/Doors/door/manufacturable parts/small_screens_right_x5.DXF

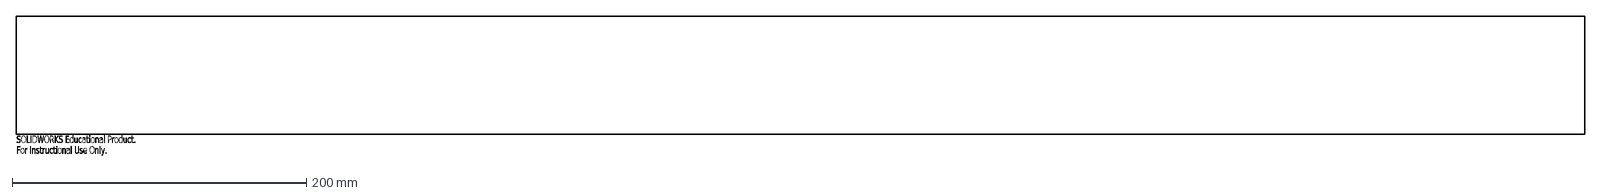
[picture p186: CAD file, 2025-05-16]
Mechanical/Safety/Main_expo/Doors/door/manufacturable parts/small_screens_right_x5.DXF
SOLIDWORKS Educational Product.
For Instructional Use Only.
