anastasiia-gif/MiniFactoryTCF/Mechanical/Safety/Main_expo/Doors/door/big_screen_right.SLDPRT

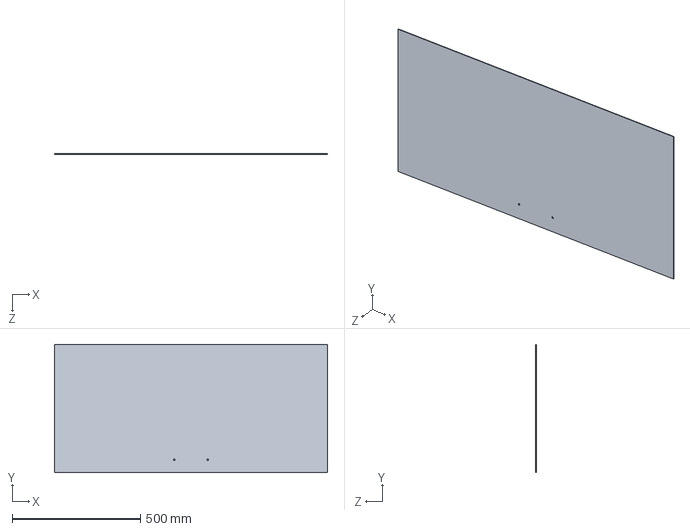
[picture p187: CAD file, 2025-05-16]
Mechanical/Safety/Main_expo/Doors/door/big_screen_right.SLDPRT
1065.0 x 500.0 x 2.00 mm
