anastasiia-gif/MiniFactoryTCF/Mechanical/Safety/Main_expo/Doors/door/manufacturable parts/small_screen_left_x5.DXF

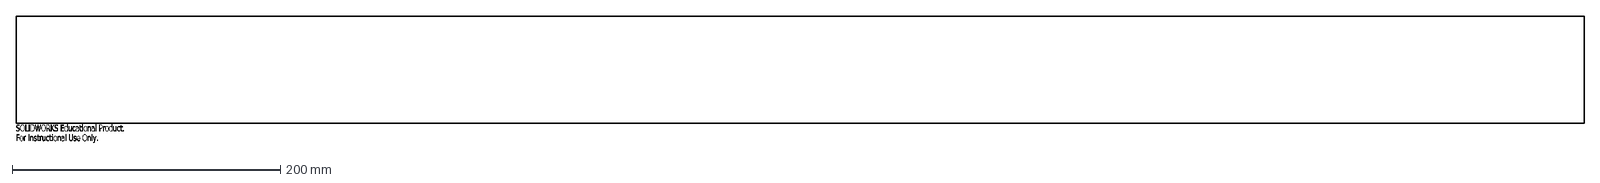
[picture p188: CAD file, 2025-05-16]
Mechanical/Safety/Main_expo/Doors/door/manufacturable parts/small_screen_left_x5.DXF
SOLIDWORKS Educational Product.
For Instructional Use Only.
