anastasiia-gif/MiniFactoryTCF/Mechanical/Main_expo_sides/Back decorations/gear_circles.SLDPRT

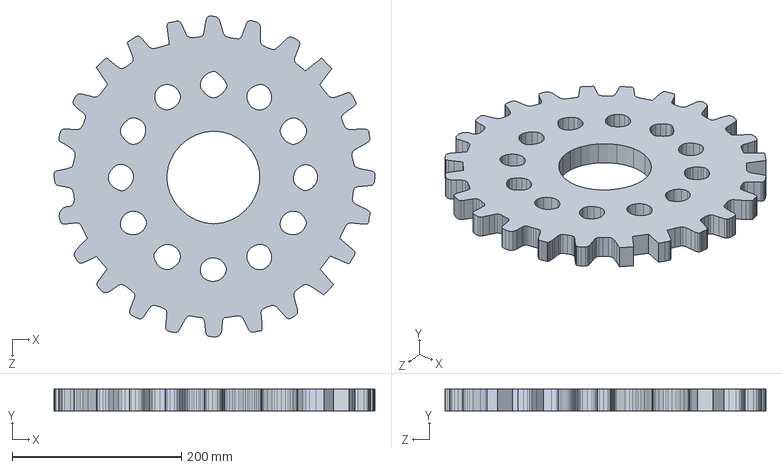
[picture p191: CAD file, 2025-05-16]
Mechanical/Main_expo_sides/Back decorations/gear_circles.SLDPRT
379.7 x 25.8 x 379.8 mm
