anastasiia-gif/MiniFactoryTCF/Mechanical/Safety/Main_expo/Dividers/Dividers_electrical_box/Electrical_box_cover.SLDPRT

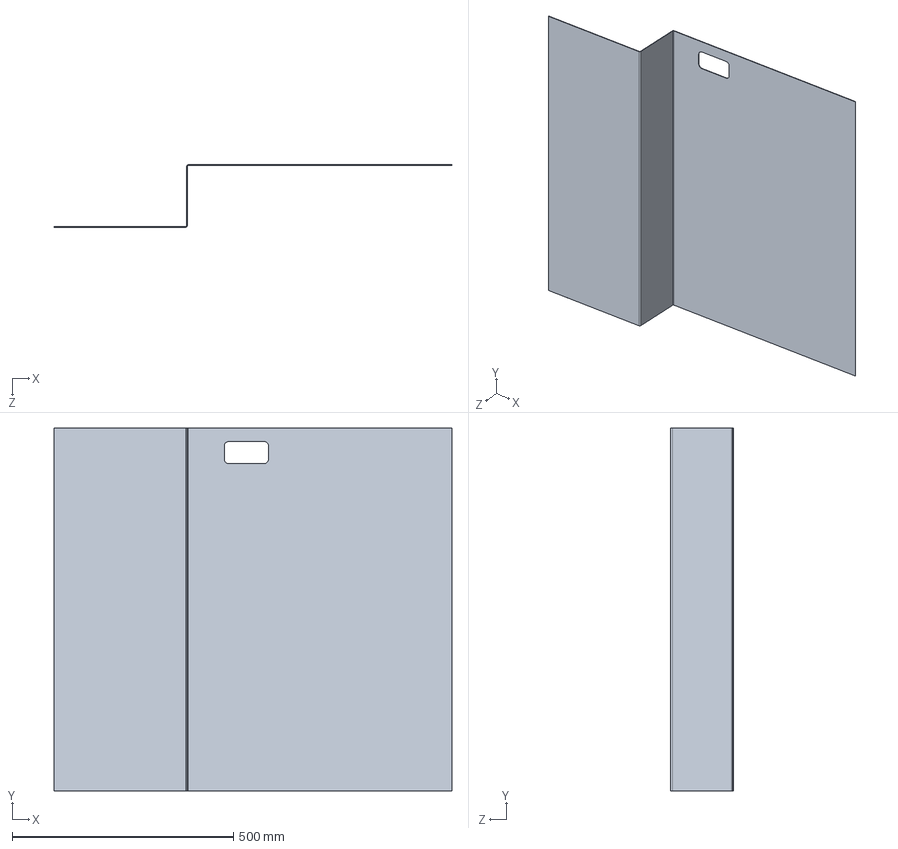
[picture p192: CAD file, 2025-05-16]
Mechanical/Safety/Main_expo/Dividers/Dividers_electrical_box/Electrical_box_cover.SLDPRT
900.0 x 820.0 x 141.5 mm
