anastasiia-gif/MiniFactoryTCF/Mechanical/Safety/Main_expo/Dividers/Dividers_electrical_box/Manufacturable parts/Hydraulic_press_cover.DXF

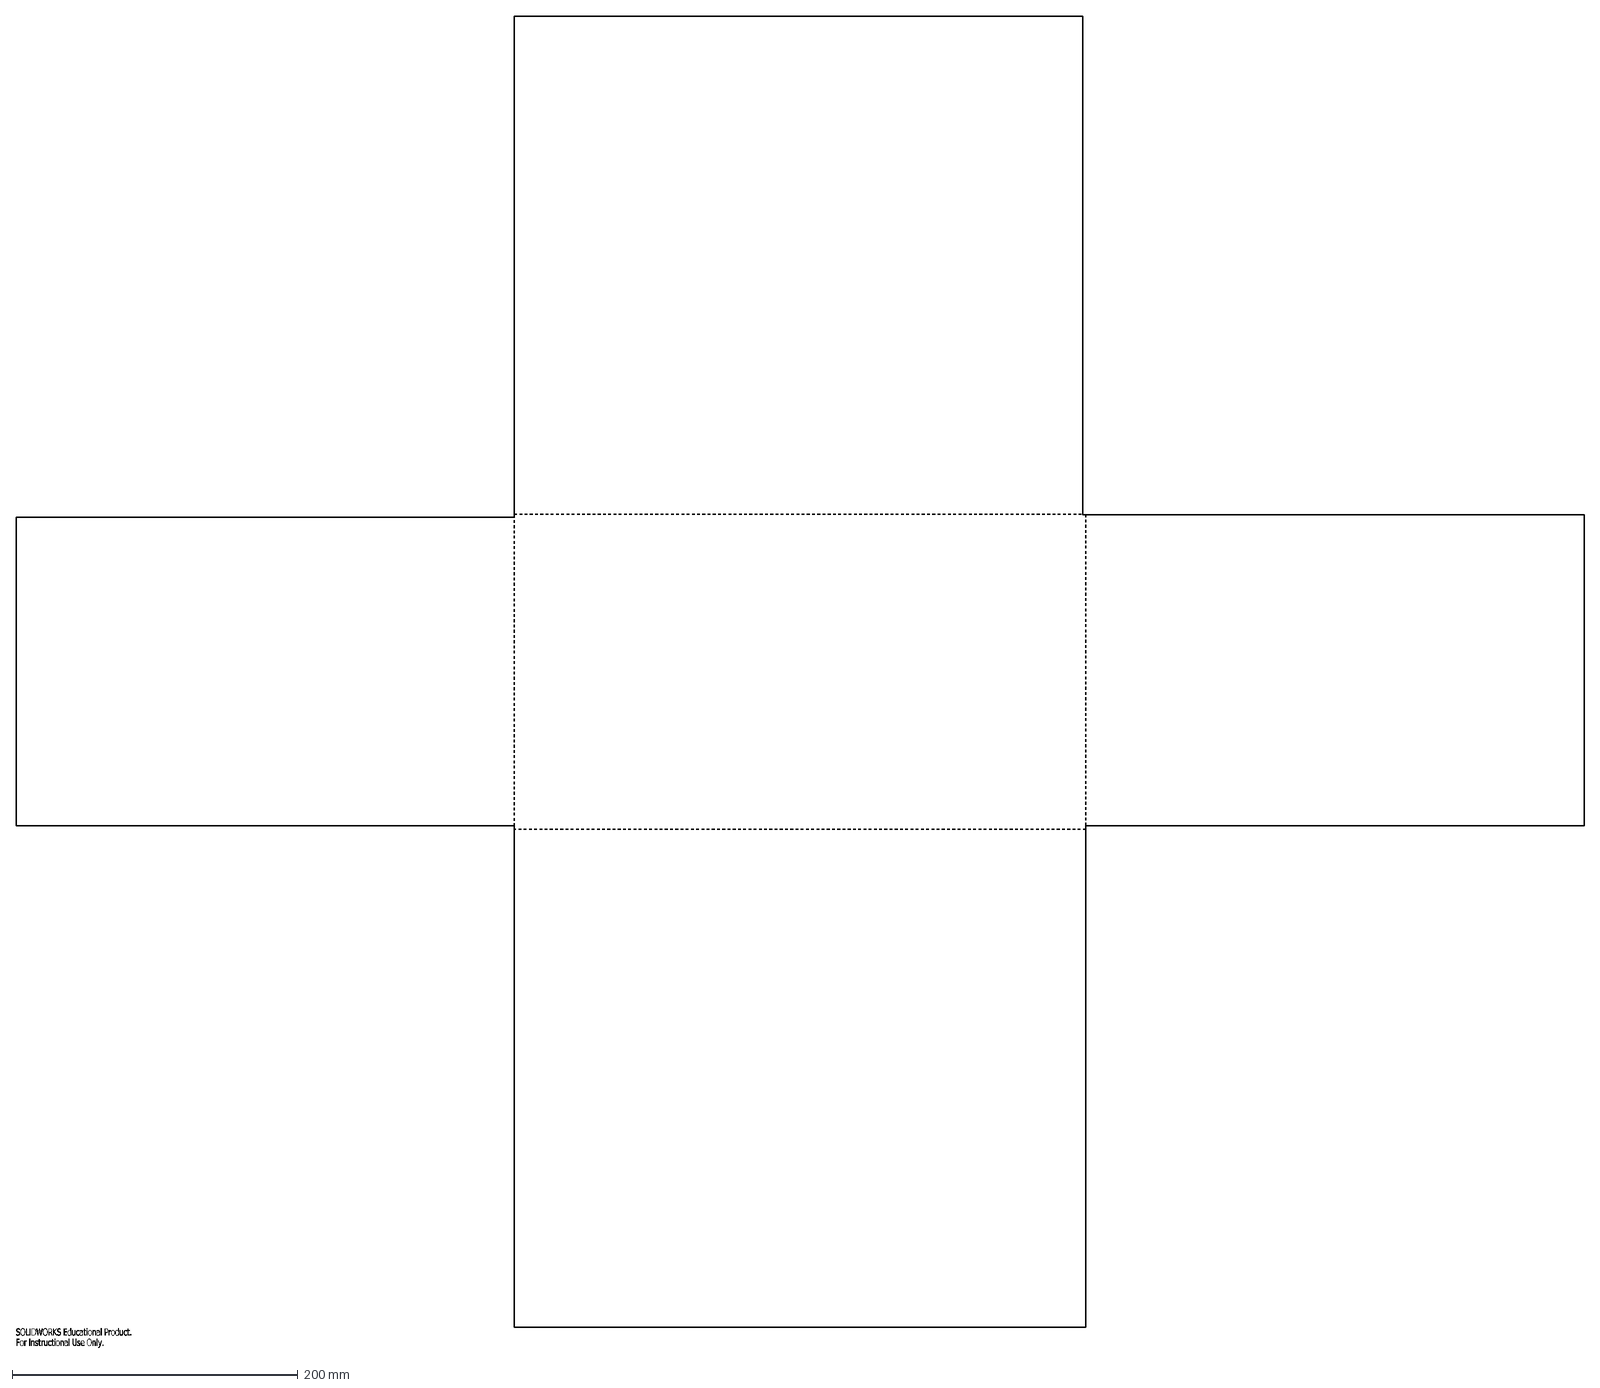
[picture p193: CAD file, 2025-05-16]
Mechanical/Safety/Main_expo/Dividers/Dividers_electrical_box/Manufacturable parts/Hydraulic_press_cover.DXF
SOLIDWORKS Educational Product.
For Instructional Use Only.
