anastasiia-gif/MiniFactoryTCF/Mechanical/Main_expo_sides/Back decorations/fixator.SLDPRT

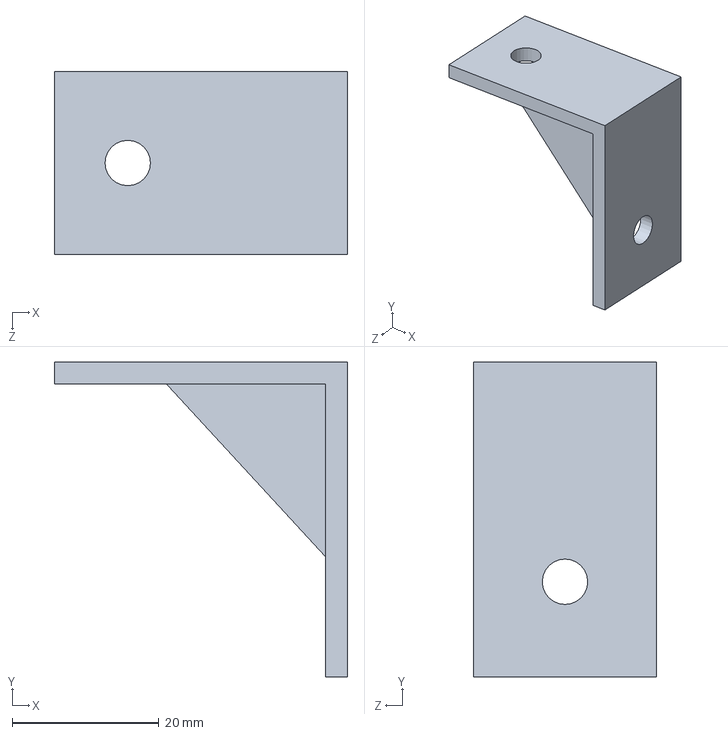
[picture p198: CAD file, 2025-05-16]
Mechanical/Main_expo_sides/Back decorations/fixator.SLDPRT
40.0 x 43.0 x 25.0 mm
