anastasiia-gif/MiniFactoryTCF/Mechanical/Safety/Pneumatics_hydraulics_covers/Pneumatic-hydraulic cover/Bottom part.SLDPRT

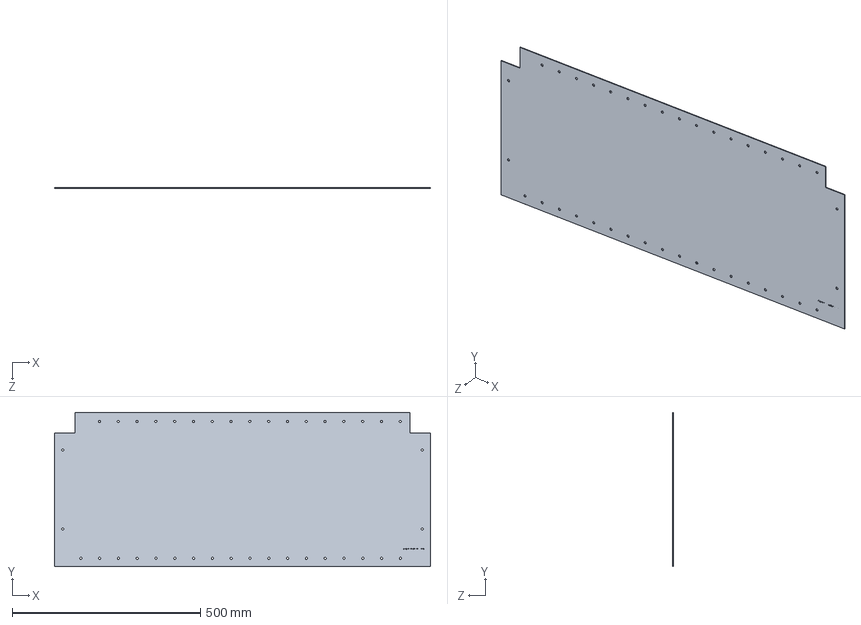
[picture p199: CAD file, 2025-05-16]
Mechanical/Safety/Pneumatics_hydraulics_covers/Pneumatic-hydraulic cover/Bottom part.SLDPRT
1000.0 x 410.0 x 2.00 mm
