anastasiia-gif/MiniFactoryTCF/Mechanical/Main_expo_sides/Back decorations/dxf_manufacturing/gear_circles.DXF

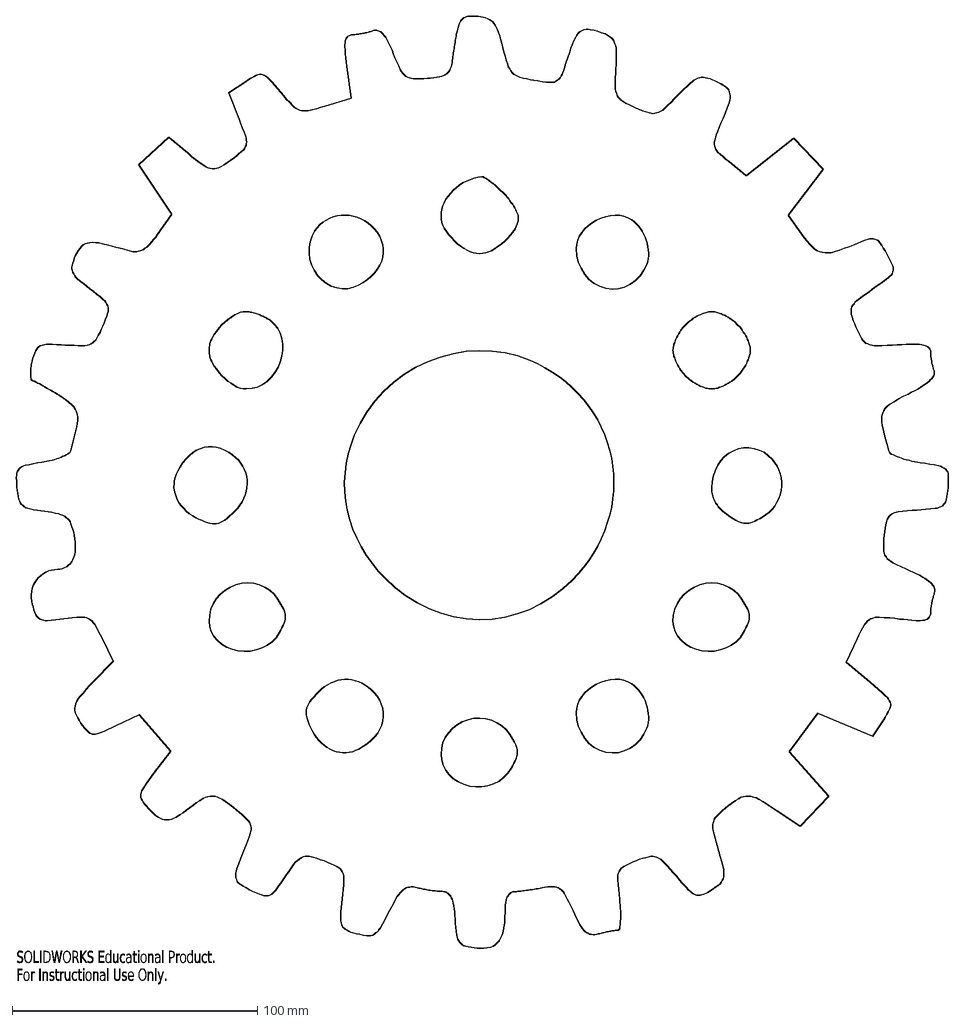
[picture p200: CAD file, 2025-05-16]
Mechanical/Main_expo_sides/Back decorations/dxf_manufacturing/gear_circles.DXF
SOLIDWORKS Educational Product.
For Instructional Use Only.
