anastasiia-gif/MiniFactoryTCF/Mechanical/Main_expo_sides/Back decorations/dxf_manufacturing/logo.DXF

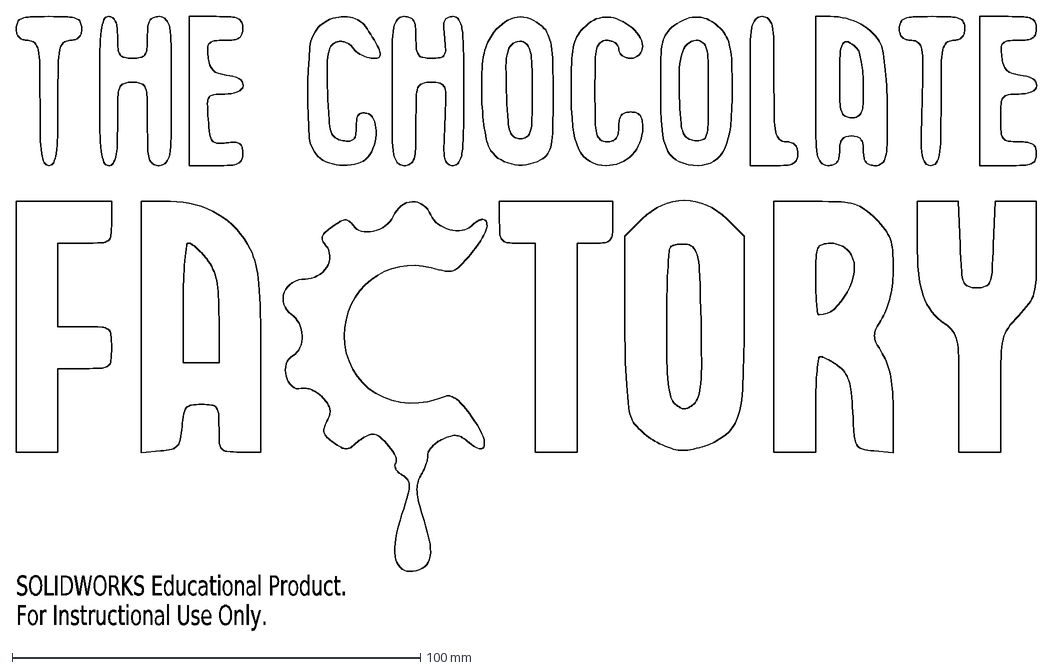
[picture p203: CAD file, 2025-05-16]
Mechanical/Main_expo_sides/Back decorations/dxf_manufacturing/logo.DXF
SOLIDWORKS Educational Product.
For Instructional Use Only.
