anastasiia-gif/MiniFactoryTCF/Mechanical/Main_expo_sides/Back decorations/gear_bicycle_smaller1.SLDPRT

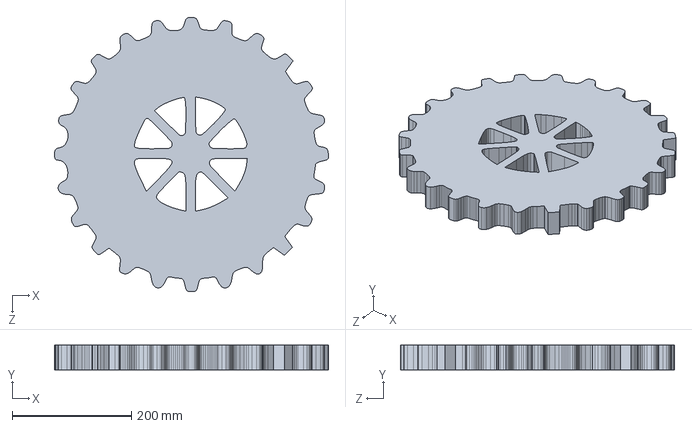
[picture p204: CAD file, 2025-05-16]
Mechanical/Main_expo_sides/Back decorations/gear_bicycle_smaller1.SLDPRT
460.4 x 42.0 x 460.9 mm
