anastasiia-gif/MiniFactoryTCF/Mechanical/Main_expo_sides/Back decorations/dxf_manufacturing/gear_holes1.DXF

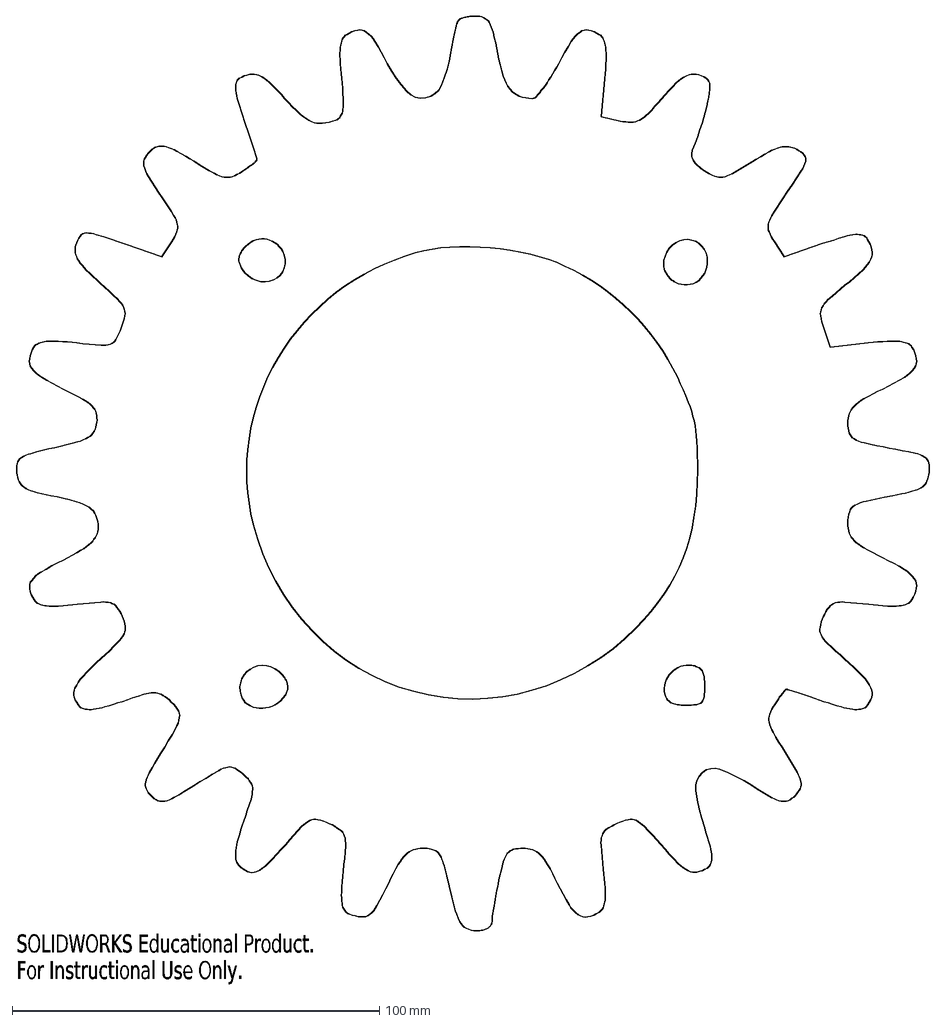
[picture p205: CAD file, 2025-05-16]
Mechanical/Main_expo_sides/Back decorations/dxf_manufacturing/gear_holes1.DXF
SOLIDWORKS Educational Product.
For Instructional Use Only.
