anastasiia-gif/MiniFactoryTCF/Mechanical/Main_expo_sides/Back decorations/gear_normal.SLDPRT

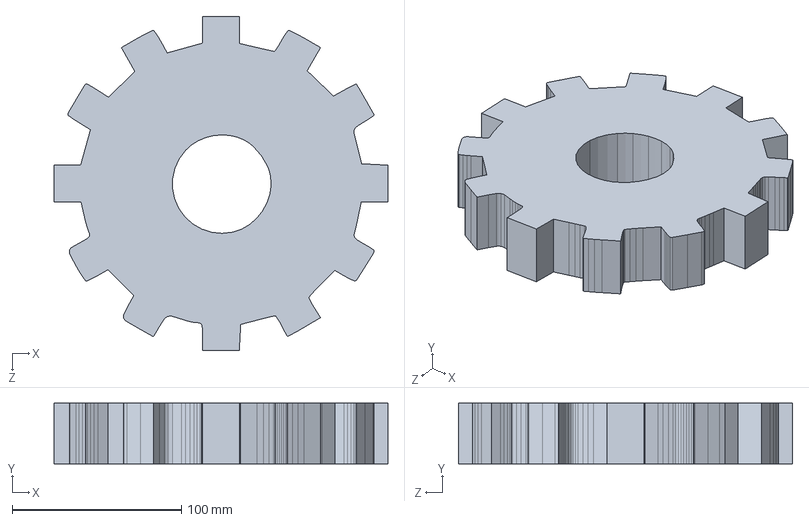
[picture p206: CAD file, 2025-05-16]
Mechanical/Main_expo_sides/Back decorations/gear_normal.SLDPRT
197.5 x 36.0 x 197.5 mm
