anastasiia-gif/MiniFactoryTCF/Mechanical/Main_expo_sides/Back decorations/guy_carring_box.SLDPRT

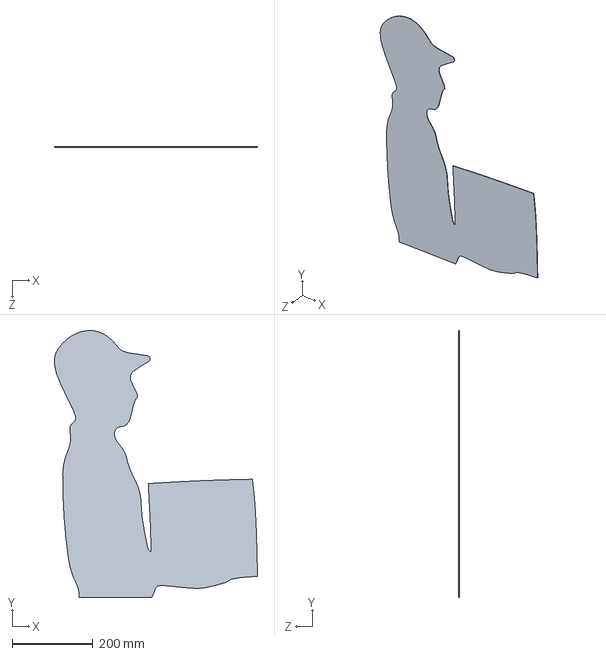
[picture p207: CAD file, 2025-05-16]
Mechanical/Main_expo_sides/Back decorations/guy_carring_box.SLDPRT
504.1 x 662.5 x 1.25 mm
