anastasiia-gif/MiniFactoryTCF/Mechanical/Main_expo_sides/Back decorations/person_with_box.dxf

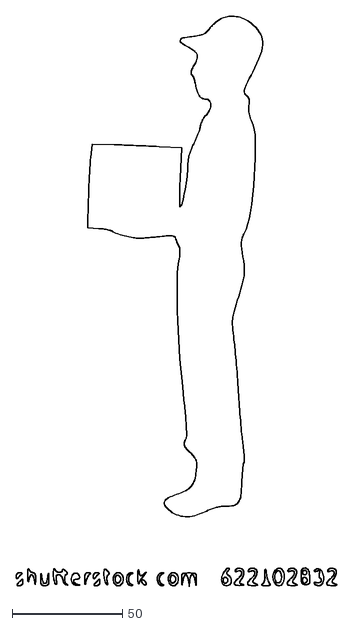
[picture p208: CAD file, 2025-05-16]
Mechanical/Main_expo_sides/Back decorations/person_with_box.dxf
145.6 x 259.1
