anastasiia-gif/MiniFactoryTCF/Mechanical/Box_design/Assem_complete_box.SLDASM

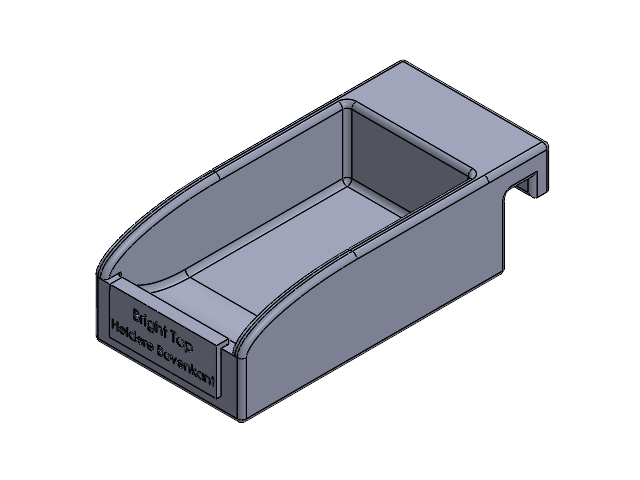
[picture p209: CAD file, 2025-05-16]
Mechanical/Box_design/Assem_complete_box.SLDASM
Holder_for_boxes
Brigh_top_plate
