anastasiia-gif/MiniFactoryTCF/Mechanical/Safety/Pneumatics_hydraulics_covers/Pneumatic-hydraulic cover/Assembly_bottom_covers.SLDASM

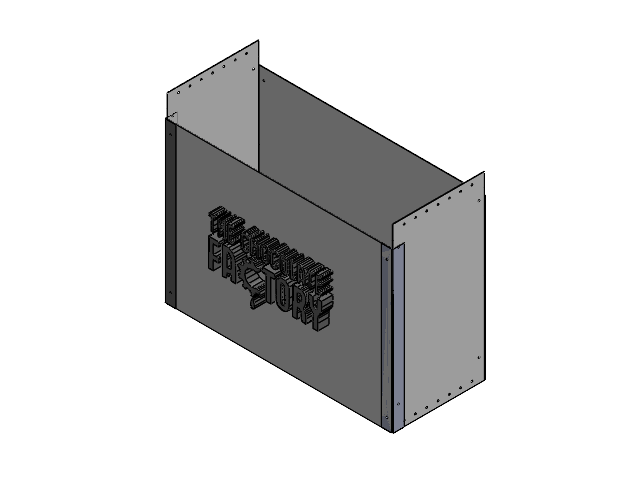
[picture p210: CAD file, 2025-05-16]
Mechanical/Safety/Pneumatics_hydraulics_covers/Pneumatic-hydraulic cover/Assembly_bottom_covers.SLDASM
Bottom part
Front part x 2
Side part x 2
3d_logo_bottom_covers
side_covers x 2
