anastasiia-gif/MiniFactoryTCF/Mechanical/Main_expo_sides/Back decorations/Right_front_decorations.SLDASM

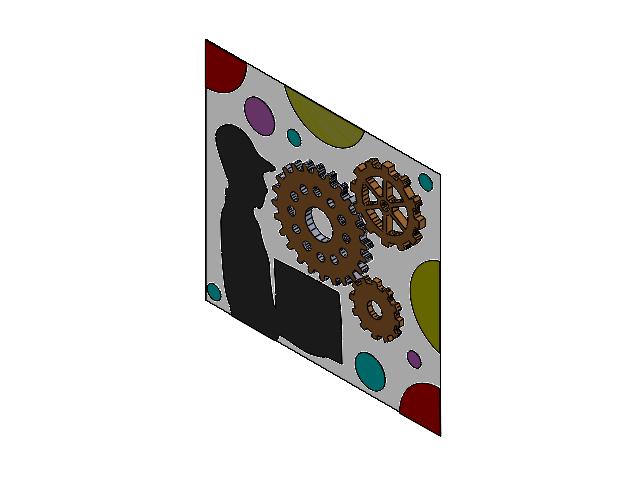
[picture p211: CAD file, 2025-05-16]
Mechanical/Main_expo_sides/Back decorations/Right_front_decorations.SLDASM
Main_cover_body
Half_circle^Right_front_decorations x 2
gear_circles
gear_normal
gear_like_bicycle1
guy_carring_box
circle_decoration x 2
Half_big_circle_decoration x 2
Small_circle_decoration x 4
