anastasiia-gif/MiniFactoryTCF/Mechanical/Main_expo_sides/Back decorations/Left_back_decoration.SLDASM

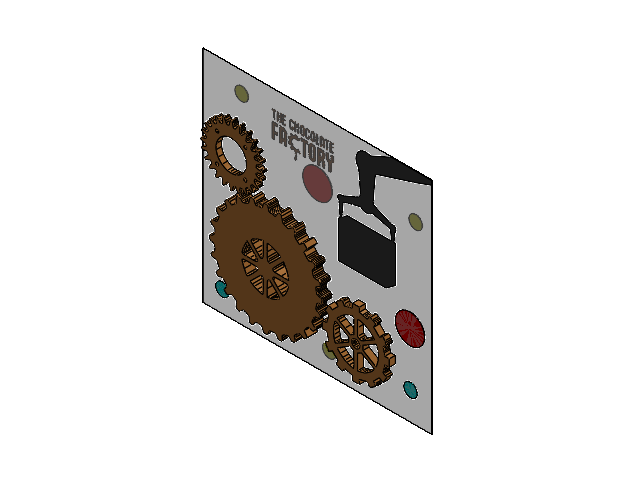
[picture p212: CAD file, 2025-05-16]
Mechanical/Main_expo_sides/Back decorations/Left_back_decoration.SLDASM
Main_cover_body
circle_decoration x 2
Small_circle_decoration x 5
gear_bicycle_smaller1
gear_holes1
gear_like_bicycle_L
robotic_arm_box
logo
