anastasiia-gif/MiniFactoryTCF/Mechanical/Safety/Pneumatics_hydraulics_covers/Pneumatic-hydraulic cover/Assem_back_door.SLDASM

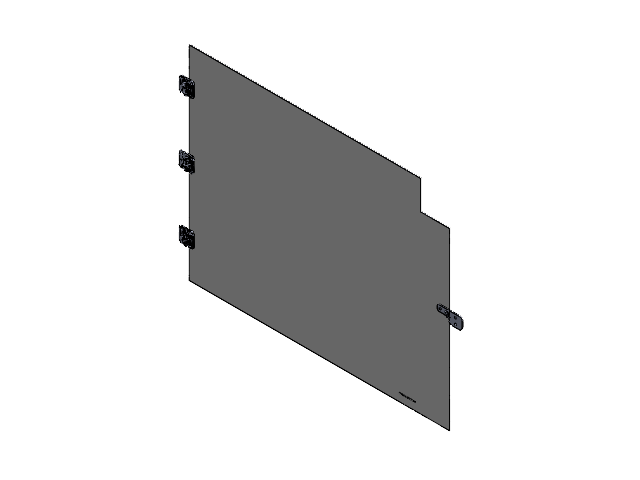
[picture p213: CAD file, 2025-05-16]
Mechanical/Safety/Pneumatics_hydraulics_covers/Pneumatic-hydraulic cover/Assem_back_door.SLDASM
Back_part
Hinge_lock_back_door_1
hinge x 3
Hinge_lock_back_door
