anastasiia-gif/MiniFactoryTCF/(list of files, cad)

Other CAD files:
Mechanical/Box_design/Brigh_top_plate.SLDPRT
Mechanical/Electrical_covers/motor_electronics_cover.SLDPRT
Mechanical/Box_design/Bright_bottom_plate.SLDPRT
Mechanical/Box_design/Holder_for_boxes.SLDPRT
Mechanical/Box_design/manufacturable_parts/Bright_bottom_plate.STL
Mechanical/Electrical_covers/linear_actuator_electronics_cover.SLDPRT
Mechanical/Electrical_covers/manufacturable parts/press_electronics_cover.STL
Mechanical/Box_design/Dark_bottom_plate.SLDPRT
Mechanical/Box_design/manufacturable_parts/Dark_top_plate.STL
Mechanical/Electrical_covers/manufacturable parts/conveyor_sensor_cover.STL
Mechanical/Safety/Main_expo/Doors/door/manufacturable parts/Barn_Door_Handle.STL
Mechanical/Safety/Pneumatics_hydraulics_covers/Pneumatic-hydraulic cover/manufacturable_parts/connector_for_bottom.STL
Mechanical/Box_design/Dark_top_plate.SLDPRT
Mechanical/Electrical_covers/Box_deposit.SLDPRT
Mechanical/Electrical_covers/manufacturable parts/button_controller_cover.STL
Mechanical/Main_expo_sides/Back decorations/Small_circle_decoration.SLDPRT
Mechanical/Safety/Pneumatics_hydraulics_covers/Pneumatic-hydraulic cover/hinge.SLDPRT
Mechanical/Safety/Pneumatics_hydraulics_covers/Pneumatic-hydraulic cover/manufacturable_parts/Hinge_lock_back_door_1.STL
Mechanical/Main_expo_sides/Back decorations/Half_big_circle_decoration.SLDPRT
Mechanical/Main_expo_sides/Back decorations/dxf_manufacturing/gear_like_bicycle1.DXF
Mechanical/Safety/Pneumatics_hydraulics_covers/Pneumatic-hydraulic cover/side_covers.SLDPRT
Mechanical/Safety/Main_expo/Doors/door/hinge_small.SLDPRT
Mechanical/Safety/Pneumatics_hydraulics_covers/Pneumatic-hydraulic cover/manufacturable_parts/Hinge_lock_back_door.STL
Mechanical/Main_expo_sides/Back decorations/circle_decoration.SLDPRT
Mechanical/Main_expo_sides/Back decorations/dxf_manufacturing/fixator.STL
Mechanical/Main_expo_sides/Back decorations/gear_like_bicycle_L.SLDPRT
Mechanical/Safety/Pneumatics_hydraulics_covers/Pneumatic-hydraulic cover/3d_logo_bottom_covers.SLDPRT
Mechanical/Main_expo_sides/Back decorations/logo.dxf
Mechanical/Main_expo_sides/Back decorations/robotic_arm_box.dxf
