anastasiia-gif/MiniFactoryTCF/Manuals/Original manual/BRWEC5C68B1750E_005636.pdf

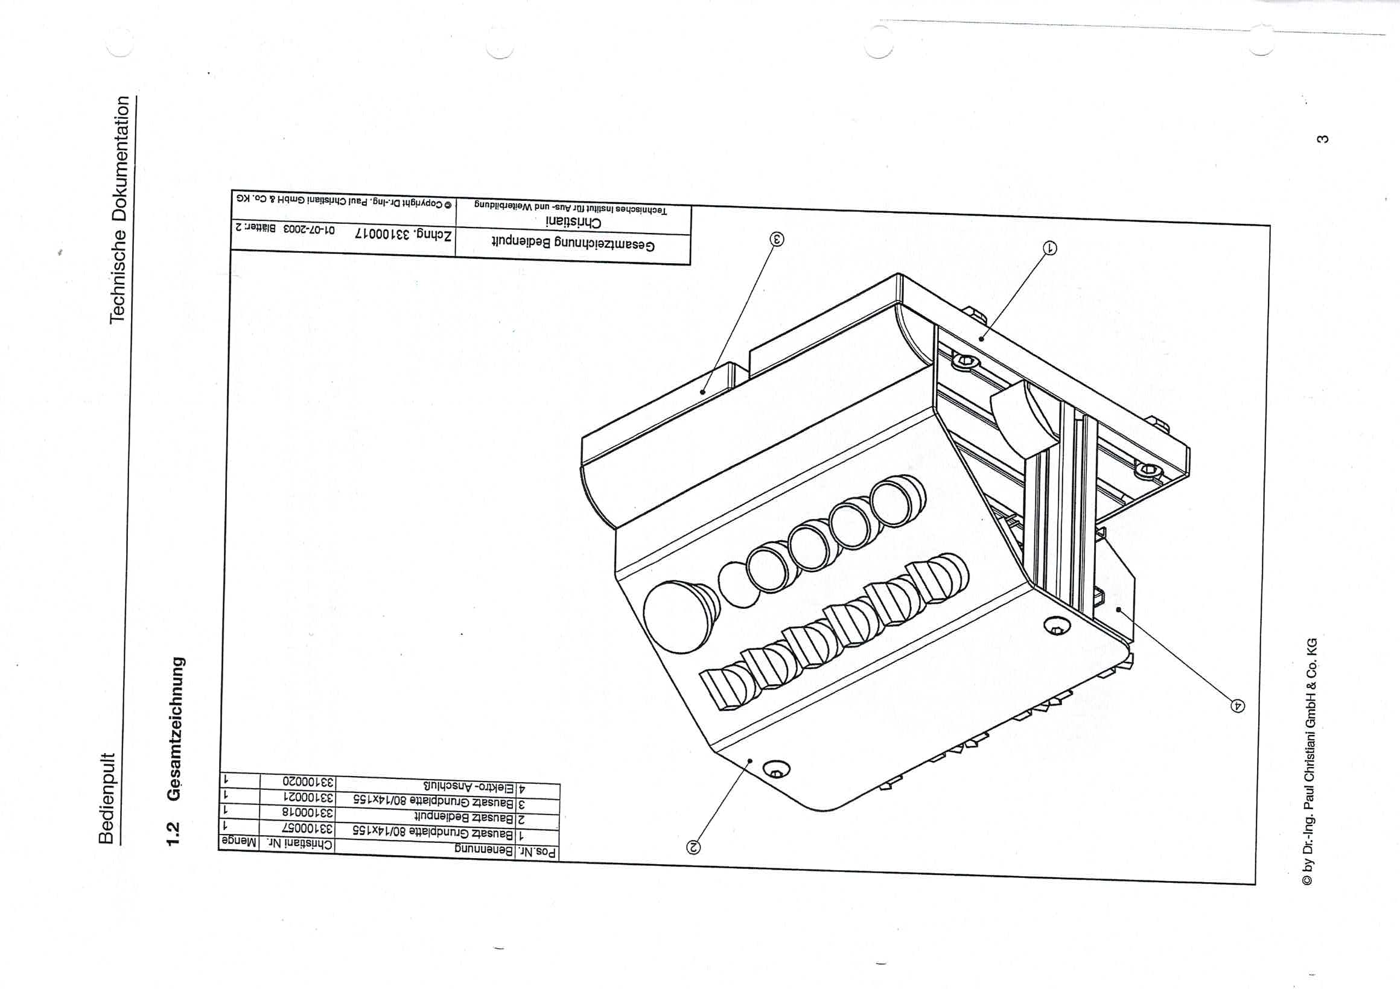
[picture p214: page 1]
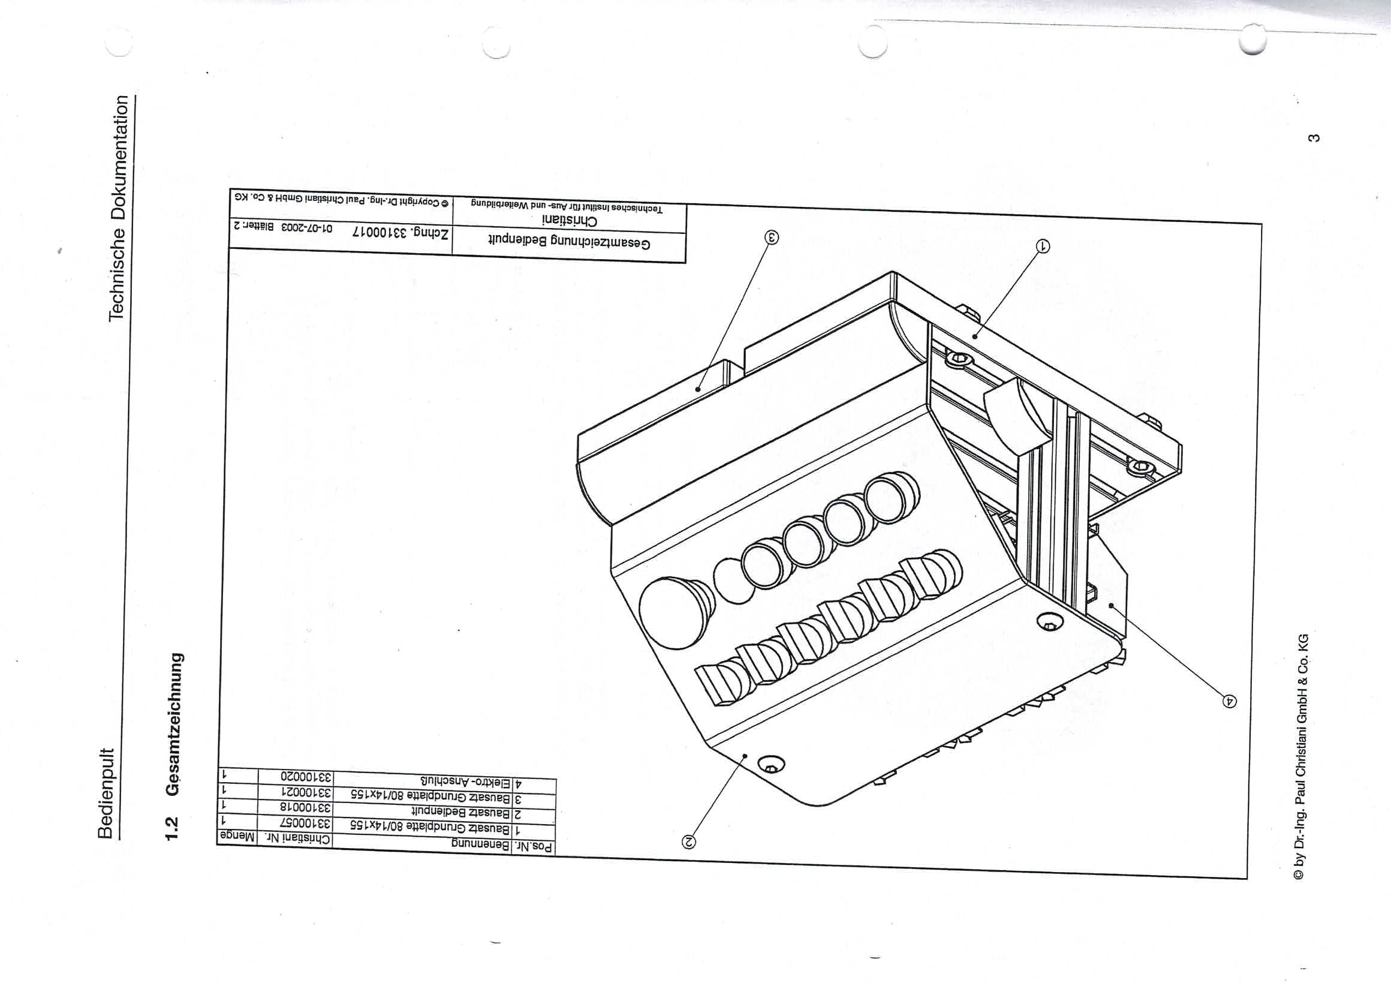
[picture p215: page 2]
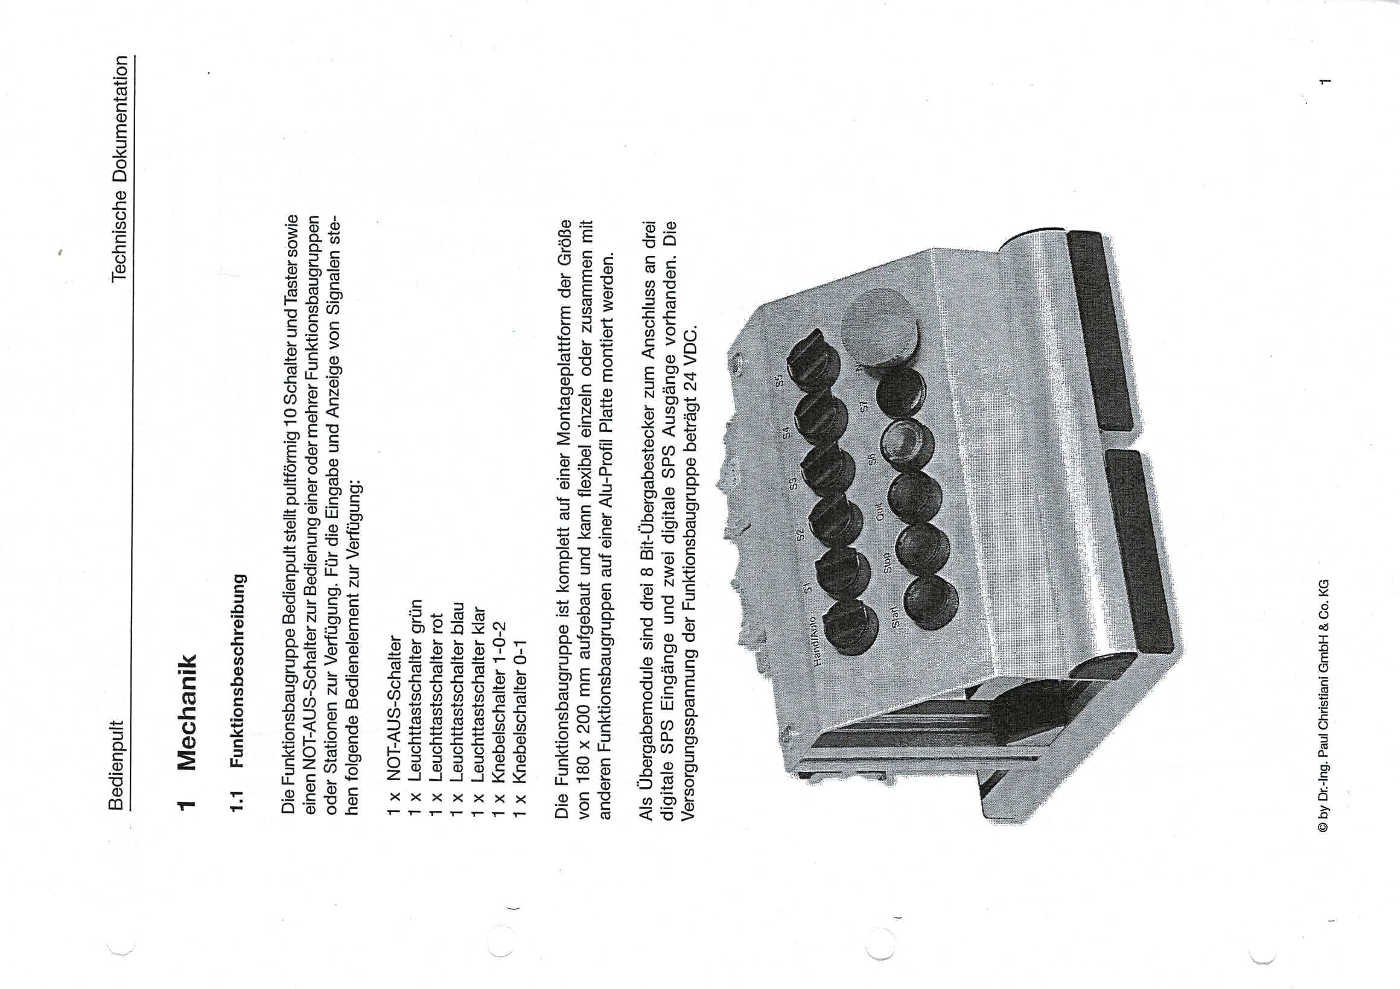
[picture p216: page 3]
