anastasiia-gif/MiniFactoryTCF/Manuals/Original manual/BRWEC5C68B1750E_005639.pdf

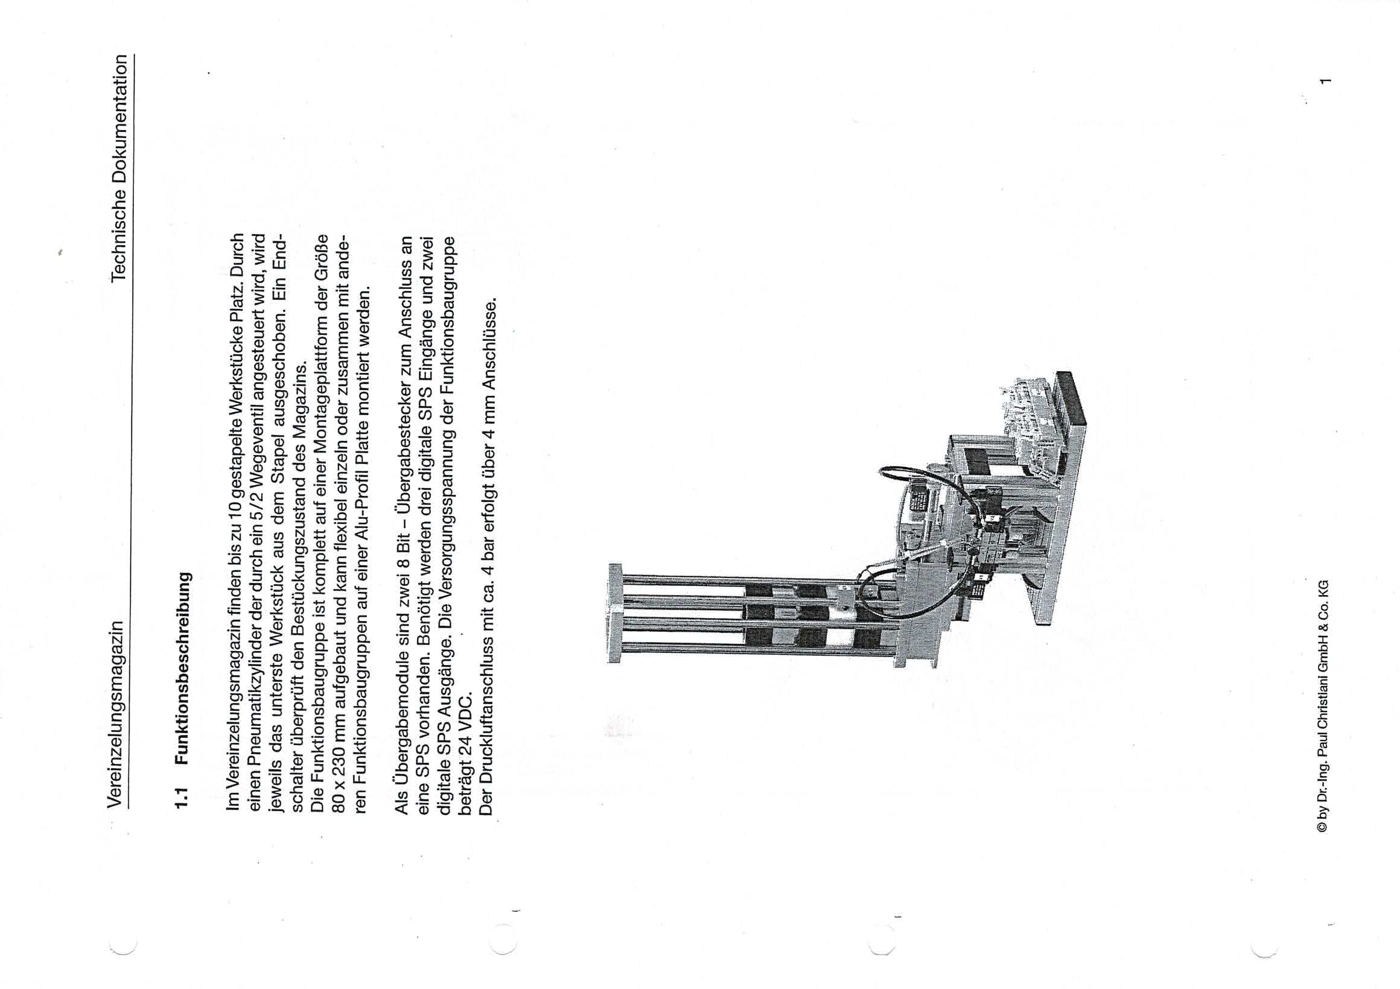
[picture p217: page 1]
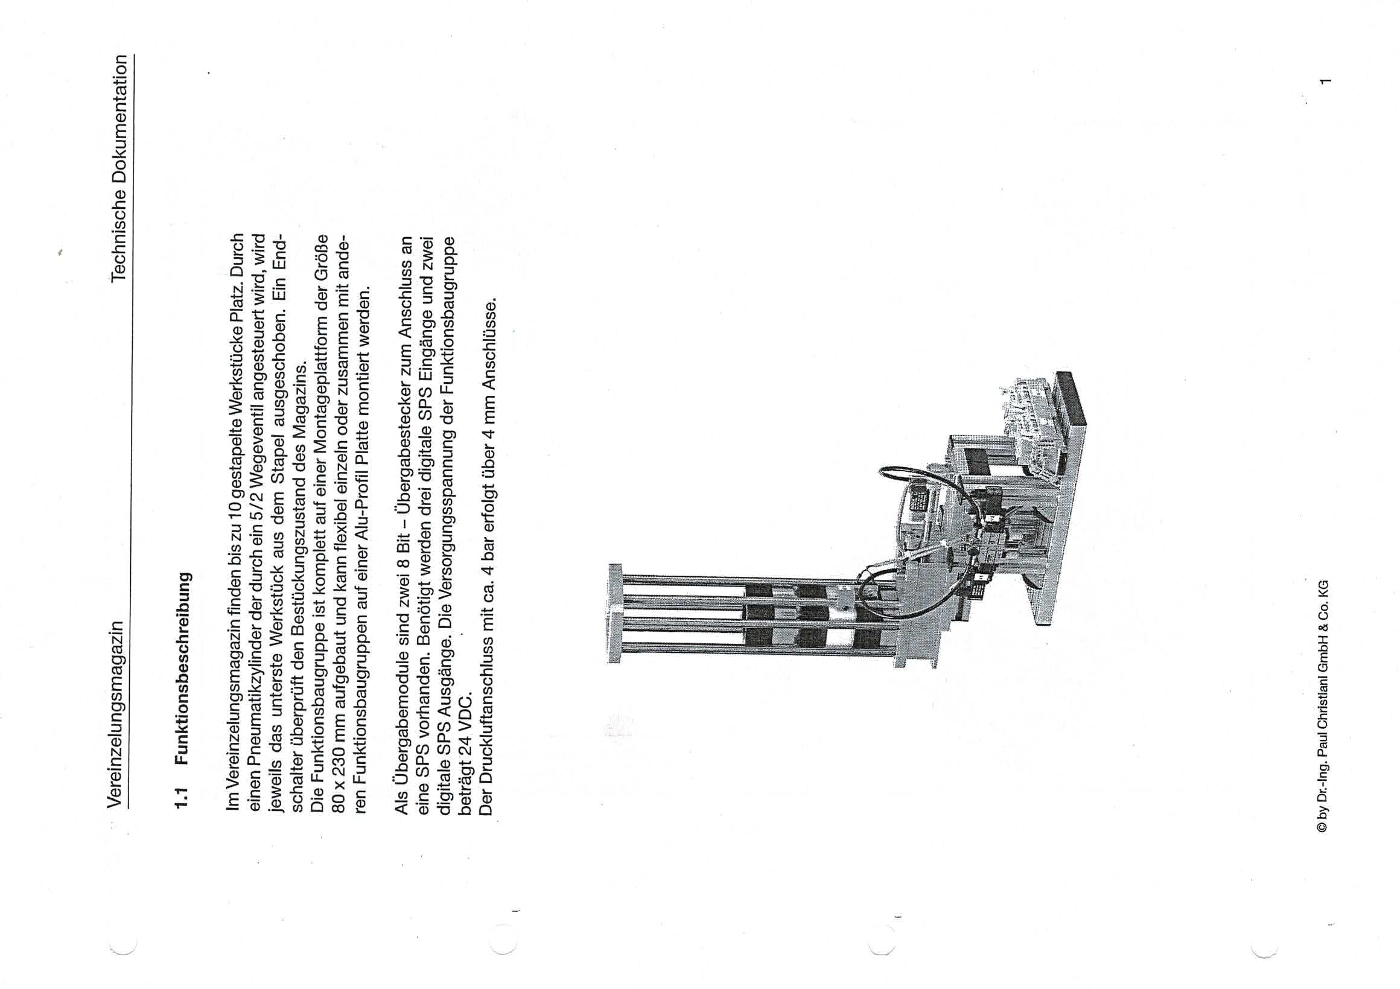
[picture p218: page 2]
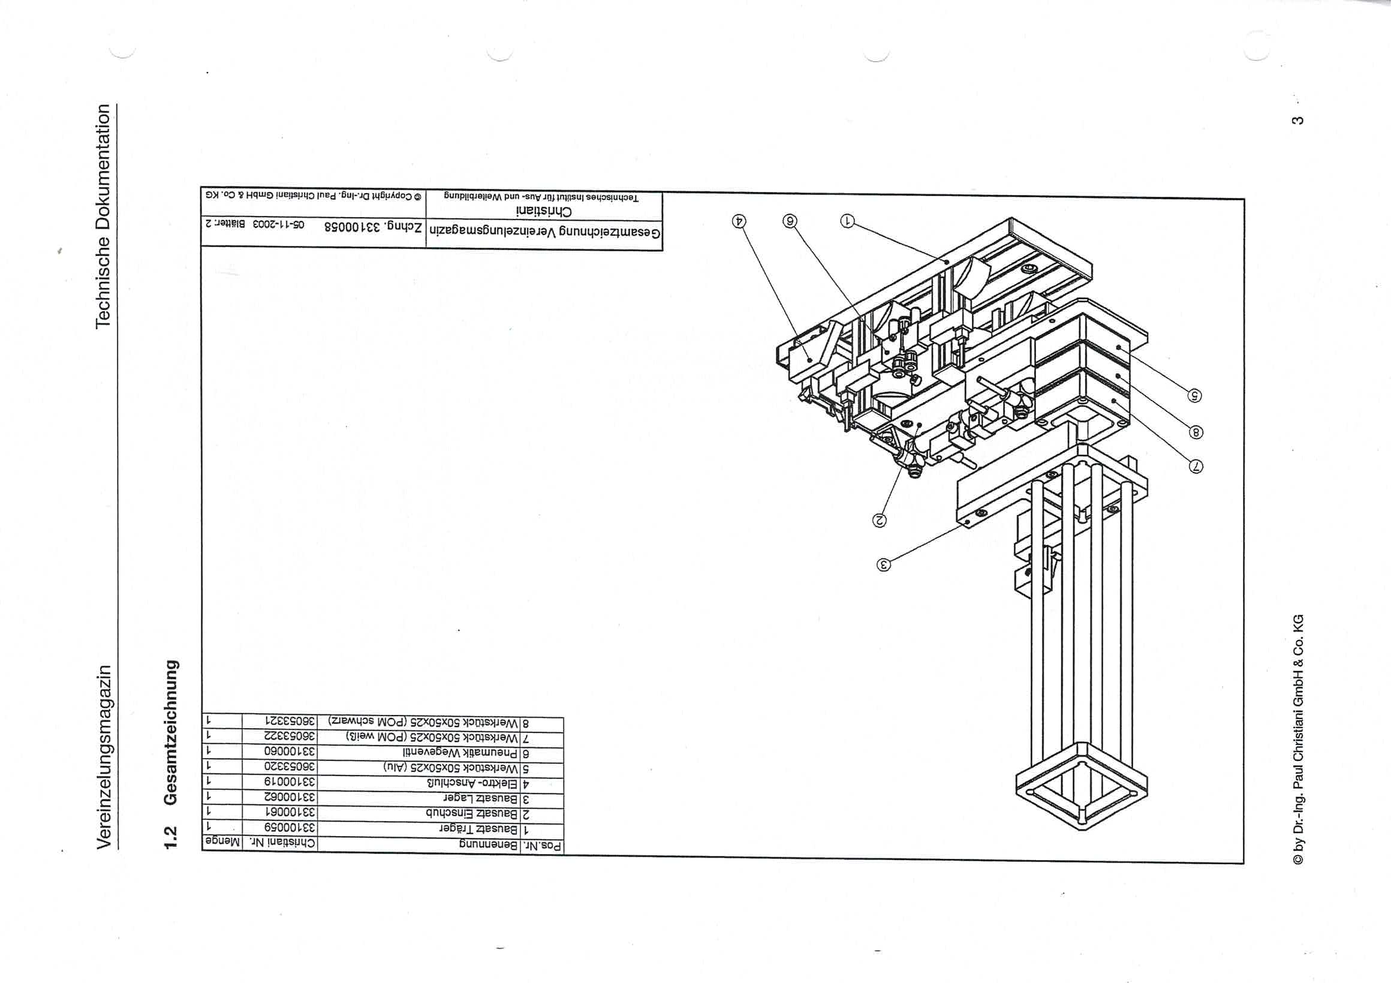
[picture p219: page 3]
