anastasiia-gif/MiniFactoryTCF/Manuals/Original manual/BRWEC5C68B1750E_005642.pdf

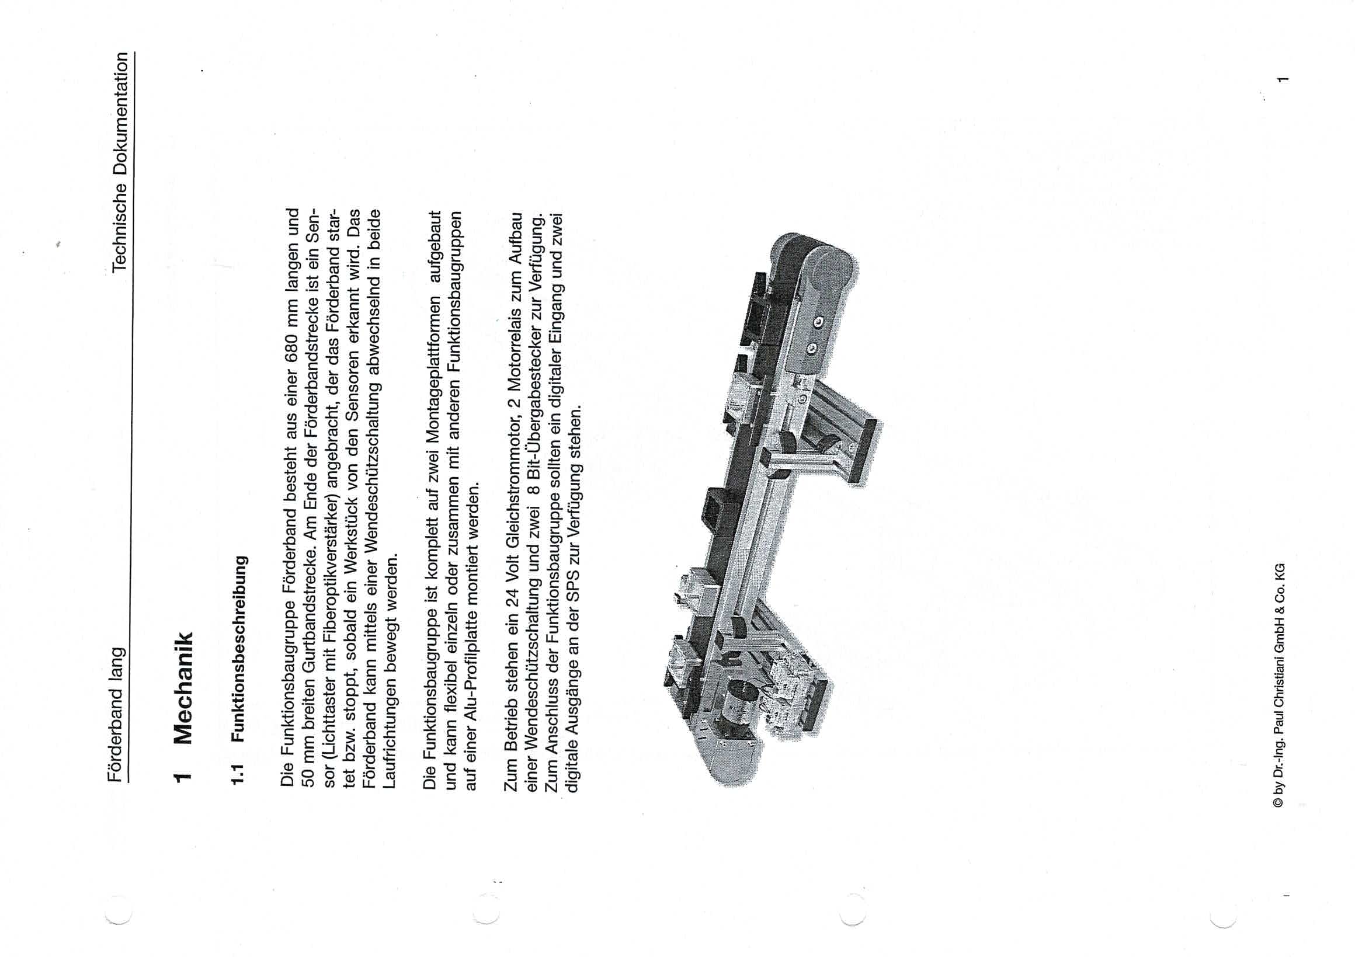
[picture p220: page 1]
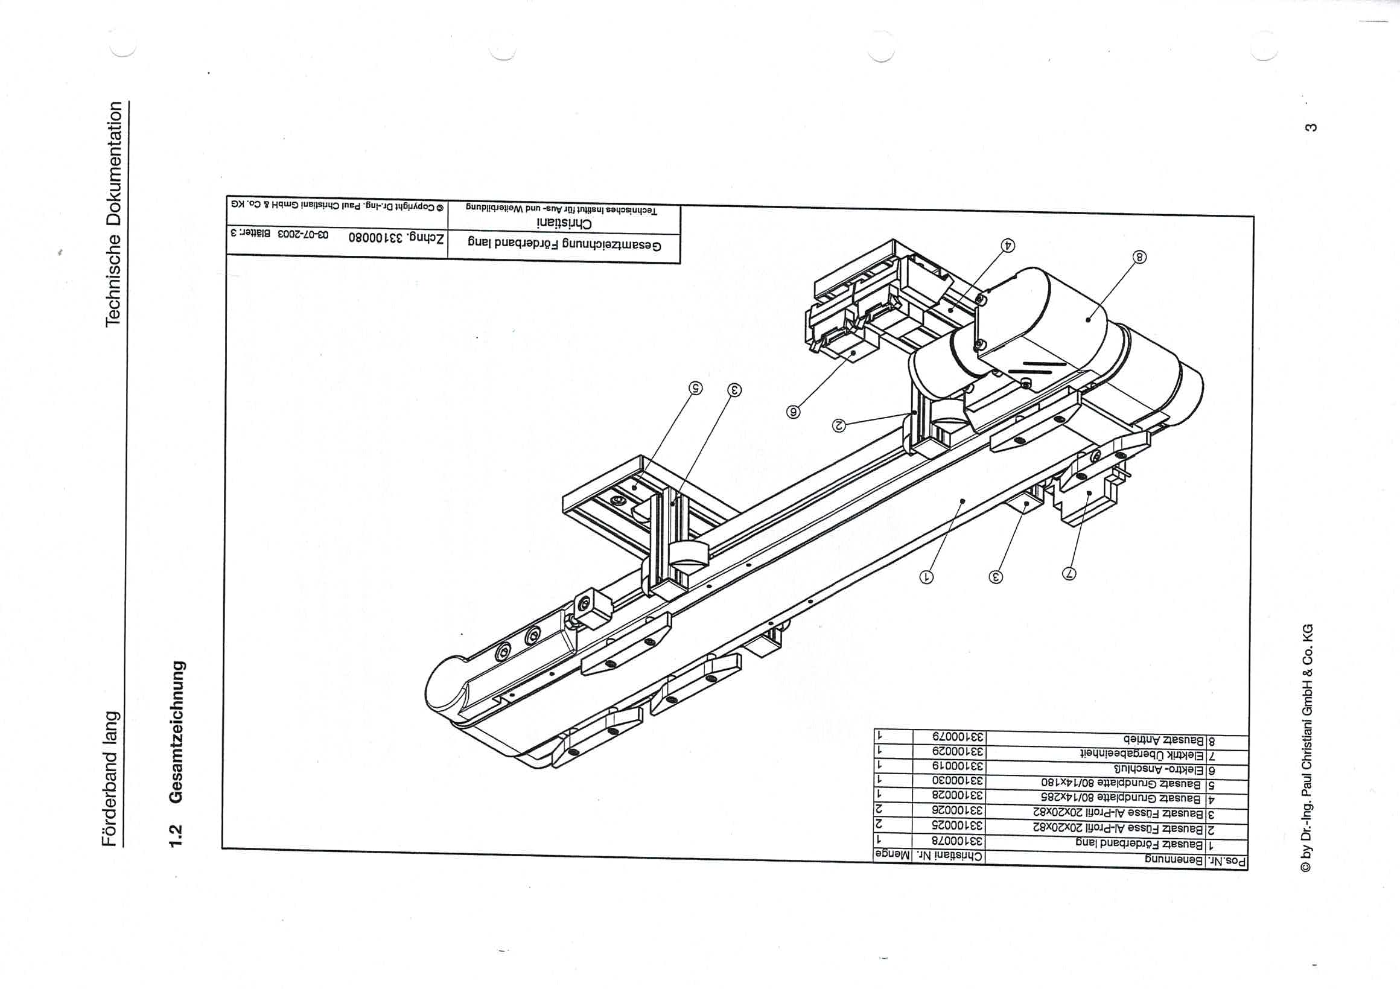
[picture p221: page 2]
