anastasiia-gif/MiniFactoryTCF/Manuals/Original manual/BRWEC5C68B1750E_005644.pdf

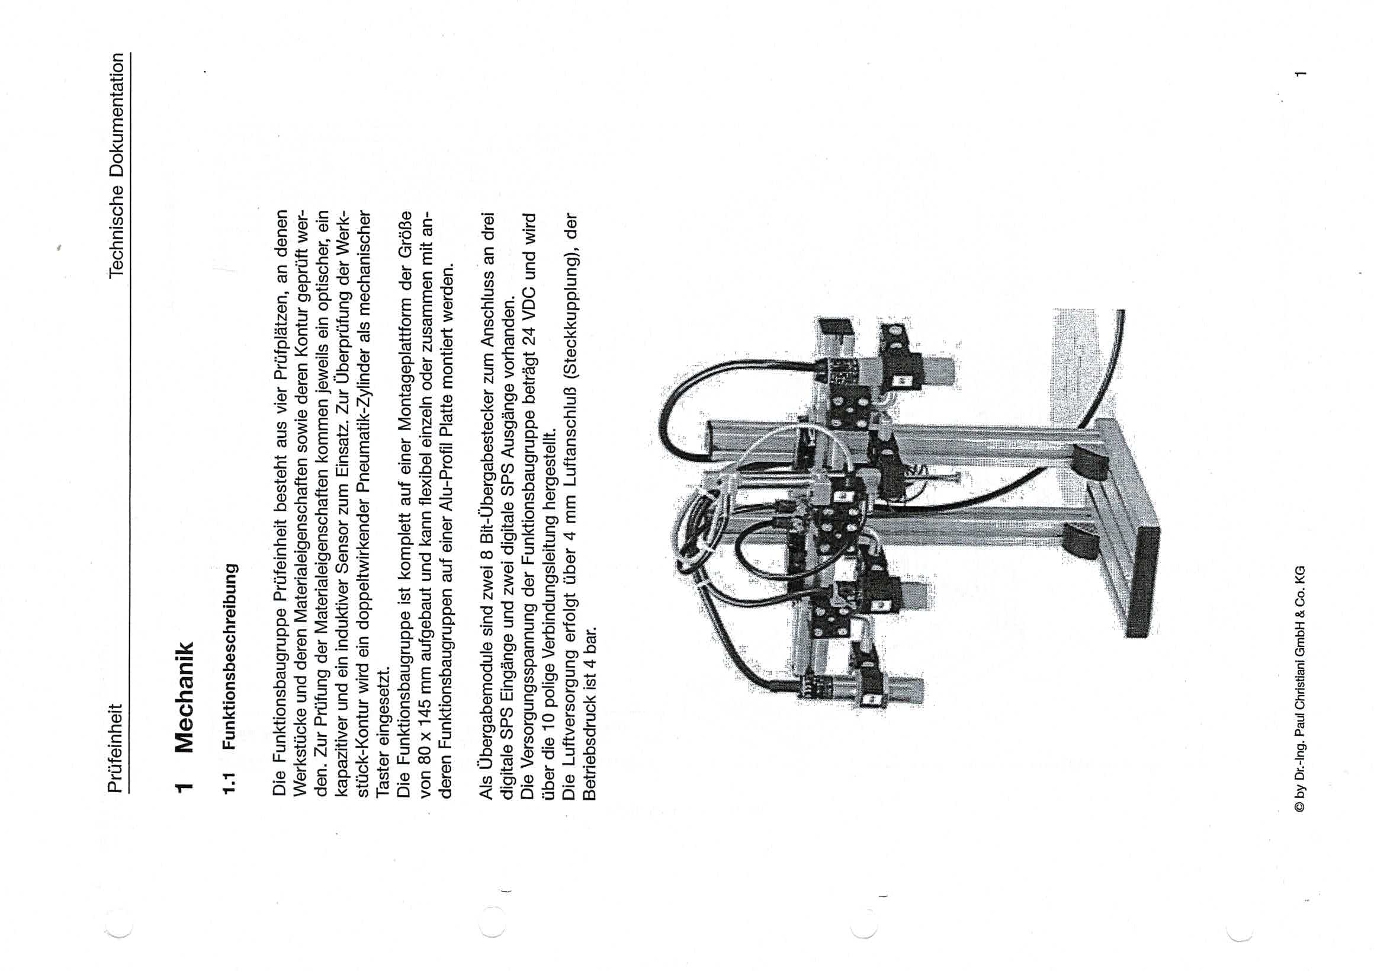
[picture p222: page 1]
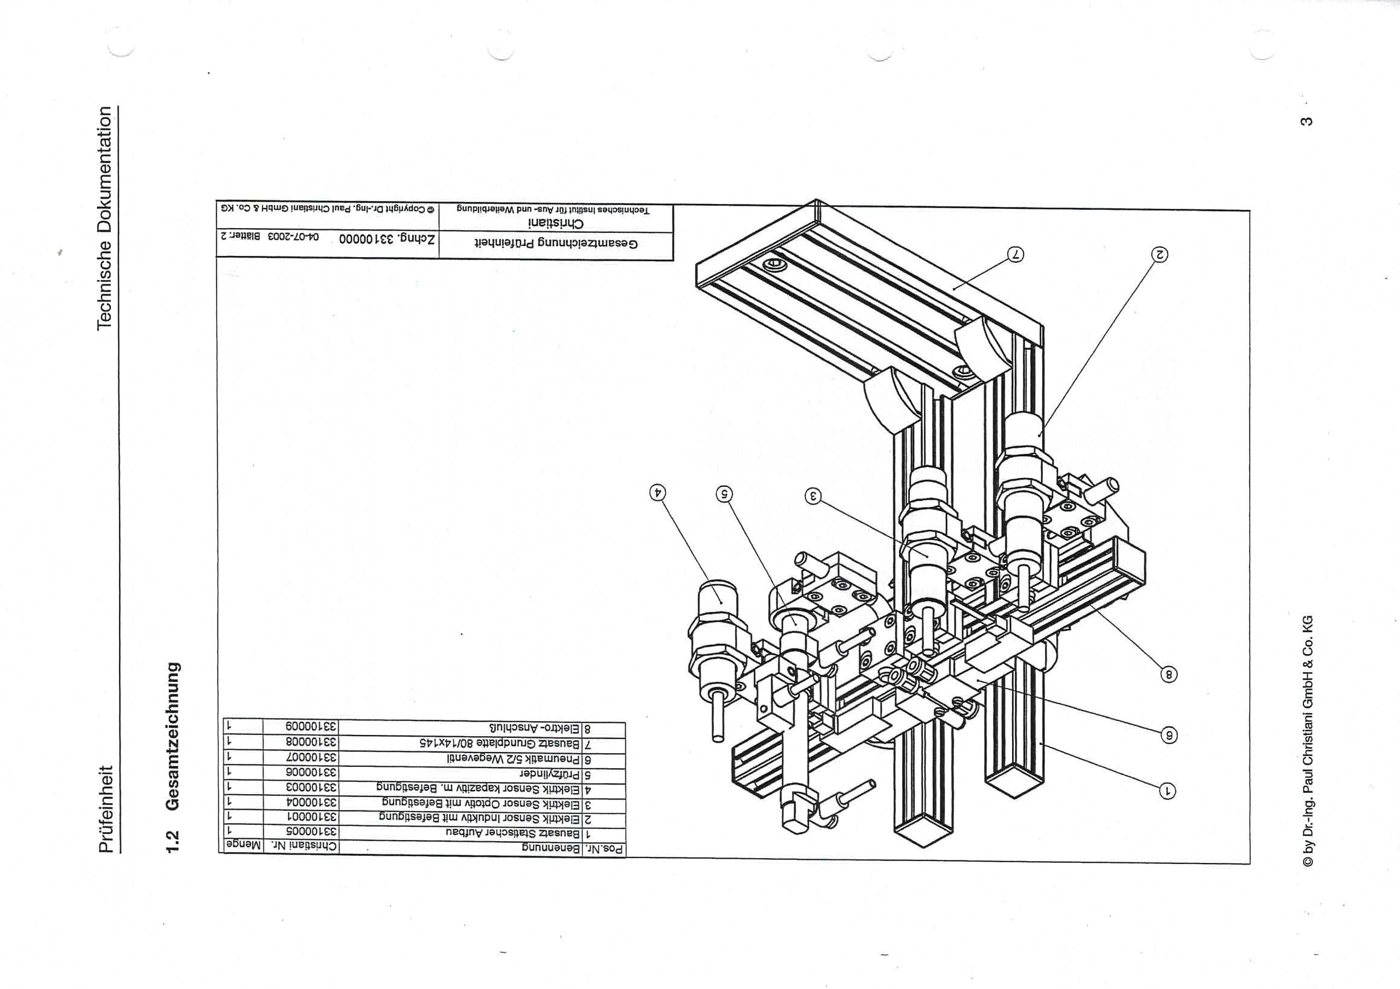
[picture p223: page 2]
