anastasiia-gif/MiniFactoryTCF/Manuals/Original manual/BRWEC5C68B1750E_005646.pdf

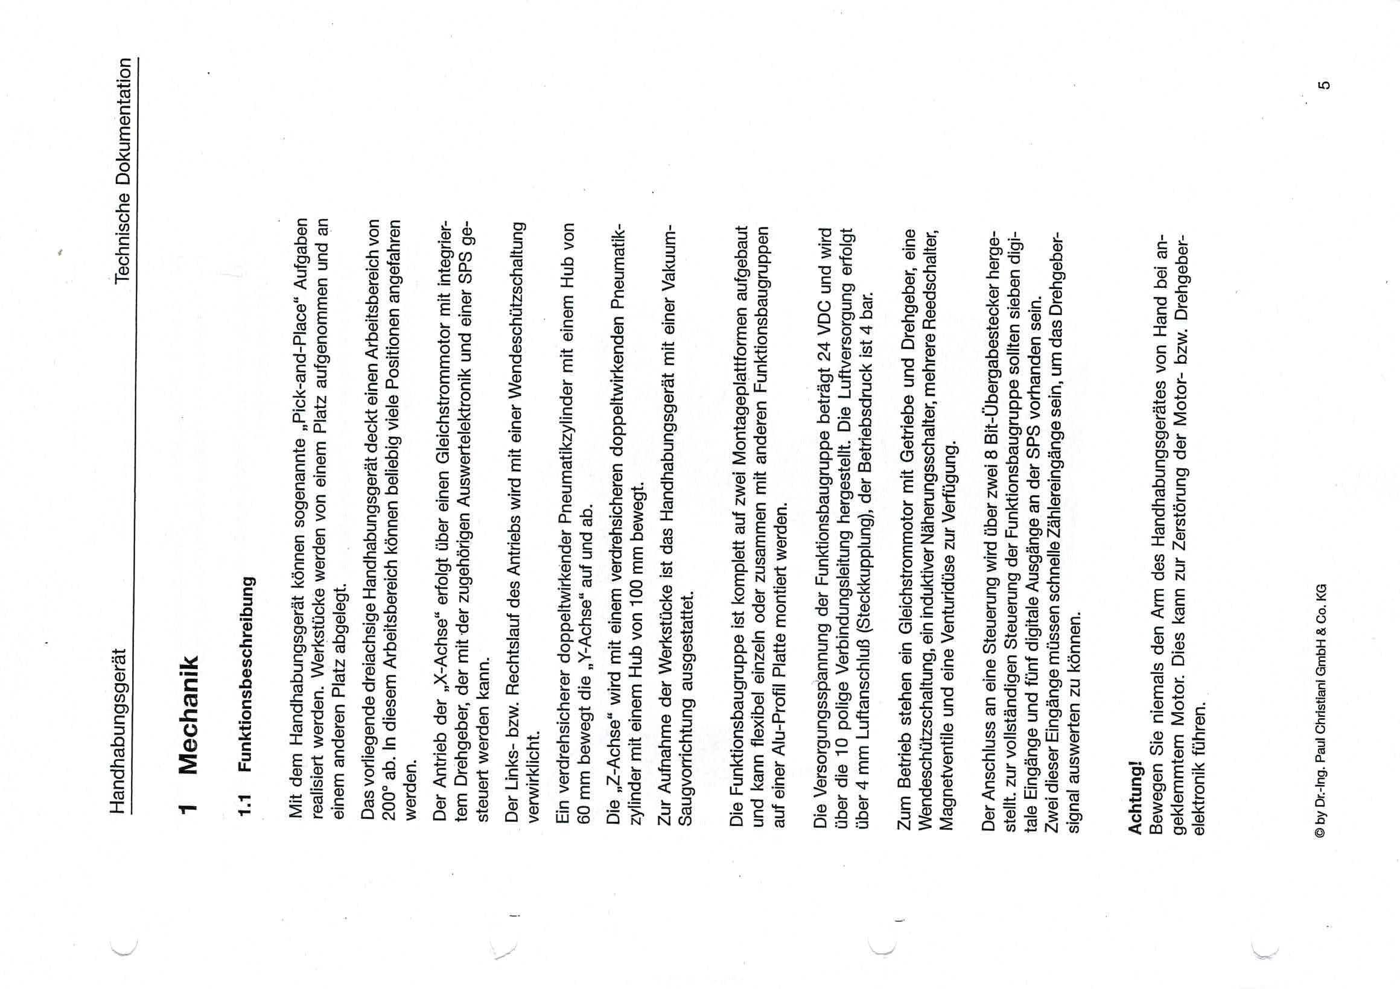
[picture p224: page 1]
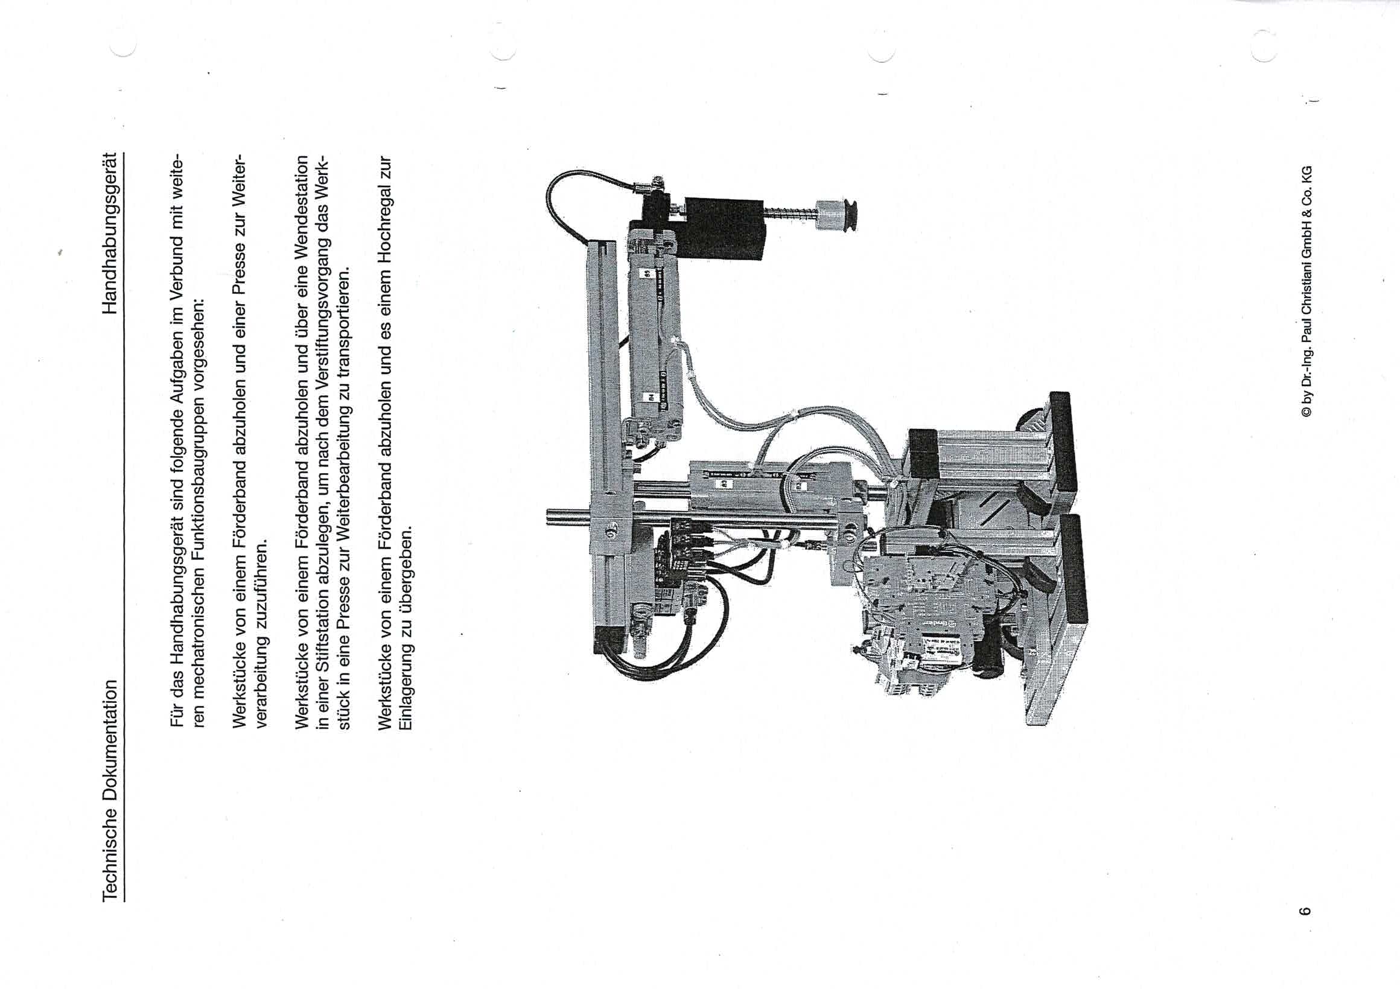
[picture p225: page 2]
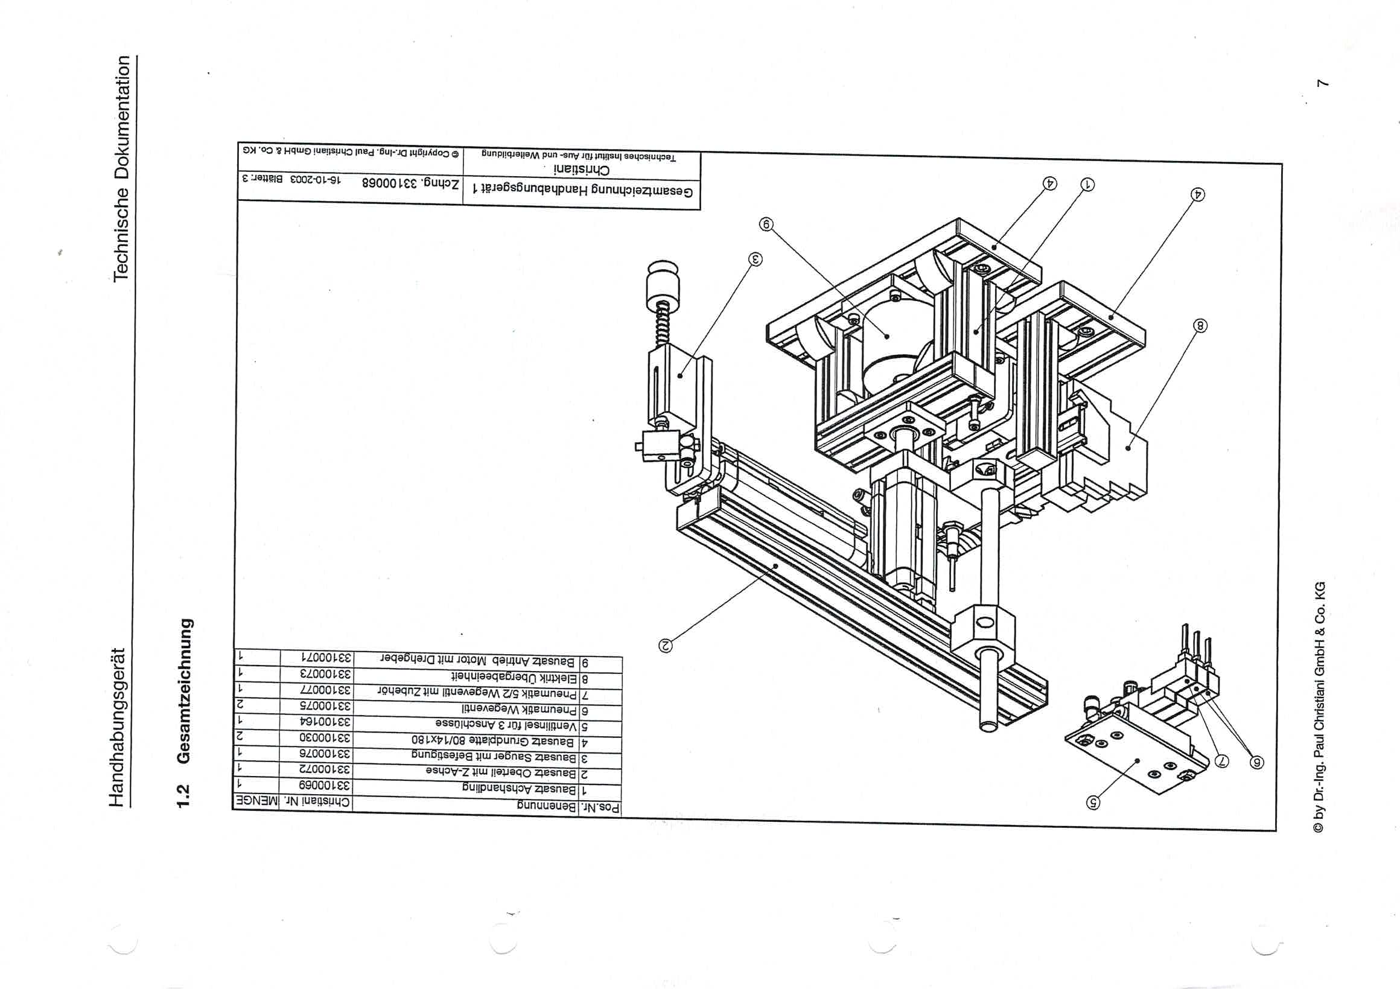
[picture p226: page 3]
