anastasiia-gif/MiniFactoryTCF/Manuals/Original manual/BRWEC5C68B1750E_005649.pdf

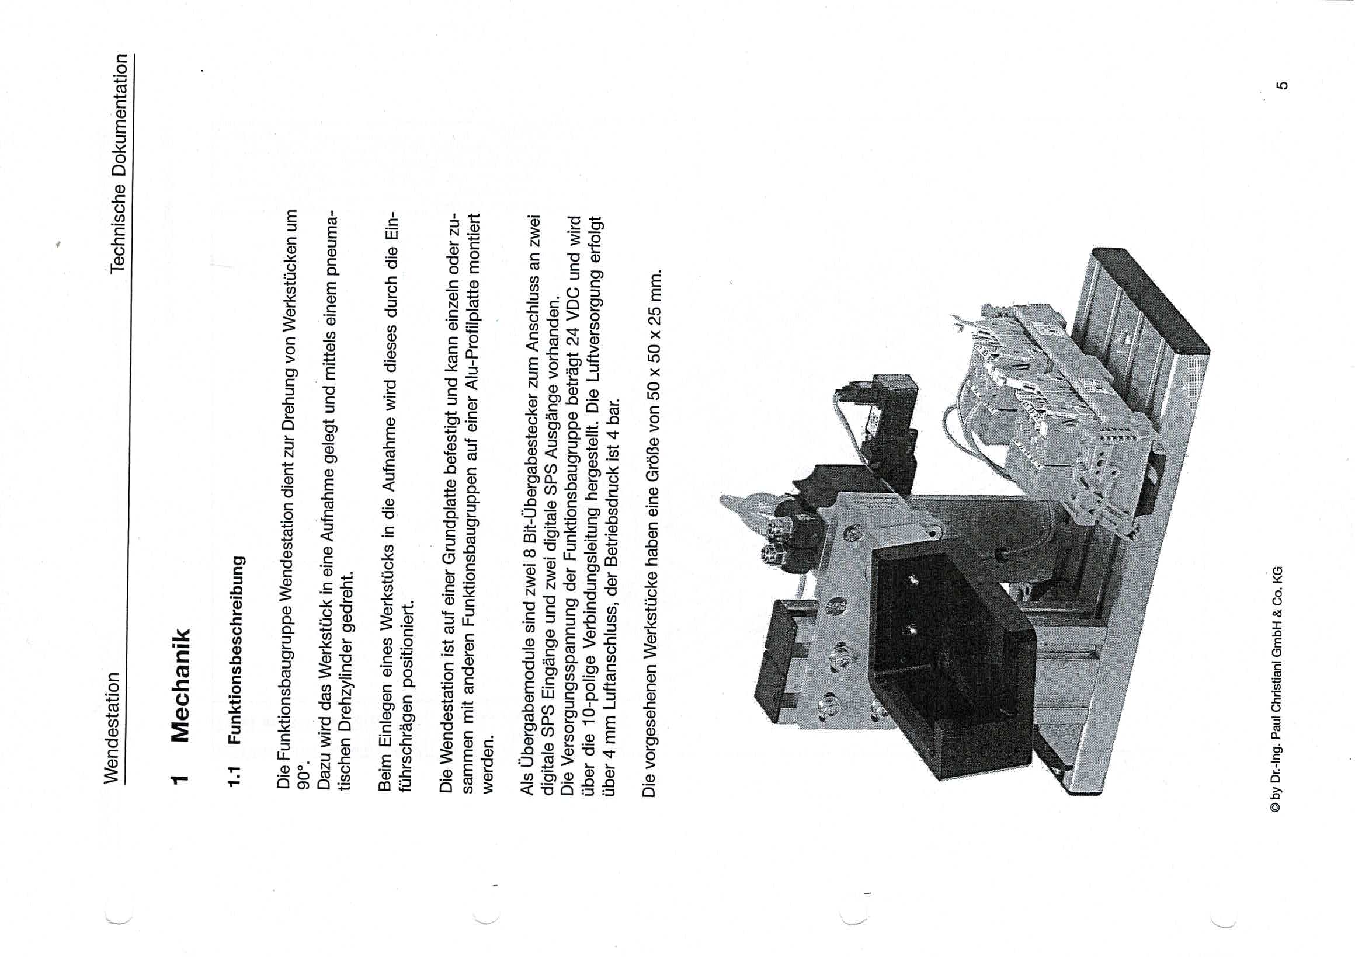
[picture p227: page 1]
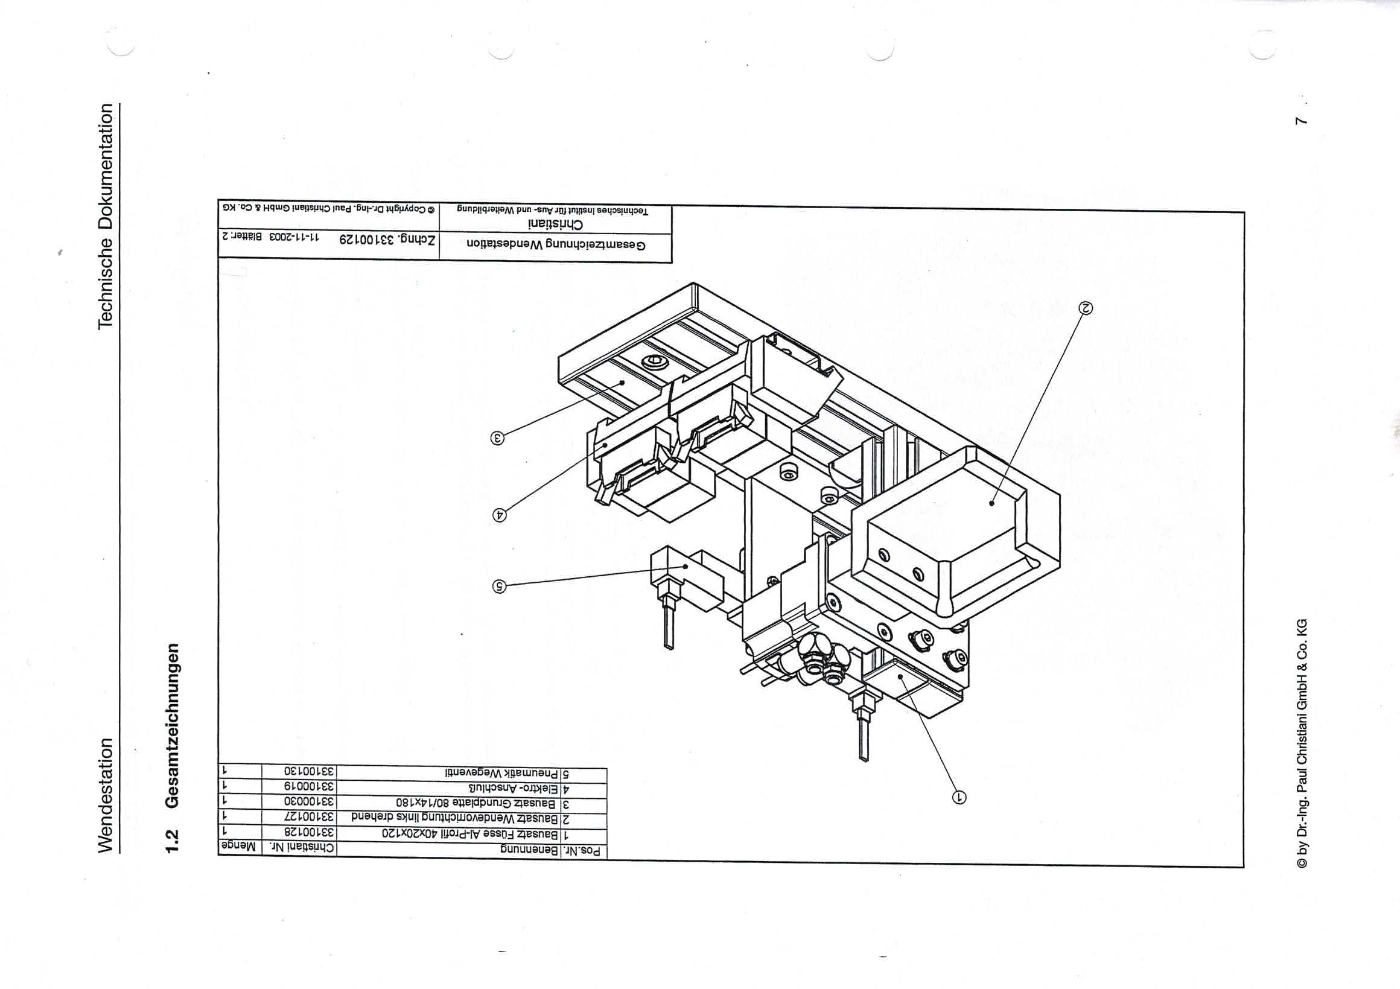
[picture p228: page 2]
