anastasiia-gif/MiniFactoryTCF/Manuals/Original manual/BRWEC5C68B1750E_005651.pdf

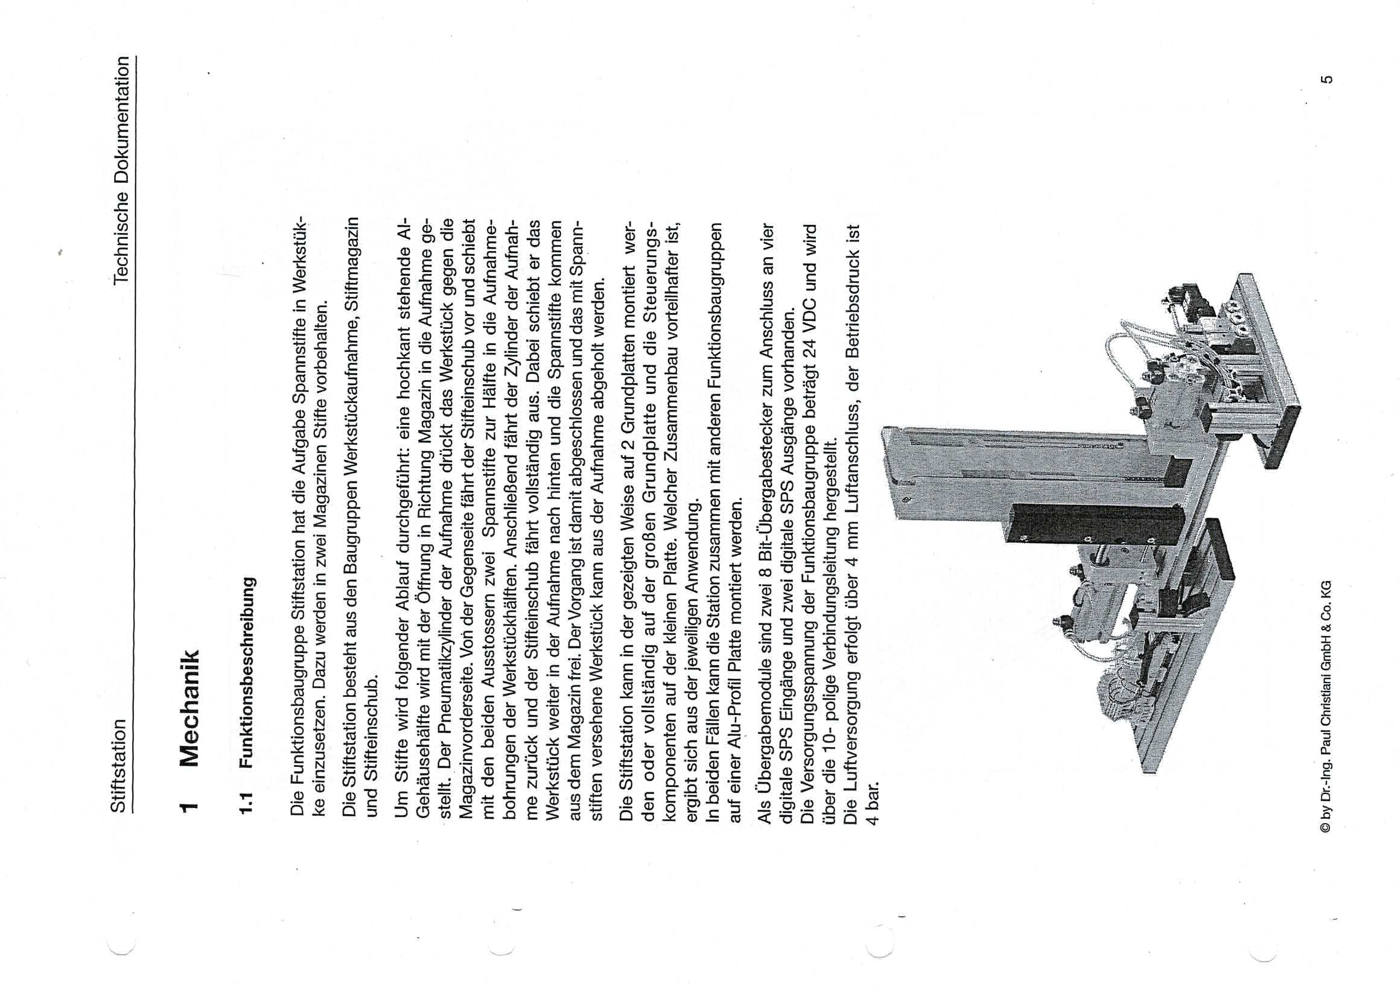
[picture p229: page 1]
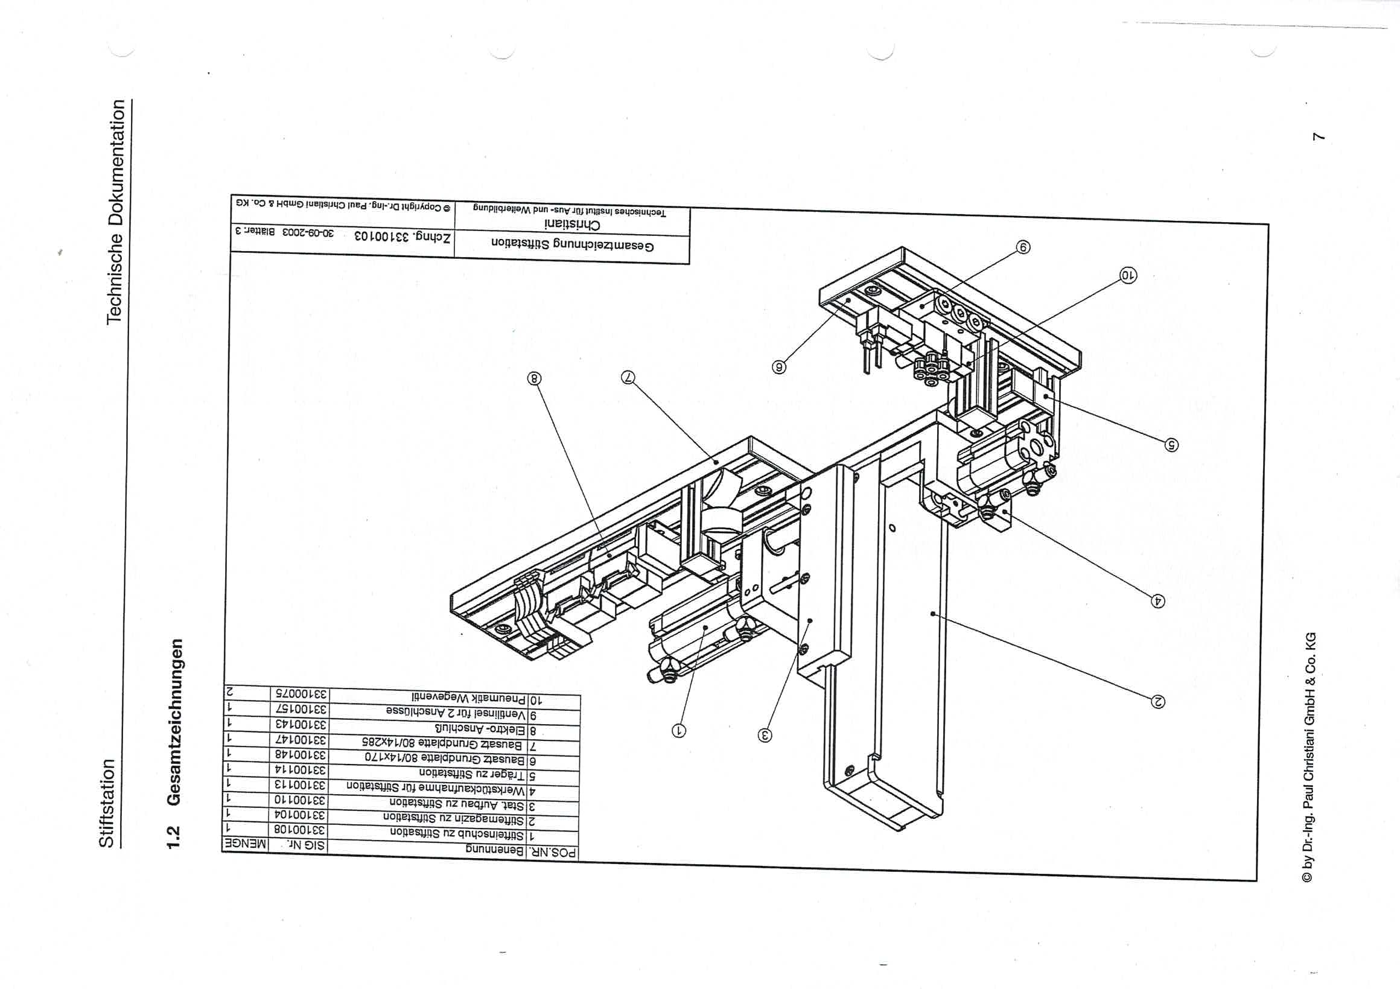
[picture p230: page 2]
