anastasiia-gif/MiniFactoryTCF/Manuals/Original manual/BRWEC5C68B1750E_005653.pdf

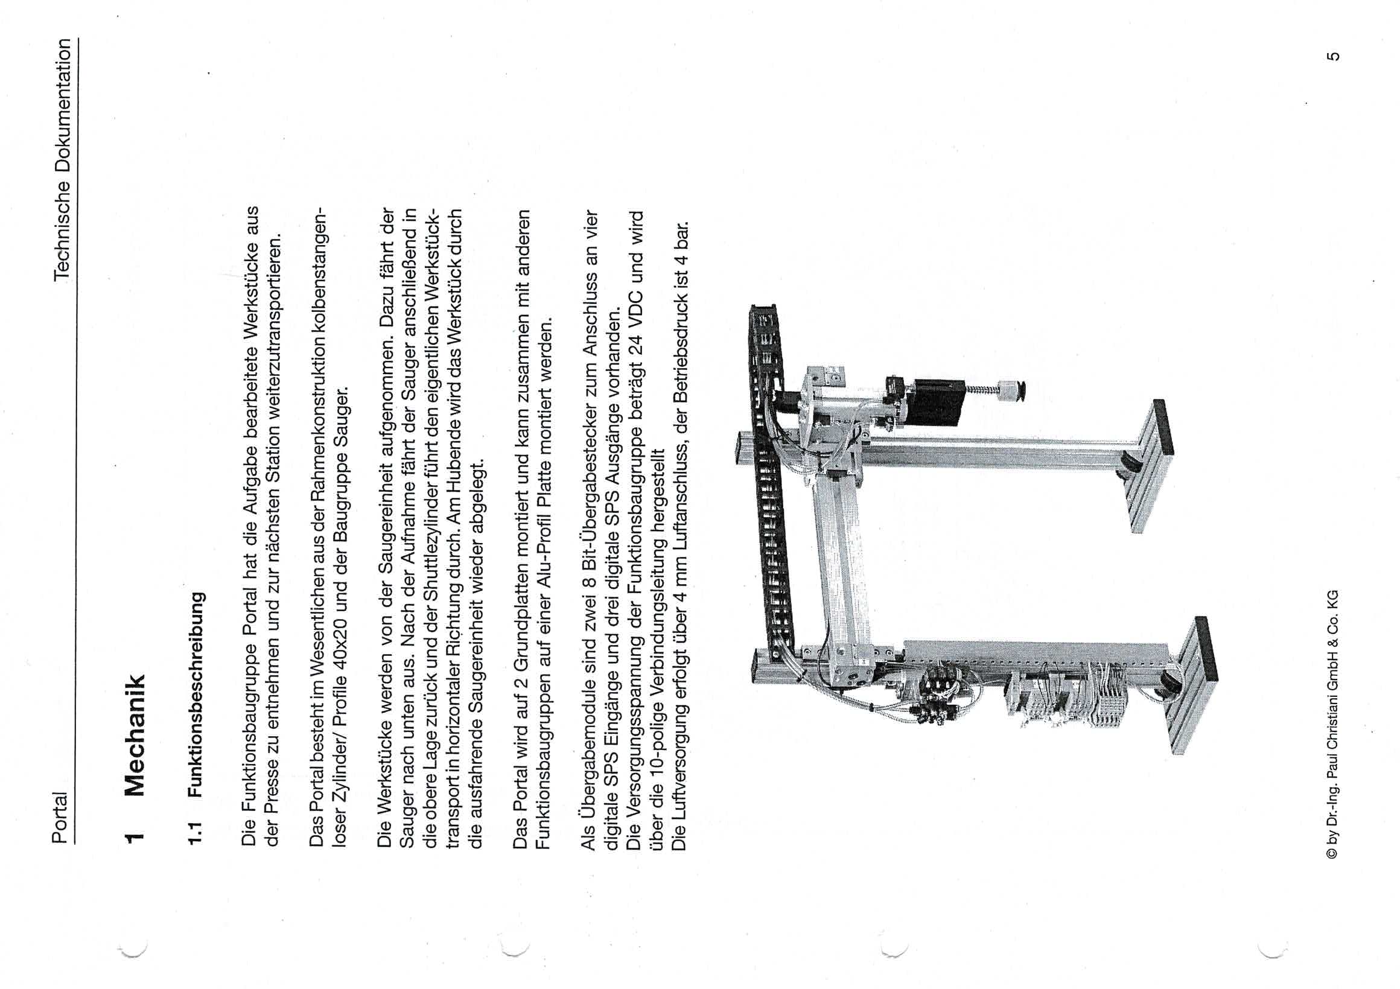
[picture p231: page 1]
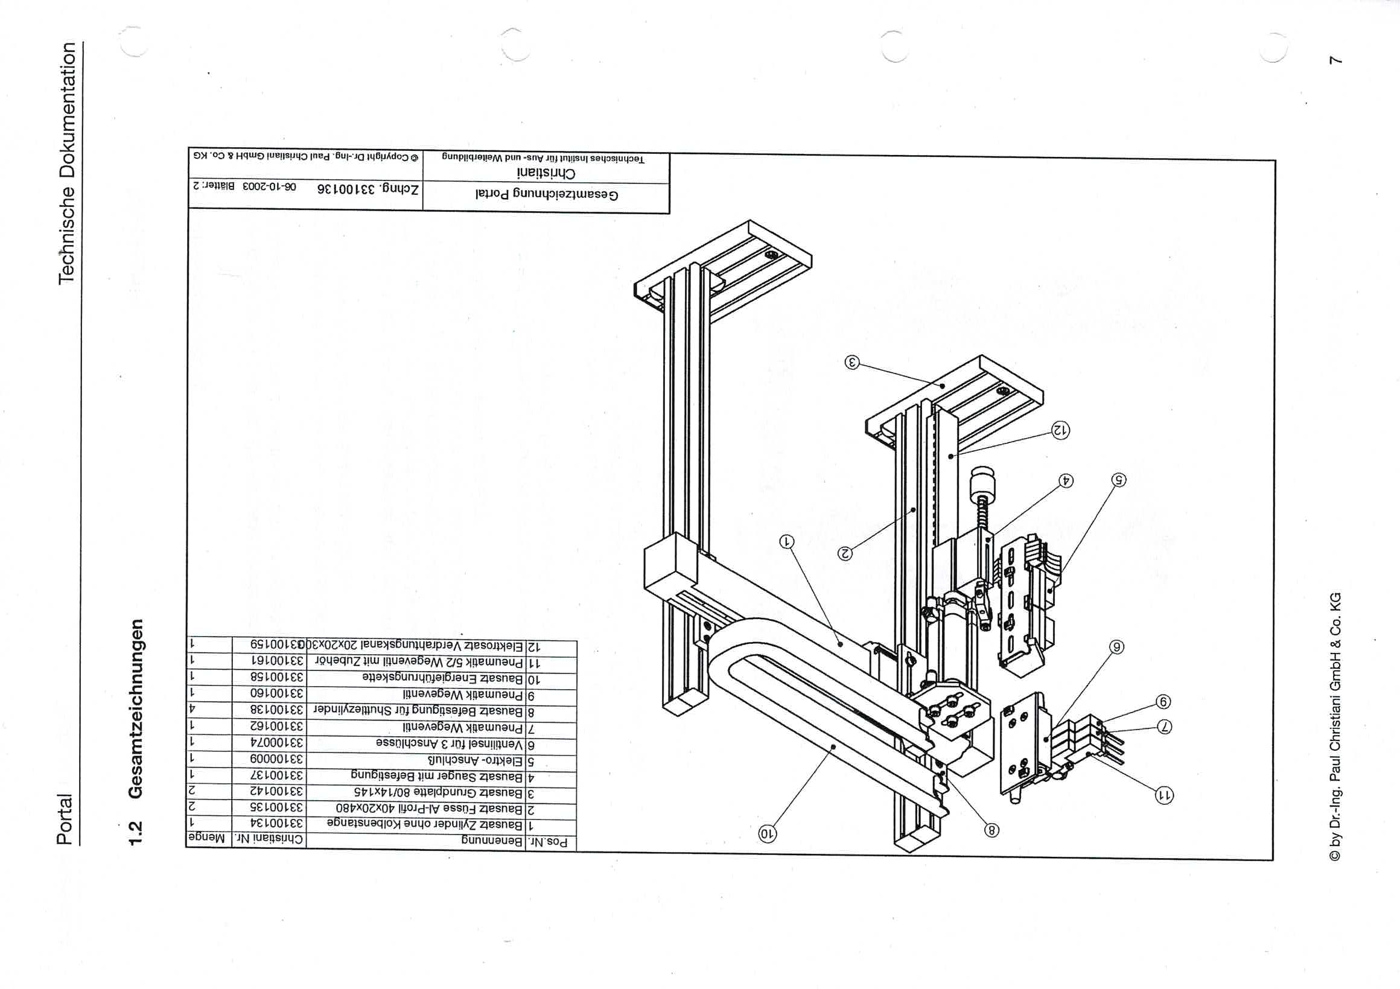
[picture p232: page 2]
