anastasiia-gif/MiniFactoryTCF/Manuals/Original manual/BRWEC5C68B1750E_005655.pdf

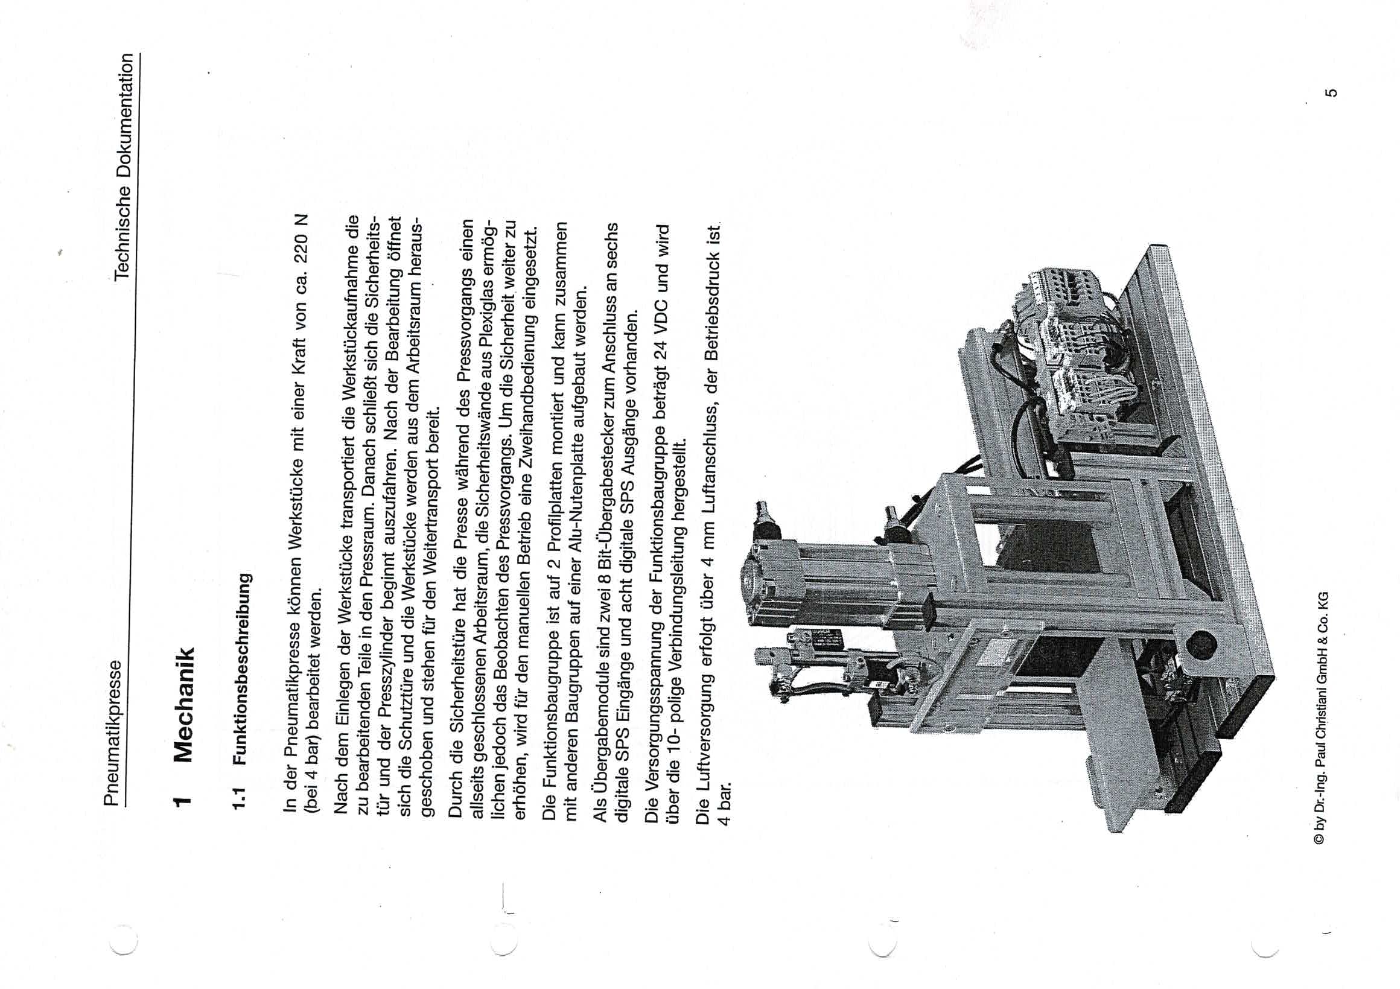
[picture p233: page 1]
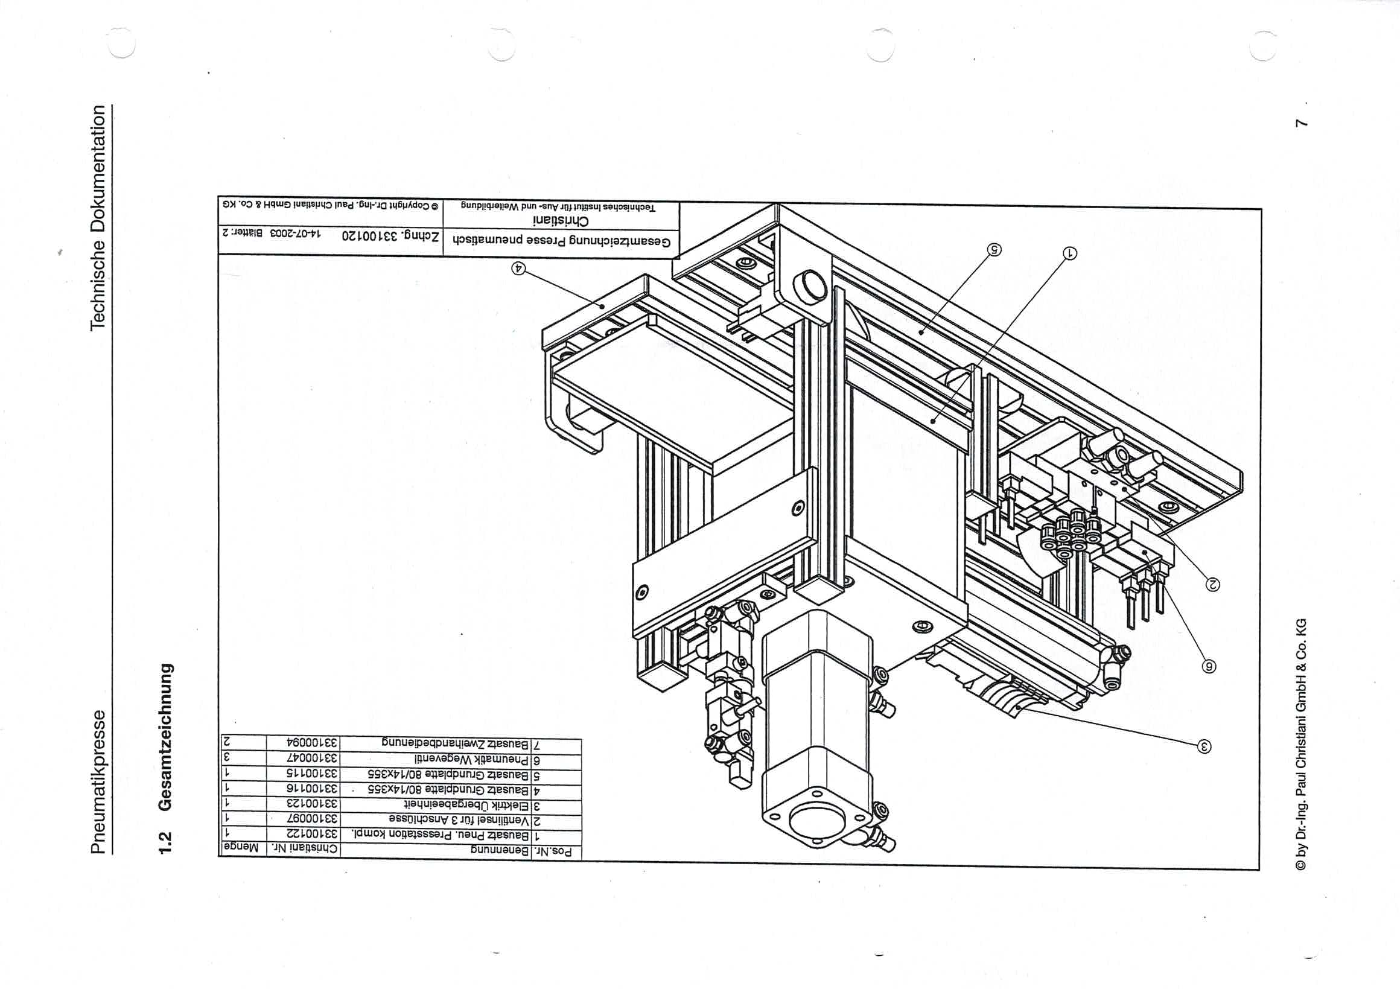
[picture p234: page 2]
