anastasiia-gif/MiniFactoryTCF/Manuals/Original manual/BRWEC5C68B1750E_005657.pdf

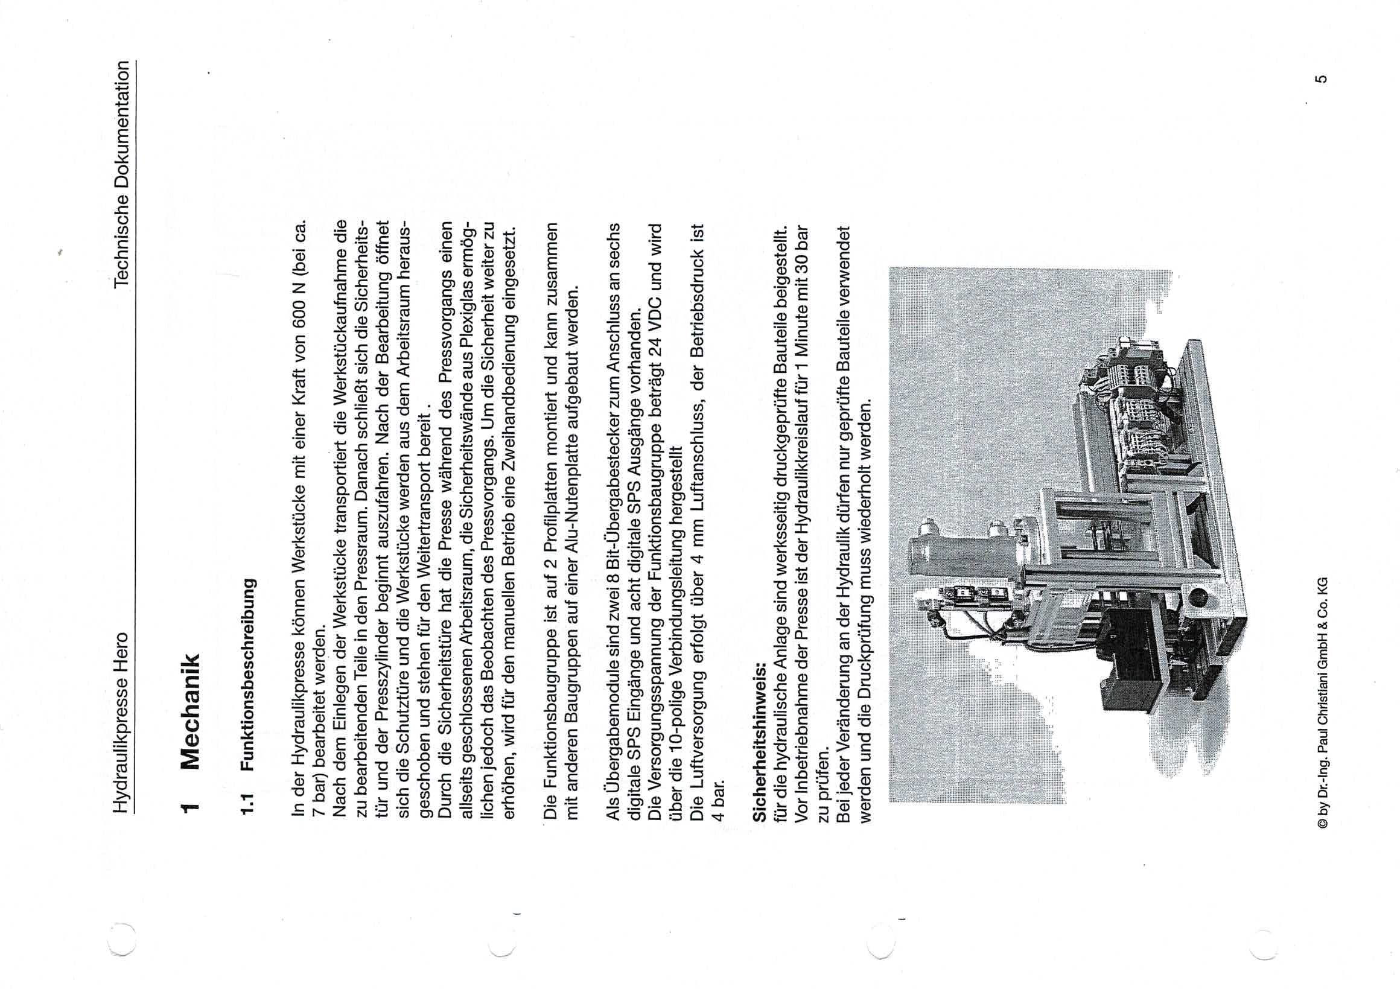
[picture p235: page 1]
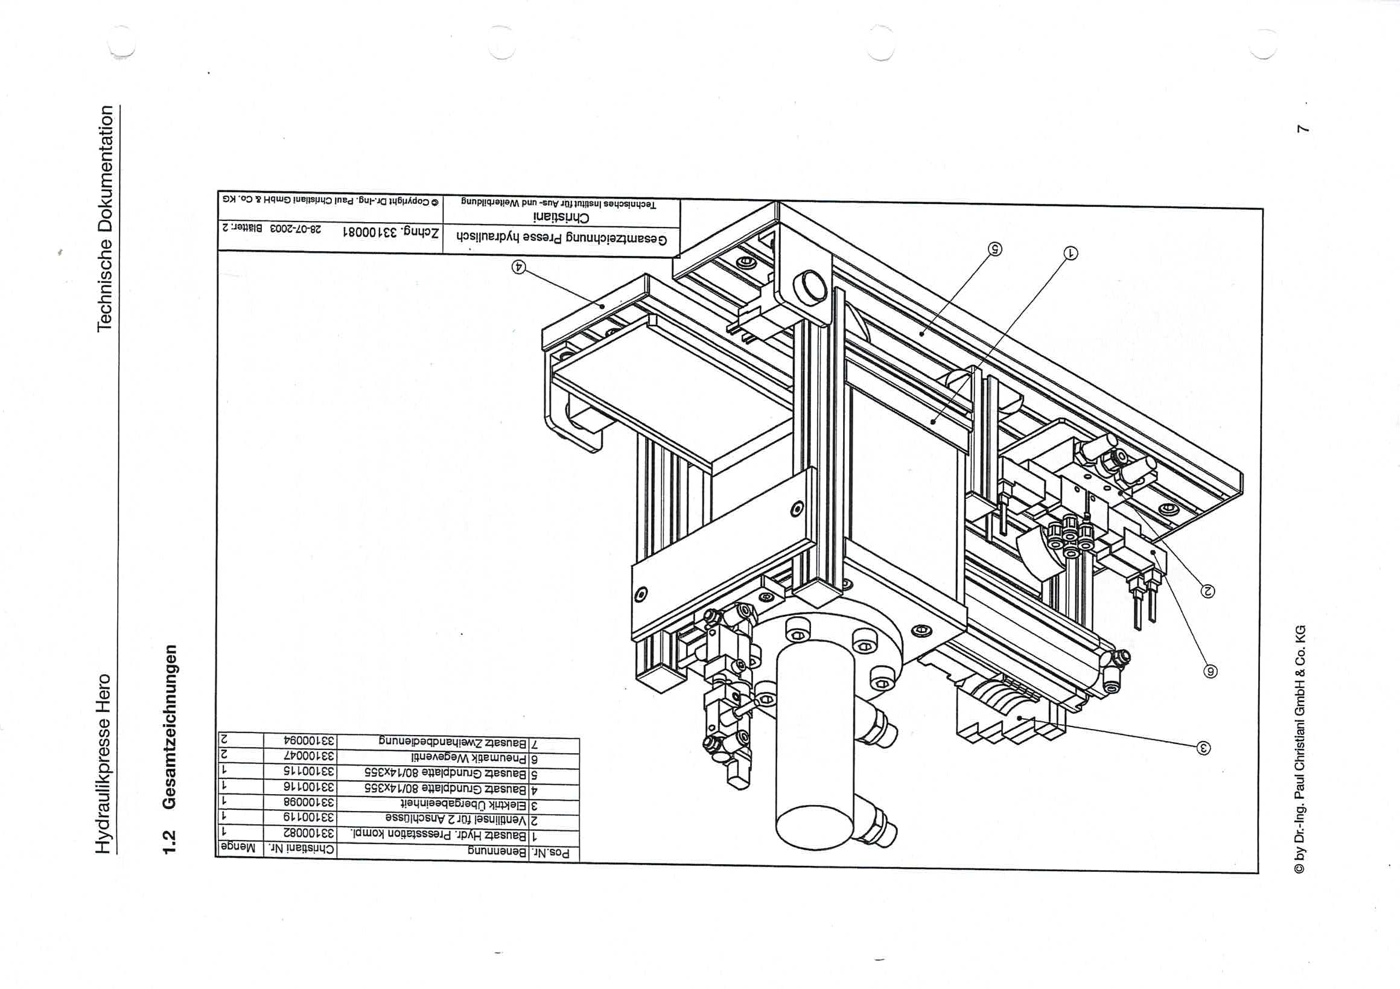
[picture p236: page 2]
