anastasiia-gif/MiniFactoryTCF/(commit log)

2025-05-16 Create ReadMe in Safety in Pneumatics_hydraulics_covers
2025-07-18 Add Side part_inner to Mechanical/Safety
    [Side part_ inner.SLDPRT]
2025-07-18 Replace Main_exposition_inside_right_cover
    [Main_exposition_inside_right_cover.SLDPRT]
2025-07-23 Add all files from Electrical covers
    [Box_deposit.SLDPRT, Box_deposit.STL, button_controller_cover.SLDPRT, button_controller_cover.STL, conveyor_sensor_cover.SLDPRT, conveyor_sensor_cover.STL, linear_actuator_electronics_cover.SLDPRT, linear_actuator_electronics_cover.STL]
